SpaceScienceSweden/ulv_electronics/electronics_design_document.odt

Electronics design document

Umeå Lunar Venture

This purpose of this document is to list some of the design choices in the fieldmill instrument which will hitch a ride to the moon courtesy of PTScientists as part of the Lunar XPrize.

# Overview

The purpose of the experiment is to measure the static electric field on the lunar surface. There are more than one way to do this. After going through the relevant literature it was decided that a traditional fieldmill is the best approach given our time and budget constraints.

There are two fieldmills, mounted at right angles. Each fieldmill has a sensor board with amplifiers as close to the sensor plates as possible. There are three channels on each board (six in total), spaced 120° apart. Each channel consists of two sensor plates, across which a differential measurement is taken, giving six plates ("pie pieces") per fieldmill. The rest of the electronics is housed in a single card stack in the bottom rear of the instrument.

The demodulation of the amplified signals can be done either digitally or in the analog domain. The end result is some set of digital values which will be sent back down to Earth. Having a high dynamic range is important, since the magnitude of the field is not well known. There are two major ways to acheive this: either use one or more PGAs before each ADC, or pick ADCs with very high resolution (32-bit). The latter would almost always be preferable, but high-resolution ADCs are quite limited in speed.

## Unsolved design problems

### Remote programmer

Due to the risk of programming error and unforseen problems there needs to be some way to reprogram the instrument from the ground. Since we are aiming at using an ATmegaS128 something similar to an in-circuit serial programmer is needed. The device needs to be possible to operate with a 2.5 s time lag. One suggestion to solve this is to use some inherently rad-tolerant and simple design. So far an anti-fuse based one-time-programmable (OTP) FPGA seems like the best bet, like the iCE40HX series. This series has the benefit of open source tools. Other devices might also be possible. The idea then is to send commands via radio, which are delivered to the device over UART. Some kind of addressing scheme is needed to differentiate the CPU from the programming tool, since both sit on the same UART. Once all new program data is buffered its hash should be sent back to let the user be absolutely sure everything went OK before pulling the trigger. Something like HMAC should be used to ensure only authorized users can reprogram the instrument.

### Remote debugger

Something like JTAG, if possible.

### TX-only backup telemetry link

In case the radio on the lander fails but we still have power, some kind of low-power one-way link would be useful. Some back-of-the-envelope link budget calculations indicate that a dipole (TX) to 2 m dish (RX) over a distance of 400,000 km would require 10 mJ/bit to transfer reliably. For a typical 100 mW transmitter IC like Si4430 or Si4464 this means a massive 10 bit/s. Since the amount of data per measurement is quite small this is OK.

# Mechanical design

The electronics is built on a stack of cards connected with pin headers. The distance between pins are in multiples of 100 mil (2.54 mm) so that the cards become "breadboard compatible".

An initial guess that 20+20 pins on a square card would be enough was made at the start of summer 2015, and seems to be enough so far. Therefore the dimensions of each card is 50.8x50.8 mm with two 20-pin rows (one on each side) separated 1.9 inch (48.26 mm) from eachother. There is also a notch in the middle of one side to indicate proper orientation. See figure 1 below.

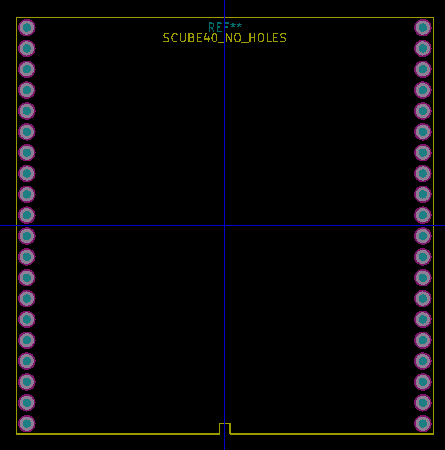
[picture p5: figure]

Fig. 1: Pin placement

# Pin assignment

The pins are assigned in the same order as DIL packages, from the top left order in counter-clockwise direction seen from above.

Text in gray italics indicates an assignment which is deprecated.

## Left side (pins 1-20)

The pins on the left side are counted top-left to bottom-left from 1 to 20.

Pin | Name | Function
1
2
3
4 | EN_APWR | 3.3V signal for enabling analog power (+-12V, +-9V)
5 | CHANNEL | Sets channel on demodulation cards. 0V = channel a, 3.3V = channel b
6 | A0 | Sets AD8250 amplification on fieldmill cards. See AD8250 datasheet
7 | A1
8 | TACHa | Tachometer signal from fieldmill a. +-9V
9 | TACHb | Tachometer signal from fieldmill b. +-9V
10 | GND | Ground
11 | +24V | Raw system voltage provided by lander. May vary depending on battery charge state, amount of sun hitting solar panels etc.. Power limit: 10 W average. May use more power in short bursts, such as when starting motors
12 | /CS_ADCa | Chip select pin for ADC a. Active low
13 | /CS_ADCb | Chip select pin for ADC b. Active low
14 | +3.3V | 3.3V from switching power module. Not suitable for analog circuits
15 | f_ADC | ADC clock
16
17 | +9V | +-9V, linearly regulated from +-12V. Suitable for analog circuits
18 | -9V
19 | +12V | +-12V from switching power module. +-9V is linearly regulated from this bus. 83 mA max. Not suitable for analog circuits
20 | -12V

## Right side (pins 21-40)

The pins on the right side are counted bottom-right to top-right from 21 to 40.

Pin | Name | Function
21 | SCL | I2C bus, clock
22 | SDA | I2C bus, data
23 | MISO | SPI data from slave to master
24 | MOSI | SPI data from master to slave
25 | SCLK | SPI clock
26 | LO2 | Local oscillator for demodulation card 2. 0V - 3.3V
27 | AIN1 | AIN1 (PE3) pin on CPU. Comparator
28 | AIN0 | AIN0 (PE2) pin on CPU. Comparator
29 | ADC3 | ADC3 (PF3) pin on CPU
30 | TX | UART, instrument to lander
31 | RX | UART, lander to instrument
32 | LO1 | Local oscillator for demodulation card 1. 0V - 3.3V
33 | ADC2 | ADC2 (PF2) pin on CPU
34 | ADC1 | ADC1 (PF1) pin on CPU
35 | ADC0 | ADC0 (PF0) pin on CPU
36
37
38
39 | /DRDYb | /DRDY signal from ADC b. Active low
40 | /DRDYa | /DRDY signal from ADC a. Active low

# CPU

We currently plan on using the ATmegaS128 as our main CPU. It is the 3.3V radiation tolerant version of ATmega128, running at a reduced speed of 8 MHz.

# I²C

The following devices are connected to the I2C bus:

- DRV10983 (2)
- MCP3428 (1 or 2)

## I2C bus switches

The DRV10983 has only a single address, 101 0010. Since we need at least two drivers some way to separate the two is needed. Luckily an I2C bus switch like TCA9543A, TCA9544A or PCA9548A can accomplish this.

Of the suggested devices, TCA9543A has the smallest package. It has two channels and its address is 11100xx, where the last two bits are set by pins A0 and A1. The largest one is PCA9548A, which has eight channels and an address of 1110xxx, where the lowest three bits are A0, A1 and A2. This suggests we could put all swiches with eight channels at 11101xx and those with only two channels at 11100xx.

## Addresses

Address | I2C sw channel | I2C sw address | Device
1010010 | 0 | 1110000 | DRV10983 1 on ESC card
1010010 | 1 | 1110000 | DRV10983 2 on ESC card
1101000 | | | MCP3428, demodulator 1 (Adr0=lo, Adr1=lo)
1101010 | | | MCP3428, demodulator 2 (Adr0=lo, Adr1=hi)
1110000 | | | TCA9543A on ESC card

# Fieldmill card

The fieldmill cards are 85x85 mm with M3 holes placed in each corner at (+-35, +-35). There is a 35 mm hole in the middle for the motors to pass through.

## Input stage

The sensor plates on the fieldmill stator are have an extremely high source impedance in the 100-1000 MOhm range. It is therefore very important that the input amplifiers have very low bias currents, preferably much lower than the source current. This is not always possible, so the next best thing would be to keep the bias low enough that the demodulation step is able to remove it.

## Signal levels

Knowing roughly what signal levels we're dealing with will be helpful.

The classical way to calculate sensor currents in a field mill is

V = n f %varepsilon_0 E A R

A = (pi*42² - pi*18²) / 6 = 754 mm² = 7.54e-4 m²

n = 3

e0 = 8.85e-12

f (Hz) | E (V/m) | R | V
100 | 1 | 1M | 2 µV
100 | 1000 | 1M | 2000 µV
100 | 1 | 10M | 20 µV
100 | 1000 | 10M | 20000 µV
100 | 1
100 | 1000

# Digital demodulation

Digital demodulation can be done in two ways: either sampling using the MCU:s internal ADC, or using an external high-precision ADC.

## MCU method

The cheapest way to demodulate the signal (and thus extract its amplitude) is to sample it using the ATmegaS128 via a bias input stage to bring the signals into range and to protect the ADC inputs.

The main limitation of this approach is the speed of the analog-to-digital converter inside the ATmegaS128, and its resolution. For instance, the default configuration in the Arduino library puts it at 10 bit resolution and a maximum sample rate of 9600 Hz. This means there will be some phase offset between channels if more than one channel is sampled at a time, and the dynamic range will be limited.

For digital demodulation to work the signal must be sampled at least four times faster than its fundamental frequency, and appropriately low-pass filtered to avoid aliasing. The reason for sampling the signal four times per cycle instead of the two times implied by the sampling theorem is to extract a complex valued amplitude (I + Q*j). This is done by multiplying the sampled signal by the sine and cosine of the shaft angle times the number of openings in the rotor. The multiplied signals are accumulated in either of two integers, one for the I part and one for Q, on a per-channel basis. The following piece of Arduino code demonstrates this for three channels:

static void interrupt() {

//disable interrupts

sei();

//NOTE: analogRead() is measured as taking 112 µs (9600 Hz)

// keep this in mind

int a = analogRead(0);

int b = analogRead(1);

int c = analogRead(2);

//re-enable interrupts

cli();

unsigned char phase = cursample * (256 * PAIRS / SAMPLES_PER_REV);

//demodulation

I[0] += a*sintab[phase];

Q[0] += a*sintab[(phase2 + 64) % 256];

I[1] += b*sintab[(phase2 + 1) % 256]; //pretend phase offset = 1 brad

Q[1] += b*sintab[(phase2 + 65) % 256];

I[2] += c*sintab[(phase2 + 2) % 256];

Q[2] += c*sintab[(phase2 + 66) % 256];

cursample++;

}

### Limitations

As mentioned in the section above, the main limitation is the speed of the ADC. For example, a 300 Hz signal at four samples per cycle, three channels requires a sample rate of at least 300*4*3 = 3600 Hz. To make the design of the antialiasing filter easier we may need to sample at twice this rate, 7200 Hz. So the ADC is 1.33x as fast as we need it to be, in other words just fast enough.

The second limitation is computing power. Atmel's 8-bit AVRs can perform an 8x8-bit multiplication in 2 cycles and all other 8-bit arithmetic operations in a single cycle. This means we have 8000000 / 7200 ≃ 1000 cycles worth of operations available per sample, or 500 multiplications. A 16x8-bit multiplication is six cycles plus storage, so the demodulation for one sample is on the order of 20 cycles. This means 50x more cycles at our disposal compared to what we need, a comfortably wide margin.

## External high-precision ADC

This idea is quite similar, just replacing the MCU's internal ADC with an external one. The limiting factor then becomes finding a high-precision ADC which can also run at around 10 kSPS. Candidates are AD7177-2 (2.5 µVrms @ 10 kSPS) and ADS1262 (0.466 µVrms @ 14.4 kSPS)

# Analog demodulator

An analog demodulator would consist of a input filter stage to limit the bandwidth of the signal, a mixer to bring it down to DC followed by a low-pass filter to get rid of any higher-order mixing components and to reduce noise. The resulting signal can then be sampled by a slow high-precision ADC.

## Input stage

An active RC band-pass filter would suffice for each channel, or two second-order RC filters (one low-pass and one high-pass).

## Local oscillator

The local oscillator (LO) for the demodulator is generated by the CPU from the active motor's corresponding TACH channel. The CPU can also phase shift this signal by 90° to extract the quadrature part of the sensor signals.

More specifically, the LO is generated by setting up a hardware interrupt on the rising edge of either TACHa or TACHb. The interrupt measures the time taken since the last interrupt, and sets up a timer such that six timer interrupts will happen before the next tachometer interrupt. In each of these six interrupts the LO pin is toggled. The exact positions of these timer interrupts thus determines the phase of the LO signal.

Generating an in-phase LO followed by its quadrature version some time later allows both components to be measured for each sensor channel. This makes the system less sensitive to the exact position of the tachometer relative to the shaft.

## Mixer

For the mixer there are two major variants: using an analog multiplier such as AD633, or a voltage negater followed by an analog mux.

### Analog multiplier

Experiments show that the AD633 is suficiently accurate for our purposes. It is a four-quadrant device, meaning both inputs can be positive or negative. The output is the product of both differential inputs, divided by ten and shifted by a third input:

W = (X1 - X2)(Y1 - Y2)/10 + Z

Each analog multiplier is fed with a sensor signal and an appropriately level shifted and filtered version of the LO. Both signals must be kept within the levels specified in the AD633's datasheet, roughly +-4.25V for a +-9V supply.

The LO should be shifted such that its amplitude is very carefully controlled. A suggestion is to use two 2.5V references to set up a precision +-2.5V rail, followed by an analog mux controlled by the LO. If the resulting signal is appropriately low-pass filtered then the signal going into the mixer will be sinusodial (with an amplitude of 2.5*4/pi ≃ 3.2 V), which helps reduce the amount of harmonics being mixed down to DC. If the maximum amplitude of the sensor signals is +-4V and a bias of Z = 1.024 (half of the ADC reference voltage) then the output of the demodulator falls within 1.024 +- 4*2.5/10 = [0.024, 2.024] V. This falls nicely into the middle of the range of an ADC with a 2.048 Volt reference.

The voltage reference chosen is ADR5041BRTZ-R2, for high accuracy (0.1%) and low temperature coefficient (<75 ppm/°C). REF2925AIDBZR was considered at first, but has much lower accuracy (2%) and higher temperature coefficient (100 ppm/°C).

Inaccuracies in this approach are mostly due to the AD633. There's also some bias currents to account for, both in filters and the input of AD633.

### Voltage negater + analog mux

This approach is based around negating the input signal, then controlling an analog mux with the LO to feed either the original signal or its negated version to the next step. This means the input is multiplied by 1 or -1.

A negater can be formed by an op amp in the inverting configuration with unit gain (both resistances equal).

One major limitation with this approach is that the LO will always be a square wave. On the other hand it is a much simpler design with fewer parts.

Inaccuracies in this approach are mostly due to resistor tolerances on the negaters and the usual bias currents.

## Low-pass filter

This filter acts as the antialiasing filter of the ADC. It must therefore attenuate signals above the Nyquist frequency to below 1 LSB (62.5 µV for MCP3428). A second-order active RC filter with a low enough cutoff frequency can accomplish this task.

## Analog-to-digital converter

A high-precision ADC is needed. Its bandwidth doesn't need to be very large - sampling three 1 Hz channels at four times the Nyquist frequency would require 1*3*4 = 12 samples per second (SPS). The MCP3428 currently used provides 16-bit accuracy at 15 SPS. High-precision ADCs like the AD7177-2 or the ADS1262 mentioned earlier in this document would provide even more precision and almost twice the dynamic range. To be more explicit, the ADS1262 running at its slowest mode with the highest gain is limited by an input noise of 7 nVrms. One LSB at this gain is 2.5/(32*2³¹) = 36 pV, meaning the noise is on the order of 190 LSBs. Dialling the gain down allows measuring up to +-2.5 V, for a total dynamic range of 20*log10(2.5/7e-9) = 171 dB.
