SpaceScienceSweden/ulv_electronics/cpu4/fab/cpu4-1.1-complete/cpu4.png

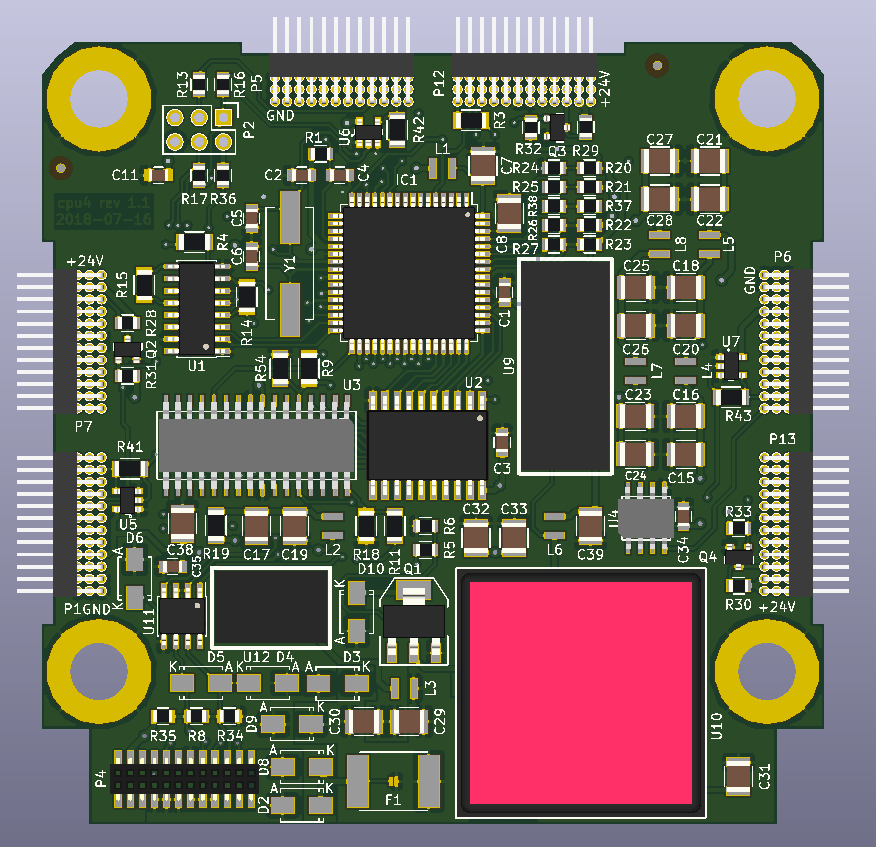
cpu4/fab/cpu4-1.1-complete/cpu4.png
