SpaceScienceSweden/ulv_electronics/credits/uggla.png

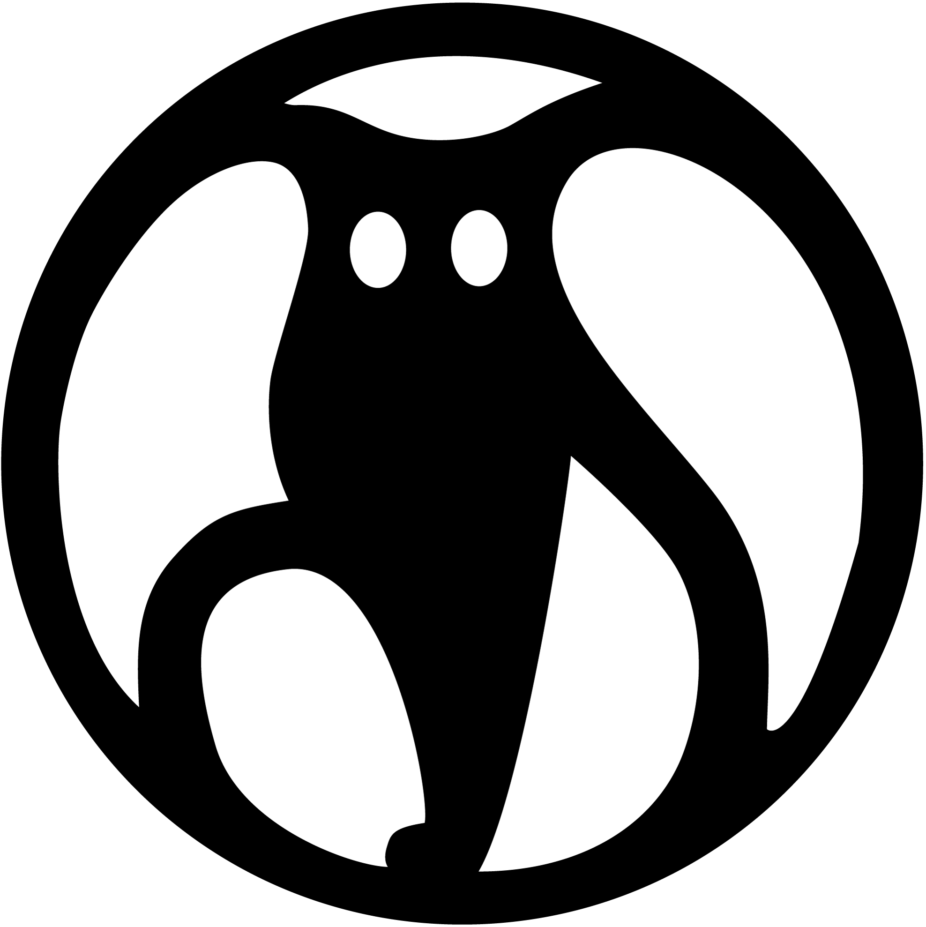
credits/uggla.png
