SpaceScienceSweden/ulv_electronics/cpu4/fab/cpu4-1.1-complete/cpu4_reel_specs.ods

Component | References | Value | Kapselns riktning på bandet | Relevant figur | Länk | Footprint | Quantity Per PCB | Mfg. Name | Mfg. Part Number | Digikey PN | Farnell PN | Elfa PN | Mouser PN | Min temp | Max temp | Digikey Link | Farnell Link | Elfa Link
1 | C1 C2 C3 C4 C34 C35 | 100n | Vertikal |  | https://product.tdk.com/info/en/catalog/spec/mlccspec_automotive_soft_en.pdf | C_0805 | 6 | TDK | CGA4J3X7T2E104M125AE | 445-7965-1-ND | 2211003 |  | 810-CGA4J3X7T2E104MS | -55 | 125 | https://www.digikey.se/product-detail/en/tdk-corporation/CGA4J3X7T2E104M125AE/445-7965-1-ND/2782533 | https://se.farnell.com/tdk/cga4j3x7t2e104m125ae/cap-mlcc-x7t-100nf-250v-0805/dp/2211003
2 | C7 C8 | 100n | Vertikal, size code G3 |  | https://industrial.panasonic.com/cdbs/www-data/pdf/RDI0000/DMI0000COL24.pdf | C_1210 | 2 | Panasonic | ECH-U1C104GX5 | PCF1189CT-ND | 9695001 | 300-41-614 | 667-ECH-U1C104GX5 | -55 | 125 | https://www.digikey.se/product-detail/en/panasonic-electronic-components/ECH-U1C104GX5/PCF1189CT-ND/353736 | https://se.farnell.com/panasonic-electronic-components/echu1c104gx5/cap-film-pps-100nf-16v-smd/dp/9695001 | https://www.elfa.se/sv/kondensator-100-nf-16-vdc-panasonic-automotive-industrial-systems-echu1c104gx5/p/30041614
3 | C15 C16 C17 C18 C19 C20 C21 C22 C23 C24 C25 C26 C27 C28 C32 C33 | 10u10V | Vertikal |  | https://content.kemet.com/datasheets/KEM_C1008_X8L_150C_SMD.pdf | C_1210 | 16 | KEMET | C1210X106K8NACAUTO | 399-17273-1-ND |  |  | 80-C1210X106K8NAUTO | -55 | 150 | https://www.digikey.se/product-detail/en/kemet/C1210X106K8NACAUTO/399-17273-1-ND/8602584
4 | C29 C30 C31 C38 C39 | 10u50V | Vertikal | Samma som rad 1 | https://product.tdk.com/info/en/catalog/spec/mlccspec_automotive_soft_en.pdf | C_1210 | 5 | TDK | CGA6P3X7S1H106K250AE | 445-8792-1-ND | 2435524 |  | 810-CGA6P3X7S1H106KS | -55 | 125 | https://www.digikey.se/product-detail/en/tdk-corporation/CGA6P3X7S1H106K250AE/445-8792-1-ND/3248604 | https://se.farnell.com/tdk/cga6p3x7s1h106k250ae/kond-mlcc-x7s-10uf-50v-1210/dp/2435524
5 | C5 C6 | 22p | Vertikal | Samma som rad 3 | https://content.kemet.com/datasheets/KEM_C1008_X8L_150C_SMD.pdf | C_0805 | 2 | KEMET | C0805X220J5GACTU | 399-7432-1-ND |  |  | 80-C0805X220J5G | -55 | 125 | https://www.digikey.se/product-detail/en/kemet/C0805X220J5GACTU/399-7432-1-ND/3317466
6 | D4 D5 D6 | 12V | Bidirektionell, inga träffar på ”Rollenspezifikation 824501121” | ? | ? | SMA_Standard | 3 | Würth | 824501121 | 732-9949-1-ND | 2536587 | 300-59-541 | 710-824501121 | -65 | 150 | https://www.digikey.se/product-detail/en/wurth-electronics-inc/824501121/732-9949-1-ND/5871103 | https://se.farnell.com/wurth-elektronik/824501121/tvs-diod-400w-12v-dbl-rikt-do/dp/2536587 | https://www.elfa.se/sv/transientskyddsdiod-12-400-sma-wuerth-elektronik-824501121/p/30059541
7 | D3 D9 D10 | 40V | Bidirektionell, inga träffar på ”Rollenspezifikation 824501401” | ? | ? | SMA_Standard | 3 | Würth | 824501401 | 732-9960-1-ND | 2536561 | 300-59-556 | 710-824501401 | -65 | 150 | https://www.digikey.se/product-detail/en/wurth-electronics-inc/824501401/732-9960-1-ND/5871113 | https://se.farnell.com/wurth-elektronik/824501401/tvs-diod-400w-40v-dbl-rikt-do/dp/2536561 | https://www.elfa.se/sv/transientskyddsdiod-40-400-sma-wuerth-elektronik-824501401/p/30059556
9 | F1 | Polyfuse_Small | Vertikal |  | https://belfuse.com/resources/CircuitProtection/datasheets/0ZCF%20Nov2016.pdf | Fuse_SMD2920 | 1 | Bel Fuse Inc. | 0ZCF0100AF2A | 507-2070-1-ND |  |  | 530-0ZCF0100AF2A | -40 | 85 | https://www.digikey.se/product-detail/en/bel-fuse-inc/0ZCF0100AF2A/507-2070-1-ND/6210547
8 | D2 D8 | STTH102A | Vertikal, katod överst |  | https://www.st.com/content/ccc/resource/technical/document/technical_note/1f/54/8e/63/63/81/4a/ea/DM00111342.pdf/files/DM00111342.pdf/jcr:content/translations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 | SMA_Standard | 2 | STMicroelectronics | STTH102A | 497-2500-1-ND | 9907874 | 300-34-074 | 511-STTH102A | -65 | 175 | https://www.digikey.se/product-detail/en/stmicroelectronics/STTH102A/497-2500-1-ND/603882 | https://se.farnell.com/stmicroelectronics/stth102a/diode-ultrafast-1a-200v-sma/dp/9907874 | https://www.elfa.se/sv/likriktardiod-sma-200-st-stth102a/p/30034074
10 | IC1 | ATMEGA128L-8AN | 14x14 mm TQFP 64-pin → pinne 1 = upp, höger (kvadrant 2 i figur) |  | http://ww1.microchip.com/downloads/en/DeviceDoc/00000151Q.pdf | TQFP-64_14x14mm_Pitch0.8mm | 1 | Microchip Technology / Atmel | ATmega128L–8AN | ATMEGA128L-8AN-ND |  |  | 556-ATMEGA128L-8AN | -40 | 105 | https://www.digikey.se/product-detail/en/microchip-technology/ATMEGA128L-8AN/ATMEGA128L-8AN-ND/2050766
11 | L1 L2 L3 L4 L5 L6 L7 L8 | 10u | Vertikal |  | https://katalog.we-online.de/pbs/datasheet/74479887310A.pdf | L_1008 | 8 | Würth | 74479887310A | 732-4516-1-ND |  | 300-63-549 | 710-74479887310A | -40 | 125 | https://www.digikey.se/product-detail/en/wurth-electronics-inc/74479887310A/732-4516-1-ND/4120134 |  | https://www.elfa.se/sv/drossel-smd-10-uh-850-ma-20-wuerth-elektronik-74479887310a/p/30063549
14 | Q1 | IRLL024NPBF | Tabb (pinne 4) uppåt |  | http://info.incomp.hu/NETPDF/IRLL024NPBF.pdf | SOT-223 | 1 | Infineon Technologies | IRLL024NPBF | IRLL024NPBF-ND | 8651205 | 171-37-904 | 942-IRLL024NPBF | -55 | 150 | https://www.digikey.se/product-detail/en/infineon-technologies/IRLL024NPBF/IRLL024NPBF-ND/856814 | https://se.farnell.com/infineon/irll024npbf/mosfet-n-55v-4-4a-sot-223/dp/8651205 | https://www.elfa.se/sv/mosfet-55-sot-223-ir-irll024npbf/p/17137904
15 | Q2 Q3 Q4 | PMBF170 | Enskild pinne 3 = uppåt |  | https://assets.nexperia.com/documents/packing/SOT23_185.pdf | SOT-23 | 3 | Nexperia | PMBF170,215 | 1727-5173-1-ND | 1081473 | 171-30-701 | 771-PMBF170-T/R | -65 | 150 | https://www.digikey.se/product-detail/en/nexperia-usa-inc/PMBF170215/1727-5173-1-ND/2531764 | https://se.farnell.com/nexperia/pmbf170-215/mosfet-n-sot-23/dp/1081473 | https://www.elfa.se/sv/liten-signaltransistor-sot-23-60-nxp-pmbf170/p/17130701
25 | U3 | 71V124SA12YGI | ”IDT reel specification” ger inga relevanta länkar |  | https://www.idt.com/document/dst/71v124sa-datasheet | SOJ-32 | 1 |  |  | 800-1460-5-ND |  |  | 972-71V124SA12YGI | -40 | 85 | https://www.digikey.se/product-detail/en/idt-integrated-device-technology-inc/71V124SA12YGI/800-1460-5-ND/1915761
26 | U1 | CD74AC153M96 | Pinne 1 = upp, vänster |  | http://www.ti.com/lit/ds/symlink/cd74ac153.pdf | SOIC-16_3.9x9.9mm_Pitch1.27mm | 1 | Texas Instruments | CD74AC153M96 | 296-4229-1-ND | 2334932 |  | 595-CD74AC153M96 | -55 | 125 | https://www.digikey.se/product-detail/en/texas-instruments/CD74AC153M96/296-4229-1-ND/375128 | http://se.farnell.com/texas-instruments/cd74ac153m96/data-selector-mux-dual-4-1-soic/dp/2334932
27 | U4 | DS18B20Z+ | Pinne 1 = upp, vänster |  | https://www.maximintegrated.com/en/design/packaging/package-information/smd-tape-reel-info.html | SOIC-8-N | 1 | Maxim Integrated | DS18B20Z+ | DS18B20Z+-ND | 2518724 |  | 700-DS18B20Z | -55 | 125 | https://www.digikey.se/product-detail/en/maxim-integrated/DS18B20Z/DS18B20Z-ND/956982 | https://se.farnell.com/maxim-integrated-products/ds18b20z/ic-thermometer-12bit-0-5degc-soic/dp/2518724
28 | U11 | MAX3483ESA+ | Samma som DS18B20Z+ | -"- | -"- | SOIC-8_3.9x4.9mm_Pitch1.27mm | 1 | Maxim Integrated | MAX3483ESA+ | MAX3483ESA+-ND | 2519249 |  | 700-MAX3483ESA | -40 | 85 | https://www.digikey.se/product-detail/en/maxim-integrated/MAX3483ESA/MAX3483ESA-ND/1702246 | https://se.farnell.com/maxim-integrated-products/max3483esa/ic-transceiver-rs422-rs485-8soic/dp/2519249
29 | U2 | SN74AHC573 | Pinne 1 = upp, vänster |  | http://www.ti.com/lit/ds/symlink/sn74ahc573.pdf | SO-20 | 1 | Texas Instruments | SN74AHC573DW | 296-4612-5-ND | 1287471 | 300-22-908 | 595-SN74AHC573DW | -40 | 85 | https://www.digikey.se/product-detail/en/texas-instruments/SN74AHC573DW/296-4612-5-ND/375821 | https://se.farnell.com/texas-instruments/sn74ahc573dw/latch-d-type-octal-smd-soic20/dp/1287471 | https://www.elfa.se/sv/logikkrets-so-20-sn74ahc573-texas-instruments-sn74ahc573dw/p/30022908
30 | Y1 | 14.7456 MHz | Vertikal |  | https://abracon.com/Resonators/abls.pdf | Crystal_HC49-SD_SMD | 1 | Abracon | ABLS-14.7456MHZ-K4T | 535-9946-1-ND |  |  | 815-ABLS-14.74MK4-T | -40 | 125 | https://www.digikey.se/product-detail/en/abracon-llc/ABLS-14.7456MHZ-K4T/535-9946-1-ND/2001569
