SpaceScienceSweden/ulv_electronics/fieldmill10/fab/fieldmill10-rev4.3/fieldmill10_reel_specs.ods

 | Design | Revision |  | Revisionshistorik
 | fieldmill10 | 4.2 | Grön = ändrad mellan 4.0 → 4.1 | 4.0 → 4.1: Ändrade 10 µF komponentval (item 3) Korrigerade Elfa artikelnr (item 8) Tog bort R8 men röd färg var något tvetydligt. Även fel antal på den raden (item 13) Bytte 50 Ohm → 49.9 Ohm (item 19)
 |  |  | Blå = ändrad mellan 4.1 → 4.2 | 4.1 → 4.2: Ändrade färg på ändrade celler i item 13 till blå, för att signalera en förändring och att inte allihop ska tas bort Korrigerade även antal till 5 på item 13 Tog bort gul och röd från färgskalan, gjorde så att celler markeras med en färg som hör till revisionsförändring istället
ITEM | Antal | Info | Position | Kapselns riktning på bandet | Relevant figur | Länk | Benämning Typ/värde | Tolerans/Spänning | Kapsel | Monteringssätt | Typbestämd | Generell | Förslag Leverantör | Leverantörs artikelnummer | Digikey PN | Farnell PN | Elfa PN | Mouser PN | Digikey Link | Farnell Link | Elfa Link
1 | 13 |  | C3 C20 C24 C25 C26 C28 C29 C56 C57 C58 C59 C60 C61 | Vertikal | Se cpu4_reel_specs.ods |  | Cap film 100n | ±2% 16V PPS | C_1210 | SMD | x |  | Panasonic | ECH-U1C104GX5 | PCF1189CT-ND | 9695001 | 300-41-614 | 667-ECH-U1C104GX5 | https://www.digikey.se/product-detail/en/panasonic-electronic-components/ECH-U1C104GX5/PCF1189CT-ND/353736 | https://se.farnell.com/panasonic-electronic-components/echu1c104gx5/cap-film-pps-100nf-16v-smd/dp/9695001 | https://www.elfa.se/sv/kondensator-100-nf-16-vdc-panasonic-automotive-industrial-systems-echu1c104gx5/p/30041614
2 | 4 |  | C7 C10 C11 C23 | Vertikal | Se cpu4_reel_specs.ods |  | Cap film 10n | ±2% 16V PPS | C_0805 | SMD | x |  | Panasonic | ECH-U1C103GX5 | PCF1177CT-ND | 9694897 | 300-41-612 | 667-ECH-U1C103GX5 | https://www.digikey.se/product-detail/en/panasonic-electronic-components/ECH-U1C103GX5/PCF1177CT-ND/353724 | https://se.farnell.com/panasonic-electronic-components/echu1c103gx5/cap-film-pps-10nf-16v-smd/dp/9694897 | https://www.elfa.se/sv/kondensator-10-nf-16-vdc-panasonic-automotive-industrial-systems-echu1c103gx5/p/30041612
3 | 12 |  | C2 C4 C5 C8 C9 C12 C14 C17 C18 C19 C22 C31 | Vertikal | Se cpu4_reel_specs.ods |  | Cap cer 10u | ±20% 10V X7R soft termination or better | C_0805 | SMD | x |  | TDK | CGA4J1X7S1C106K125AE | 445-173674-1-ND |  |  | 810-CGA4J1X7S1C106KA | https://www.digikey.se/product-detail/en/tdk-corporation/CGA4J1X7S1C106K125AE/445-173674-1-ND/5809745
4 | 6 |  | C21 C30 C32 C36 C38 C42 | Vertikal |  | http://www.cde.com/resources/catalogs/MC.pdf | Cap silver mica 1p | ±0.5pF 100V mica | C_0805 | SMD | x |  | Cornell Dubilier Electronics | MC08CA010D-F | 338-1339-ND | 1610819 |  | 5982-08-100V1.0-F | https://www.digikey.se/product-detail/en/cornell-dubilier-electronics-cde/MC08CA010D-F/338-1339-ND/969296 | https://se.farnell.com/cornell-dubilier/mc08ca010d-f/capacitor-rf-microwave-1pf-100v/dp/1610819
5 | 3 |  | C6 C13 C16 | Vertikal | Se cpu4_reel_specs.ods |  | Cap cer 1u | ±10% 25V X7R soft termination | C_0805 | SMD | x |  | KEMET | C0805X105K3RACAUTO | 399-6996-1-ND | 2478267 |  | 80-C0805X105K3RAUTO | https://www.digikey.se/product-detail/en/kemet/C0805X105K3RACAUTO/399-6996-1-ND/3314504 | https://se.farnell.com/kemet/c0805x105k3racauto/kondensator-mlcc-x7r-1-f-25v-0805/dp/2478267
6 | 1 |  | C1 |  |  | https://search.murata.co.jp/Ceramy/image/img/A01X/G101/ENG/GCJ32ER70J476KE01-01.pdf | Cap cer 47u | ±10% 6.3V X7R soft termination | C_1210 | SMD | x |  | Murata | GCJ32ER70J476KE01L | 490-10559-1-ND |  |  | 81-GCJ32ER70J476KE1L | https://www.digikey.se/product-detail/en/murata-electronics-north-america/GCJ32ER70J476KE01L/490-10559-1-ND/5030050
7 | 1 |  | D2 | Vertikal, katod överst |  | http://www.onsemi.com/pub/Collateral/BRD8011-D.PDF | 1SMA5919BT3G | ±5% 5.6V 1.5W | SMA_Standard | SMD | x |  | ON Semiconductor | 1SMA5919BT3G | 1SMA5919BT3GOSCT-ND | 1431141 | 300-50-189 | 863-1SMA5919BT3G | https://www.digikey.se/product-detail/en/on-semiconductor/1SMA5919BT3G/1SMA5919BT3GOSCT-ND/917675 | https://se.farnell.com/on-semiconductor/1sma5919bt3g/diode-zener-5-6v-1-5w/dp/1431141 | https://www.elfa.se/sv/zenerdiod-sma-on-semiconductor-1sma5919bt3g/p/30050189
8 | 3 |  | D1 D3 D4 | Vertikal, katod överst | Se cpu4_reel_specs.ods |  | STTH102A | 1A 200V | SMA_Standard | SMD | x |  | STMicroelectronics | STTH102A | 497-2500-1-ND | 9907874 | 300-34-074 | 511-STTH102A | https://www.digikey.se/product-detail/en/stmicroelectronics/STTH102A/497-2500-1-ND/603882 | https://se.farnell.com/stmicroelectronics/stth102a/diode-ultrafast-1a-200v-sma/dp/9907874 | https://www.elfa.se/sv/likriktardiod-sma-200-st-stth102a/p/30034074
9 | 1 |  | IR2 | Säljs endast i rör? |  |  | LPPB032NFSP-RC | Low outgassing, 50 mil | LPPB032NFSP-RC | SMD | x |  | Sullins | LPPB032NFSP-RC | S9007E-03-ND |  |  |  | https://www.digikey.com/product-detail/en/sullins-connector-solutions/LPPB032NFSP-RC/S9007E-03-ND/1786349
10 | 12 |  | L1 L2 L3 L4 L5 L6 L7 L8 L9 L10 L11 L12 | Vertikal |  | https://www.johansontechnology.com/downloads/johanson-all-inductor-packaging.pdf | Ind chip 56n | Self res. >= 23GHz | C_0603 | SMD | x |  | Johanson | L-14C56NJV4T | 712-1443-1-ND |  |  | 609-L-14C56NJV4T | https://www.digikey.se/product-detail/en/johanson-technology-inc/L-14C56NJV4T/712-1443-1-ND/1914893
11 | 2 |  | P12 P13 | Säljs endast i rör? |  |  | LPPB122NFSP-RC | Low outgassing, 50 mil | LPPB122NFSP-RC | SMD | x |  | Sullins | LPPB122NFSP-RC | S9007E-12-ND |  |  |  | https://www.digikey.com/products/en?keywords=LPPB122NFSP-RC
14 | 6 |  | R30 R32 R33 R35 R36 R42 | Vertikal |  | https://www.vishay.com/docs/60034/tapereel.pdf | 100M | 1%, ±100ppm/°C | R_1206 | SMD | x |  | Vishay | CRHV1206AF100MFK | CRHV100MACT-ND | 1109056 |  | 71-CRHV1206AF100MFKF | https://www.digikey.se/product-detail/en/vishay-dale/CRHV1206AF100MFKE5/CRHV100MACT-ND/2499032 | https://se.farnell.com/vishay/crhv1206af100mfkft/motst-tunnfilm-100m-1-0-3w-1206/dp/1109056
20 | 1 |  | U3 | Pinne 1 = upp, höger |  | http://www.ti.com/lit/ds/symlink/ads131a04.pdf | ADS131A04IPBS | -40°C .. +125°C industrial | LQFP-32_5x5mm_Pitch0.5mm | SMD | x |  | Texas Instruments | ADS131A04IPBS | 296-47690-ND | 2580620 |  | 595-ADS131A04IPBS | https://www.digikey.se/product-detail/en/texas-instruments/ADS131A04IPBS/296-47690-ND/5994569 | https://se.farnell.com/texas-instruments/ads131a04ipbsr/adc-delta-sigma-24bit-128ksps/dp/2580620
21 | 1 |  | U5 | Pinne 1 = upp, vänster | Se cpu4_reel_specs.ods |  | DS18B20Z+ | -55°C .. +125°C | SOIC-8_3.9x4.9mm_Pitch1.27mm | SMD | x |  | Maxim Integrated | DS18B20Z+ | DS18B20Z+-ND | 2518724 |  | 700-DS18B20Z | https://www.digikey.se/product-detail/en/maxim-integrated/DS18B20Z/DS18B20Z-ND/956982 | https://se.farnell.com/maxim-integrated-products/ds18b20z/ic-thermometer-12bit-0-5degc-soic/dp/2518724
22 | 1 |  | U10 | Tabb mot hål (uppåt) |  | https://www.smd.ru/upload/medialibrary/118/sot_223.pdf Ej försthands | LDL1117S25R | -40°C .. +125°C | SOT-223 | SMD | x |  | STMicroelectronics | LDL1117S25R | 497-17237-1-ND | 2778100 |  | 511-LDL1117S25R | https://www.digikey.se/product-detail/en/stmicroelectronics/LDL1117S25R/497-17237-1-ND/7102077 | https://se.farnell.com/stmicroelectronics/ldl1117s25r/ldo-fixed-2-5v-1-2a-sot-223-4/dp/2778100
23 | 1 |  | U9 | Tabb uppåt Pinne 1 = ner, vänster |  | http://www.ti.com/lit/ds/symlink/lm137.pdf | LM337IMP/NOPB | -40°C .. +125°C industrial | SOT-223 | SMD | x |  | Texas Instruments | LM337IMP/NOPB | LM337IMP/NOPBCT-ND | 2781817 | 173-28-875 | 926-LM337IMP/NOPB | https://www.digikey.se/product-detail/en/texas-instruments/LM337IMP-NOPB/LM337IMP-NOPBCT-ND/270746 | https://se.farnell.com/texas-instruments/lm337imp-nopb/linear-volt-reg-1-2-37v-1-5a-sot223/dp/2781817 | https://www.elfa.se/sv/spaenningsregulator-37-sot-223-lm337-texas-instruments-lm337imp-nopb/p/17328875
24 | 3 |  | U4 U6 U8 | Pinne 1 = upp, vänster |  | http://www.analog.com/media/en/technical-documentation/white-papers/tape-and-reel-packaging.pdf | LTC6241HS8#TRPBF | -40°C .. +125°C industrial | SOIC-8_3.9x4.9mm_Pitch1.27mm | SMD | x |  | Linear Technology/Analog Devices | LTC6241HS8#TRPBF | LTC6241HS8#TRPBFCT-ND |  |  | 584-LTC6241HS8#TRPBF | https://www.digikey.com/product-detail/en/linear-technology-analog-devices/LTC6241HS8-TRPBF/LTC6241HS8-TRPBFCT-ND/7914681
25 | 1 |  | U7 | Pinne 1 = upp, vänster | Se cpu4_reel_specs.ods | https://www.maximintegrated.com/en/design/packaging/package-information/smd-tape-reel-info.html | MAX44252ASD+ | -40°C .. +125°C | SOIC-14_3.9x8.7mm_Pitch1.27mm | SMD | x |  | Maxim Integrated | MAX44252ASD+ | MAX44252ASD+-ND | 2510952 |  | 700-MAX44252ASD+ | https://www.digikey.se/product-detail/en/maxim-integrated/MAX44252ASD/MAX44252ASD-ND/2816359 | https://se.farnell.com/maxim-integrated-products/max44252asd/op-f-rst-rkare-10mhz-8v-s-nsoic/dp/2510952
26 | 1 |  | U2 | Pinne 1 = upp, vänster | -"- | -"- | MAX504ESD | -40°C .. +85°C | SOIC-14_3.9x8.7mm_Pitch1.27mm | SMD | x |  | Maxim Integrated | MAX504ESD+ | MAX504ESD+-ND | 2514723 |  | 700-MAX504ESD | https://www.digikey.se/product-detail/en/maxim-integrated/MAX504ESD/MAX504ESD-ND/1512537 | https://se.farnell.com/maxim-integrated-products/max504esd/d-a-omvandlare-10bit-nsoic-14/dp/2514723
