SpaceScienceSweden/ulv_electronics/UmeaLunarVenture3/Komponentlista 3.ods

Namn | Footprint | Artikel # | Antal | Länk
Switching Voltage Regulators
Switchregulator 1000 mA MSOP-8A | MSOP-8 | MCP16311-E/MS | 10 | http://se.farnell.com/microchip/mcp16311-e-ms/dc-dc-switching-reg-buck-500khz/dp/2414134?ost=MCP16311-E%2FMS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
Resistors
10 kOhm | Package: 0603 | RC0603FR-0710KL | 30 | http://se.farnell.com/yageo-phycomp/rc0603fr-0710kl/motst-tjockfilm-10k-1-0-1w-0603/dp/9238603
31.6 kOhm (For +3.3V) | Package: 0603 | MC0063W0603131R6 | 20 | http://se.farnell.com/multicomp/mc0063w0603131r6/motst-tjockfilm-31r6-1-0-063w/dp/1170638
52.3 kOhm (For +5 V) | Package: 0603 | ERJP03F5232V | 20 | http://se.farnell.com/panasonic-electronic-components/erjp03f5232v/motst-tjockfilm-52k3-1-0-2w-0603/dp/2312081
140 kOhm (For +12 V) | Package: 0603 | ERJ3EKF1403V | 20 | http://se.farnell.com/panasonic-electronic-components/erj3ekf1403v/motst-tjockfilm-140k-1-0-1w-0603/dp/2059504
1 kOhm (For Crowbars) | Package: 0603 | RC0603FR-071KL | 20 | http://se.farnell.com/yageo-phycomp/rc0603fr-071kl/motst-tjockfilm-1k-1-0-1w-0603/dp/9238484
Capacitors
Kondensator 0.1 uF 50 VDC 0805 | Package: 0805 | C0805C104J5RACTU | 20 | http://se.farnell.com/kemet/c0805c104j5ractu/cap-mlcc-x7r-100nf-50v-0805/dp/1414663
Kondensator 1 uF 50 VDC 0805 | Package: 0805 | C0805C105K5RACTU | 15 | http://se.farnell.com/kemet/c0805c105k5ractu/cap-mlcc-x7r-1uf-50v-0805/dp/2118131
Kondensator 10 uF 16 VDC 0805 | Package: 0805 | GRM21BR61C106KE15L | 30 | http://se.farnell.com/murata/grm21br61c106ke15l/cap-mlcc-x5r-10uf-16v-0805/dp/1762635
Kondensator 47 nF 50 VDC 0805 | Package: 0805 | C0805F473K5RACTU | 10 | http://se.farnell.com/kemet/c0805f473k5ractu/cap-mlcc-x7r-47nf-50v-0805/dp/1288270
Kondenstator 150 uF | 2312 [6032 metrisk] | 293D157X96R3C2TE3 | 8 | http://se.farnell.com/vishay/293d157x96r3c2te3/cap-tant-150uf-6-3v-case-c/dp/1754155
Inductors
15 µH, ± 20%, 0805 ((For +3.3V) | Package: 0805 | MLZ2012N150LT | 8 | http://se.farnell.com/tdk/mlz2012n150lt/spole-15-h-20-0-35a-0805/dp/2493072?ost=Inductor+15+uH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
22 µH, ± 20%, 0805 (For +5V) | Package: 0805 | MLZ2012M220WT | 8 | http://se.farnell.com/tdk/mlz2012m220wt/inductor-shielded-22uh-20/dp/2215653
56 µH, ± 5%, 1210 (For +12V) | Package: 1210 | NLV32T-560J-PF | 8 | http://se.farnell.com/tdk/nlv32t-560j-pf/inductor-signal-line-56uh-1210/dp/1669950
Thyristor
Thyristor SOT-223 600 V 1.25 A | SOT-223 | X0202NN 5BA4 | 15 | http://se.farnell.com/stmicroelectronics/x0202nn-5ba4/scr-800v-1-25a-sot-223/dp/1748967
Zener diode
Zener diode SOT-23 15 V 350 mW | SOT-23 | DZ23C15-7-F | 8 | http://se.farnell.com/diodes-inc/dz23c15-7-f/diode-dual-zener-15v-0-3w-sot23/dp/1773572
Zenerdiod SOT-23 5.6 V 200 mW | SOT-23 | BZX84-C5V6 | 8 | http://se.farnell.com/nxp/bzx84-c5v6/diode-zener-5-6v-0-25w/dp/1081431
Zenerdiod SOT-23 3.9 V | SOT-23 | BZX84C3V9 | 8 | http://se.farnell.com/diodes-inc/bzx84c3v9/diode-zener-3-9v-0-35w-sot23-3/dp/1902458
Schottky Diode
Schottkydiod 0.2 A 30 V SOT-23 | SOT-23 | BAT54A | 12 | http://se.farnell.com/diodes-inc/bat54a/diode-schottky-dual/dp/9526498
Fuses
Resettable PTC Fuse 2.2 A, 33 V | 2920 | SMD100F/33-2 | 13 | http://se.farnell.com/te-connectivity-raychem/smd100f-33-2/s-kring-ptc-terst-llbar-33vdc/dp/2473646
(Extra mackapär, +-9V)
DC/DC converter (-1.5V to -12V) | SOIC-8N | TC7660SEOA |  | http://se.farnell.com/microchip/tc7660seoa/ic-dc-dc-convertor-45khz-soic/dp/1439746?ost=TC7660SEOA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
