SpaceScienceSweden/ulv_electronics/code/manual/3mm7mm.jpg

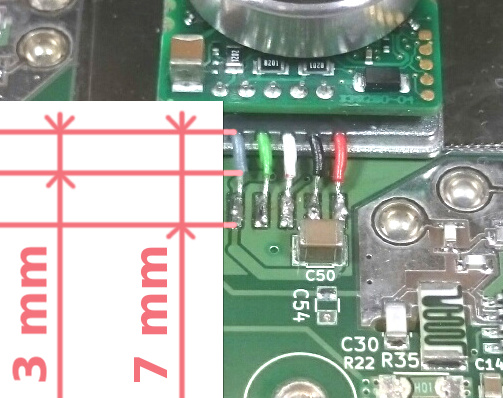
code/manual/3mm7mm.jpg
