SpaceScienceSweden/ulv_electronics/code/manual/motors.jpg

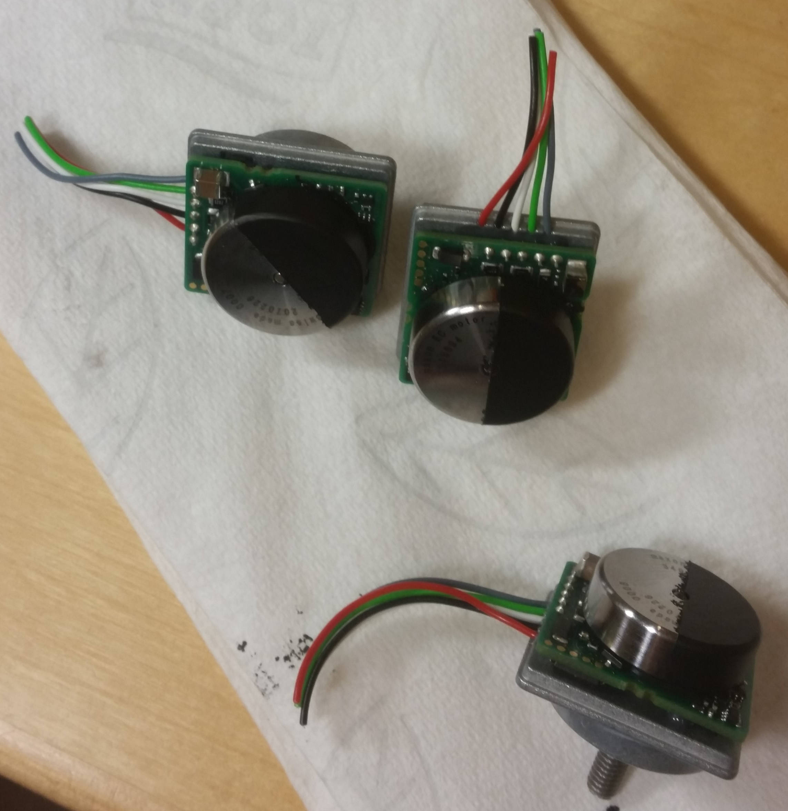
code/manual/motors.jpg
