SpaceScienceSweden/ulv_electronics/code/manual/power4.jpg

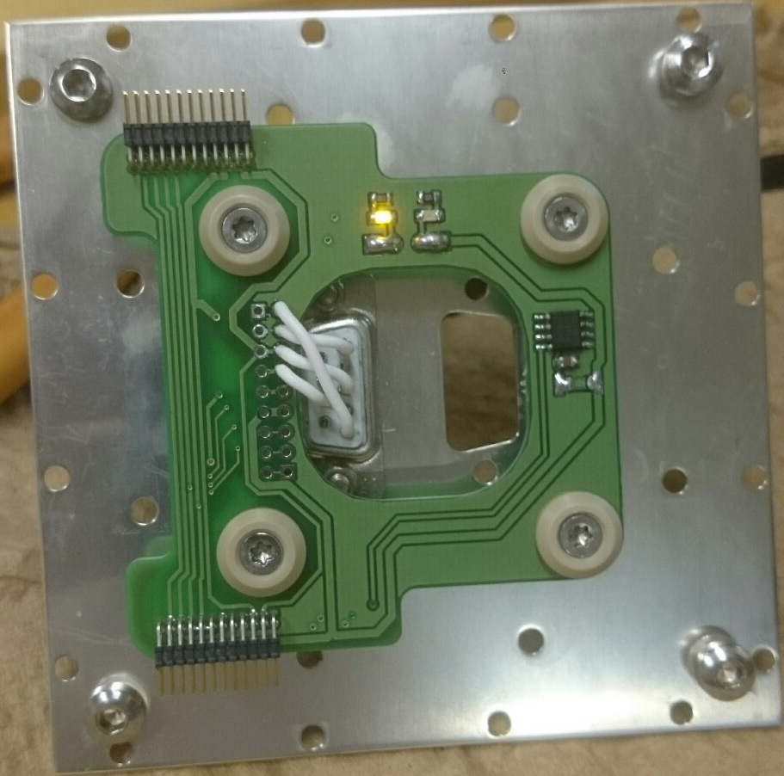
code/manual/power4.jpg
