SpaceScienceSweden/ulv_electronics/code/manual/reflectometer.jpg

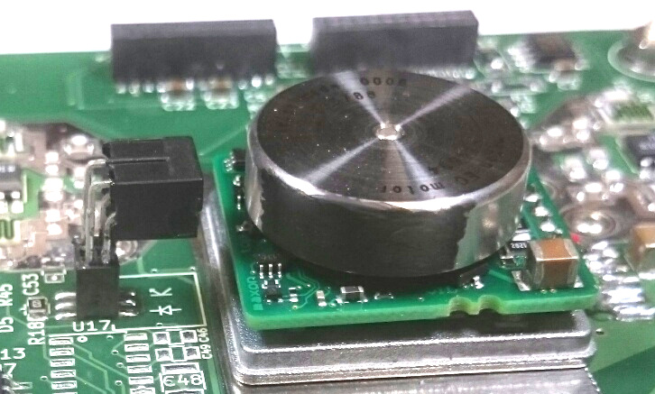
code/manual/reflectometer.jpg
