SpaceScienceSweden/ulv_electronics/fieldmill2/bottom.pdf

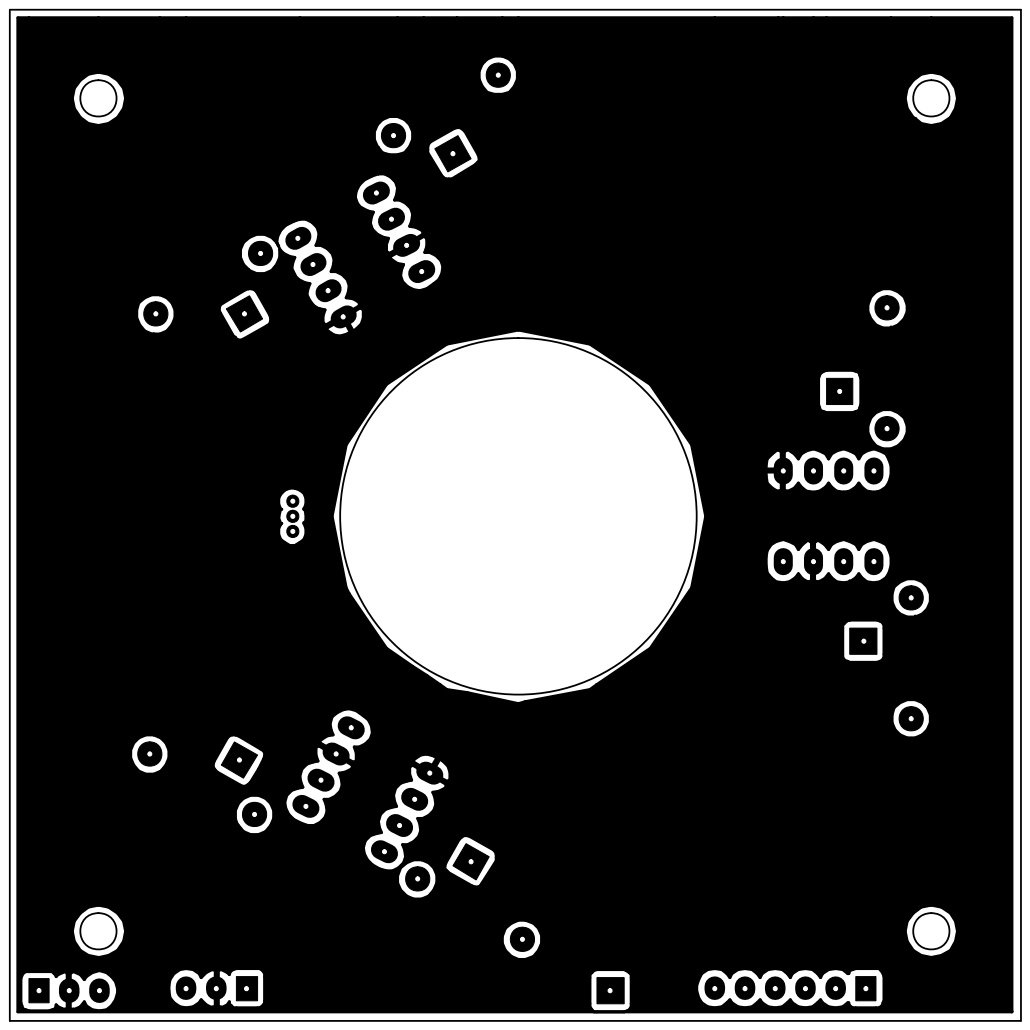
[picture p12: page 1]
