SpaceScienceSweden/ulv_electronics/fieldmill2/top.pdf

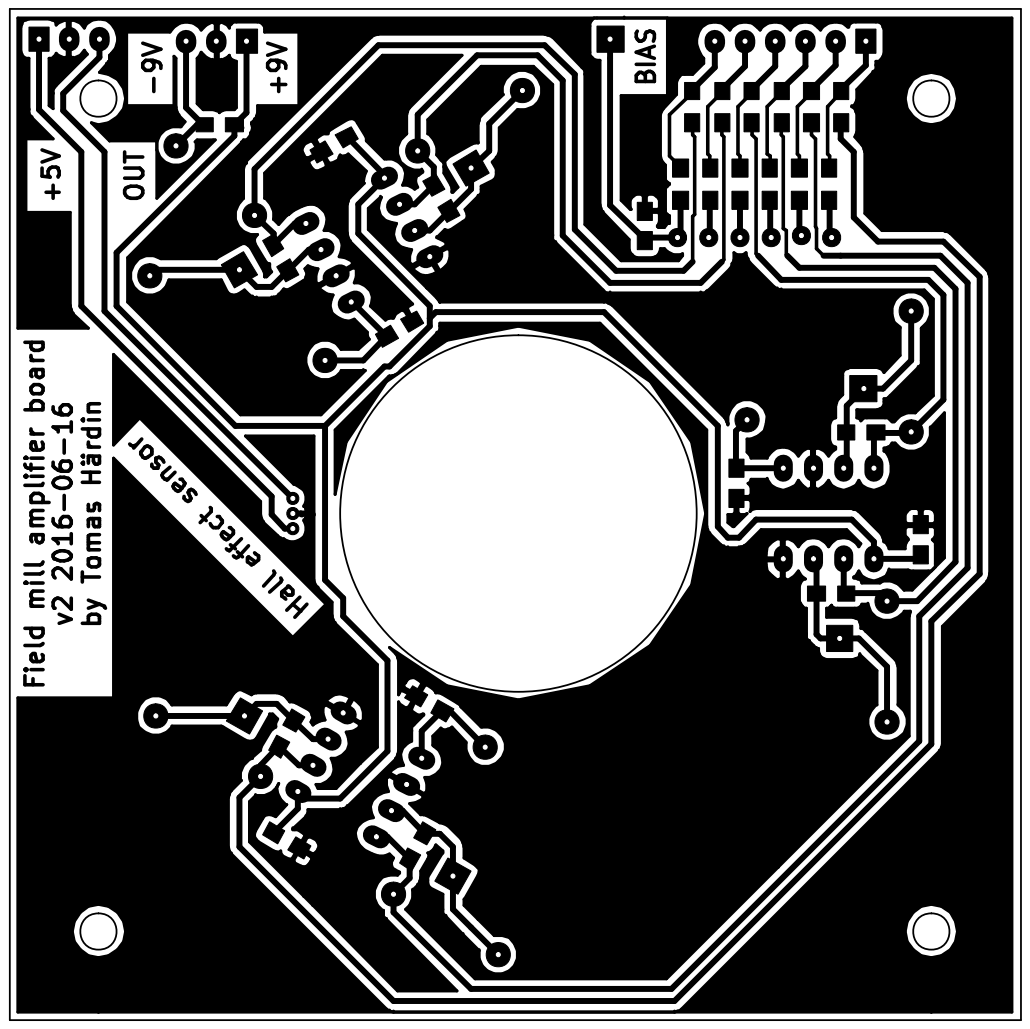
[picture p13: page 1]
