SpaceScienceSweden/ulv_electronics/credits/credits.kicad_pcb

## KiCad design credits/credits.kicad_pcb (2019-02-12)

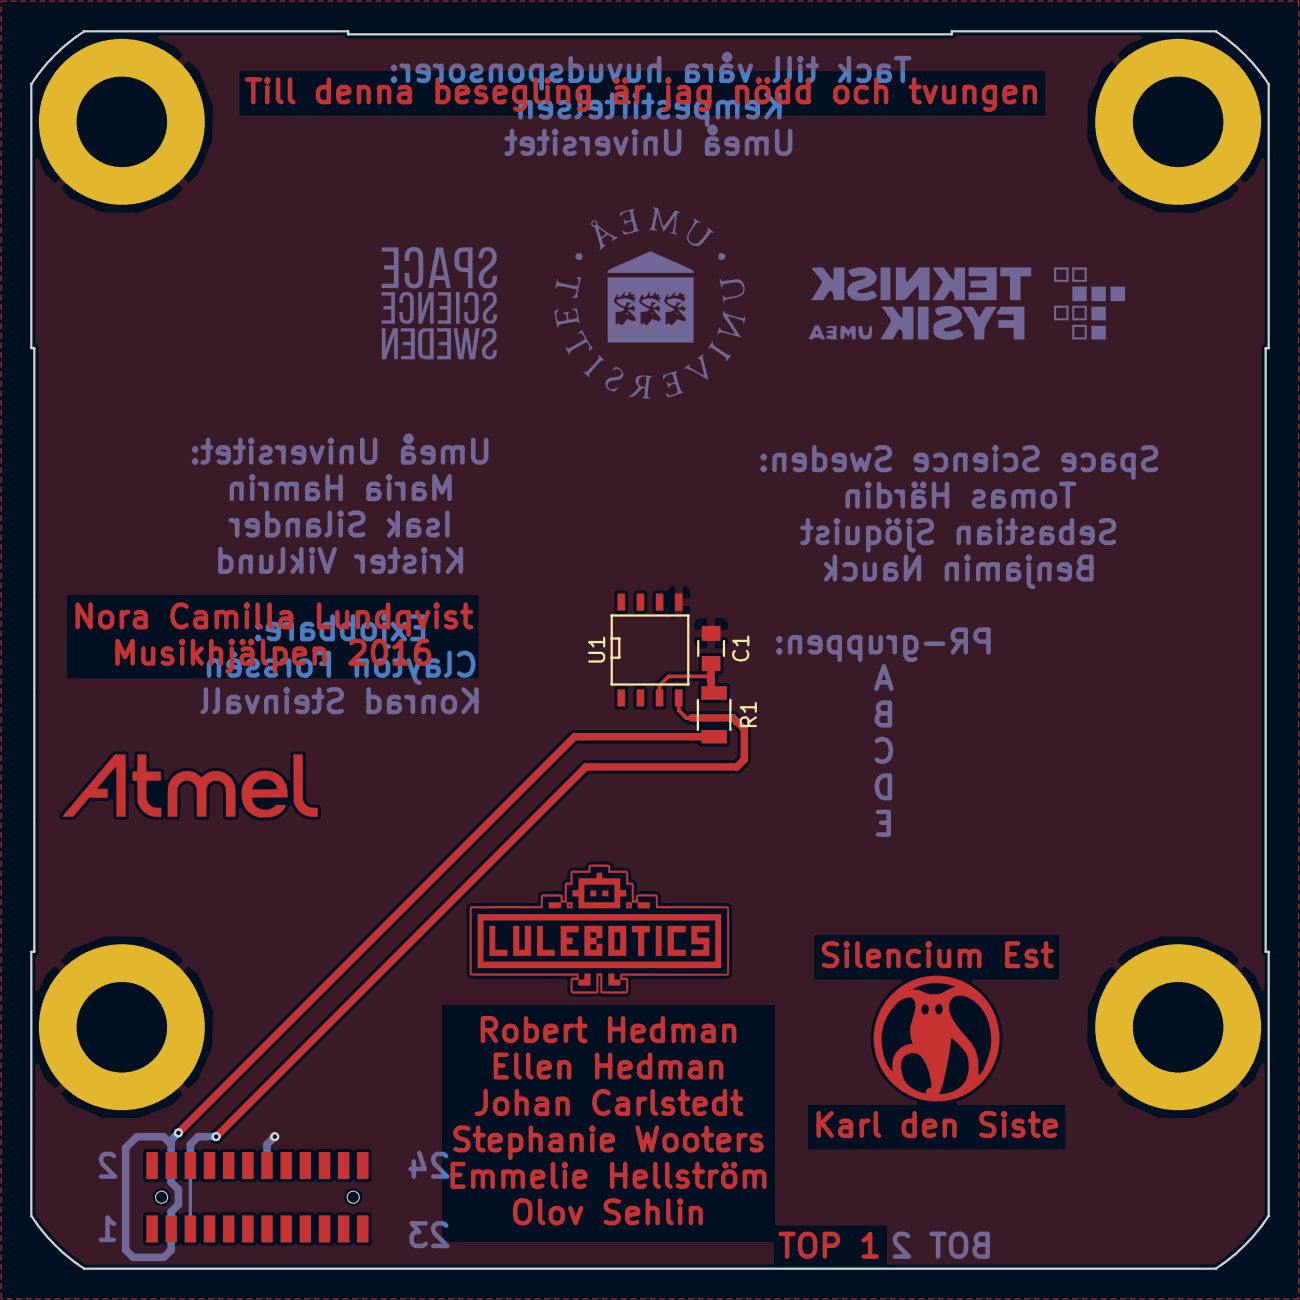
[picture p14: board credits.kicad_pcb from above]

Board: 2 copper layers, 82.0 x 82.0 mm, 8 parts (1 on the bottom side), 4 nets.

Parts:
C1: 100n; C_0805
P1: CONN_02X12; LPPB122NFSP-RC-backpads-mirrored
P8, P9, P10, P11: M6; M6_PTH
R1: 0; R_1206
U1: DS18B20Z; SOIC-8-N

Connections:
+3V3: P1.3, P1.4, R1.2
/ONEWIRE: P1.5, P1.6, U1.4
GND: C1.2, P1.13, P1.14, P1.15, P1.17, P8.1, P9.1, P10.1, P11.1, U1.5
unnamed: C1.1, R1.1, U1.3
