SpaceScienceSweden/ulv_electronics/cpu4/cpu4.kicad_pcb

## KiCad design cpu4/cpu4.kicad_pcb (2018-12-18)

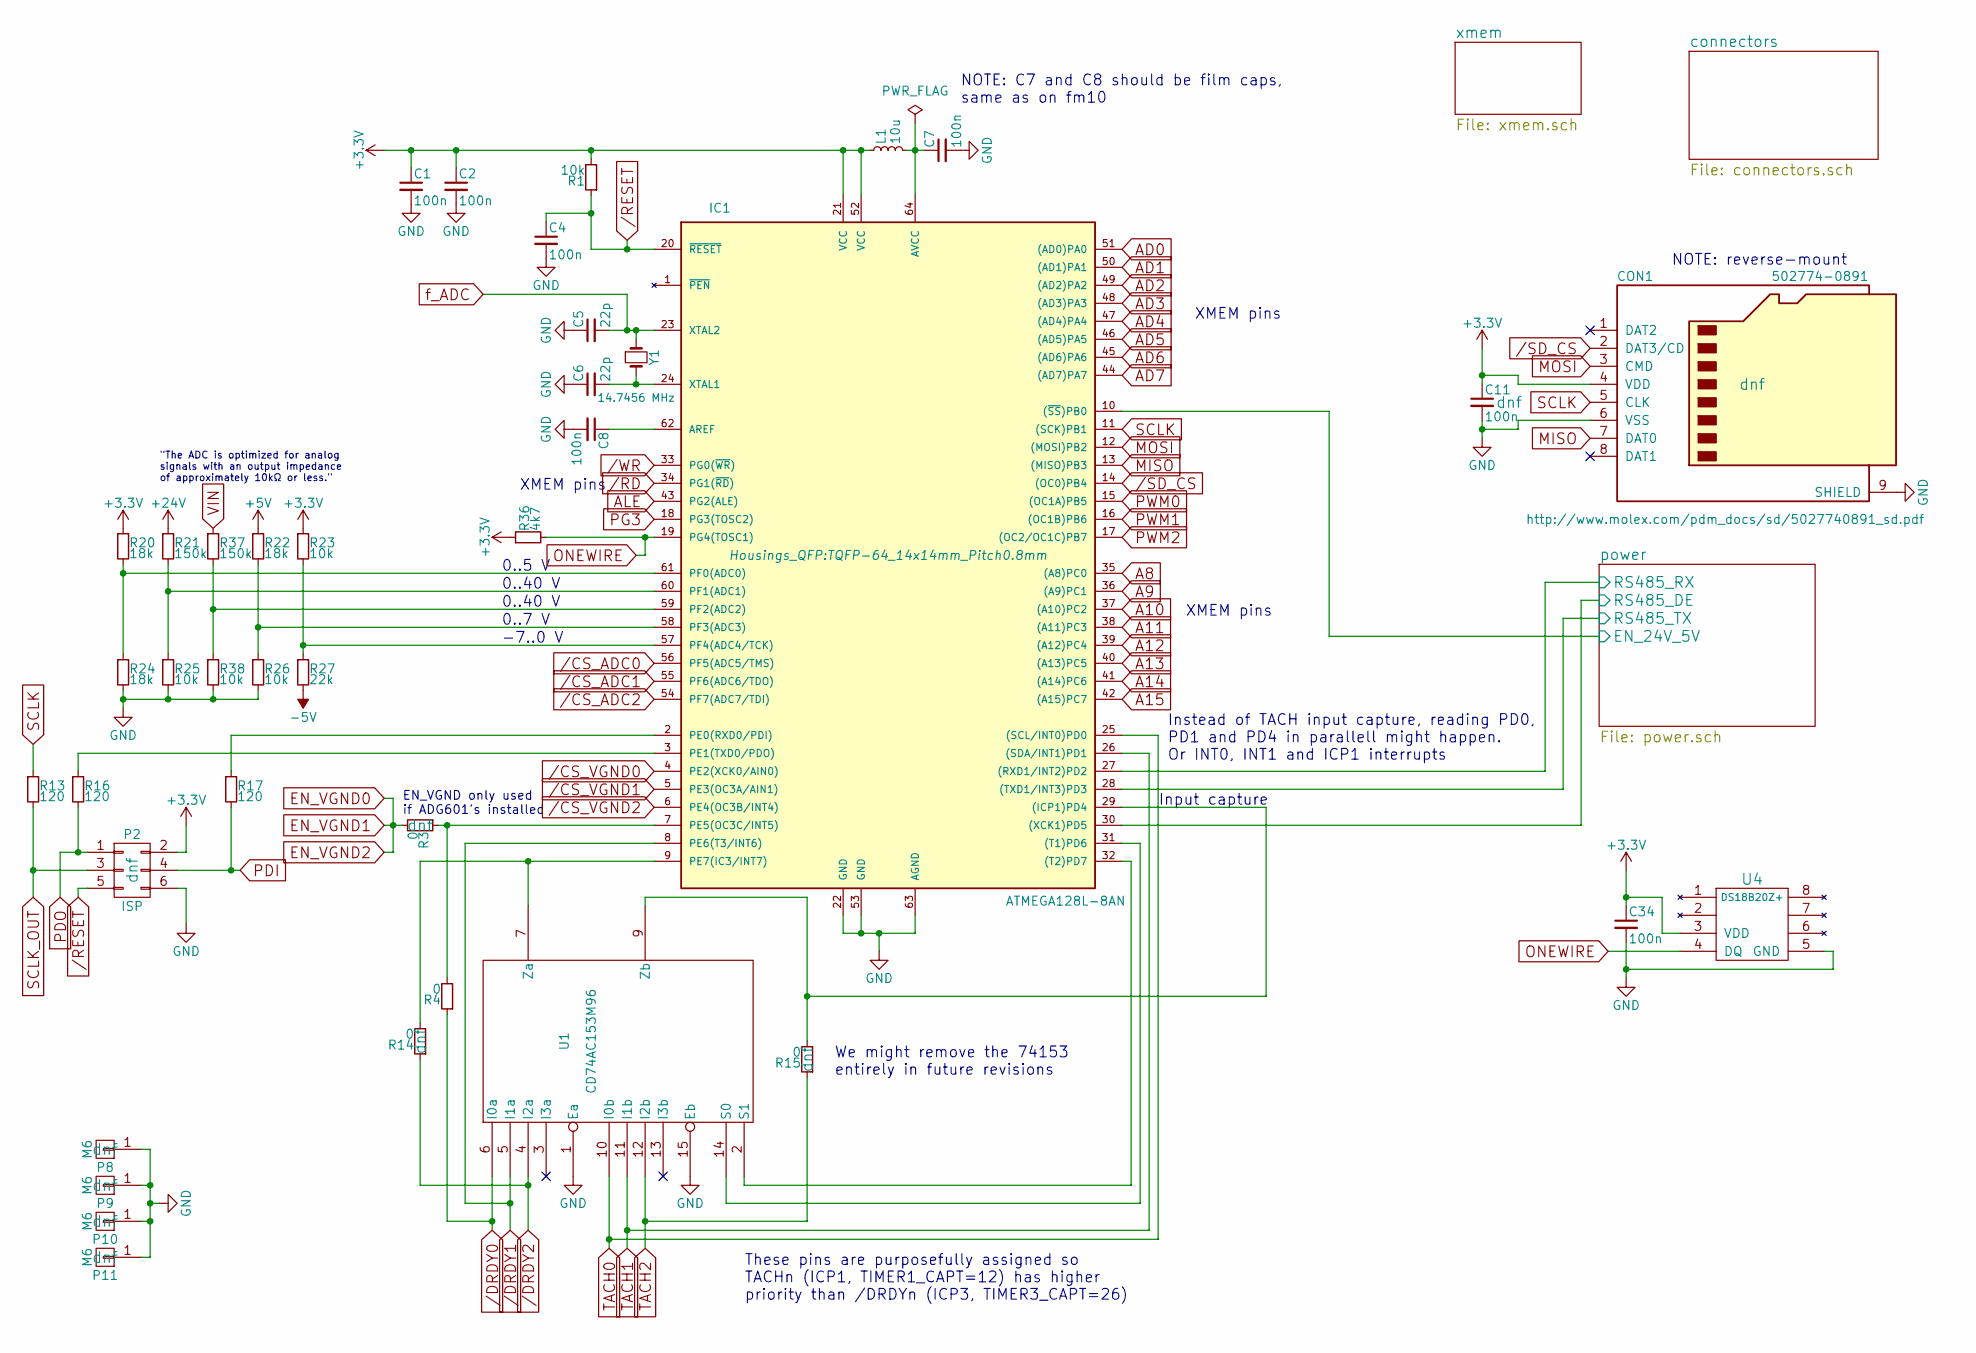
[picture p15: schematic cpu4.sch]

Parts:
C1: 100n; C_0805; Mfg. Part Number CGA4J3X7T2E104M125AE; Farnell PN 2211003
C2, C4, C11, C34: 100n; C_0805
C5: 22p; C_0805; Mfg. Part Number C0805X220J5GACTU; Mouser PN 80-C0805X220J5G
C6: 22p; C_0805
C7: 100n; C_1210; Mfg. Part Number ECH-U1C104GX5; Farnell PN 9695001
C8: 100n; C_1210
CON1: 502774-0891; Molex_502774-0891; Mfg. Part Number 502774-0891
IC1: ATMEGA128L-8AN; TQFP-64_14x14mm_Pitch0.8mm; Mfg. Part Number ATmega128L–8AN; Mouser PN 556-ATMEGA128L-8AN
L1: 10u; L_1008; Mfg. Part Number 74479887310A; Mouser PN 710-74479887310A
P2: ISP; Pin_Header_Straight_2x03
P8, P9, P10, P11: M6; M6_PTH
R1, R23, R25, R26, R38: 10k; R_0805
R3, R4, R14, R15: 0; R_1206
R13, R16, R17: 120; R_0805
R20, R22, R24: 18k; R_0805
R21, R37: 150k; R_0805
R27: 22k; R_0805
R36: 4k7; R_0805
U1: CD74AC153M96; SOIC-16_3.9x9.9mm_Pitch1.27mm; Mfg. Part Number CD74AC153M96; Farnell PN 2334932
U4: DS18B20Z+; SOIC-8-N; Mfg. Part Number DS18B20Z+; Farnell PN 2518724
Y1: 14.7456 MHz; Crystal_HC49-SD_SMD; Mfg. Part Number ABLS-14.7456MHZ-K4T; Mouser PN 815-ABLS-14.74MK4-T

Connections:
+3V3: C1.1, C2.1, C11.1, C34.1, CON1.4 (VDD), IC1.21 (VCC), IC1.52 (VCC), L1.1, P2.2, R1.2, R20.1, R23.1, R36.1, U1.16 (VCC), U4.3 (VDD); also elsewhere on the board
+5V: R22.1; also elsewhere on the board
+24V: R21.1; also elsewhere on the board
-5V: R27.2; also elsewhere on the board
/CS_ADC0: IC1.56 (PF5(ADC5/TMS)); also elsewhere on the board
/CS_ADC1: IC1.55 (PF6(ADC6/TDO)); also elsewhere on the board
/CS_ADC2: IC1.54 (PF7(ADC7/TDI)); also elsewhere on the board
/CS_VGND0: IC1.4 (PE2(XCK0/AIN0)); also elsewhere on the board
/CS_VGND1: IC1.5 (PE3(OC3A/AIN1)); also elsewhere on the board
/CS_VGND2: IC1.6 (PE4(OC3B/INT4)); also elsewhere on the board
/DRDY0: R4.1, U1.6 (I0a); also elsewhere on the board
/DRDY1: IC1.8 (PE6(T3/INT6)), U1.5 (I1a); also elsewhere on the board
/DRDY2: R14.1, U1.4 (I2a); also elsewhere on the board
/RD: IC1.34 (PG1(~RD~)); also elsewhere on the board
/RESET: C4.1, IC1.20 (~RESET), P2.5, R1.1; also elsewhere on the board
/SD_CS: CON1.2 (DAT3/CD), IC1.14 ((OC0)PB4)
/WR: IC1.33 (PG0(~WR~)); also elsewhere on the board
/power/EN_24V_5V: IC1.10 ((~SS~)PB0); also elsewhere on the board
/power/RS485_DE: IC1.30 ((XCK1)PD5); also elsewhere on the board
/power/RS485_RX: IC1.27 ((RXD1/INT2)PD2); also elsewhere on the board
/power/RS485_TX: IC1.28 ((TXD1/INT3)PD3); also elsewhere on the board
A8: IC1.35 ((A8)PC0); also elsewhere on the board
A9: IC1.36 ((A9)PC1); also elsewhere on the board
A10: IC1.37 ((A10)PC2); also elsewhere on the board
A11: IC1.38 ((A11)PC3); also elsewhere on the board
A12: IC1.39 ((A12)PC4); also elsewhere on the board
A13: IC1.40 ((A13)PC5); also elsewhere on the board
A14: IC1.41 ((A14)PC6); also elsewhere on the board
A15: IC1.42 ((A15)PC7); also elsewhere on the board
AD0: IC1.51 ((AD0)PA0); also elsewhere on the board
AD1: IC1.50 ((AD1)PA1); also elsewhere on the board
AD2: IC1.49 ((AD2)PA2); also elsewhere on the board
AD3: IC1.48 ((AD3)PA3); also elsewhere on the board
AD4: IC1.47 ((AD4)PA4); also elsewhere on the board
AD5: IC1.46 ((AD5)PA5); also elsewhere on the board
AD6: IC1.45 ((AD6)PA6); also elsewhere on the board
AD7: IC1.44 ((AD7)PA7); also elsewhere on the board
ALE: IC1.43 (PG2(ALE)); also elsewhere on the board
EN_VGND0: R3.2; also elsewhere on the board
GND: C1.2, C2.2, C4.2, C5.1, C6.1, C7.2, C8.2, C11.2, C34.2, CON1.6 (VSS), CON1.9 (SHIELD), IC1.22 (GND), IC1.53 (GND), IC1.63 (AGND), P2.6, P8.1, P9.1, P10.1, P11.1, R24.2, R25.2, R26.2, R38.2, U1.1 (Ea), U1.8 (GND), U1.15 (Eb), U4.5 (GND); also elsewhere on the board
MISO: CON1.7 (DAT0), IC1.13 ((MISO)PB3); also elsewhere on the board
MOSI: CON1.3 (CMD), IC1.12 ((MOSI)PB2); also elsewhere on the board
unnamed: C6.2, IC1.24 (XTAL1), Y1.2
unnamed: C7.1, IC1.64 (AVCC), L1.2
unnamed: C8.1, IC1.62 (AREF)
unnamed: IC1.2 (PE0(RXD0/PDI)), R17.1
unnamed: IC1.3 (PE1(TXD0/PDO)), R16.1
unnamed: IC1.7 (PE5(OC3C/INT5)), R3.1, R4.2
unnamed: IC1.9 (PE7(IC3/INT7)), R14.2, U1.7 (Za)
unnamed: IC1.29 ((ICP1)PD4), R15.2, U1.9 (Zb)
unnamed: IC1.31 ((T1)PD6), U1.14 (S0)
unnamed: IC1.32 ((T2)PD7), U1.2 (S1)
unnamed: IC1.57 (PF4(ADC4/TCK)), R23.2, R27.1
unnamed: IC1.58 (PF3(ADC3)), R22.2, R26.1
unnamed: IC1.59 (PF2(ADC2)), R37.2, R38.1
unnamed: IC1.60 (PF1(ADC1)), R21.2, R25.1
unnamed: IC1.61 (PF0(ADC0)), R20.2, R24.1
ONEWIRE: IC1.19 (PG4(TOSC1)), R36.2, U4.4 (DQ); also elsewhere on the board
PDI: P2.4, R17.2; also elsewhere on the board
PDO: P2.1, R16.2; also elsewhere on the board
PG3: IC1.18 (PG3(TOSC2)); also elsewhere on the board
PWM0: IC1.15 ((OC1A)PB5); also elsewhere on the board
PWM1: IC1.16 ((OC1B)PB6); also elsewhere on the board
PWM2: IC1.17 ((OC2/OC1C)PB7); also elsewhere on the board
SCLK: CON1.5 (CLK), IC1.11 ((SCK)PB1), R13.1; also elsewhere on the board
SCLK_OUT: P2.3, R13.2; also elsewhere on the board
TACH0: IC1.25 ((SCL/INT0)PD0), U1.10 (I0b); also elsewhere on the board
TACH1: IC1.26 ((SDA/INT1)PD1), U1.11 (I1b); also elsewhere on the board
TACH2: R15.1, U1.12 (I2b); also elsewhere on the board
VIN: R37.1; also elsewhere on the board
f_ADC: C5.2, IC1.23 (XTAL2), Y1.1; also elsewhere on the board

Notes on the sheet:
These pins are purposefully assigned so TACHn (ICP1, TIMER1_CAPT=12) has higher priority than /DRDYn (ICP3, TIMER3_CAPT=26)
XMEM pins
Input capture
"The ADC is optimized for analog signals with an output impedance of approximately 10kΩ or less."
0..40 V
0..5 V
0..7 V
-7..0 V
NOTE: reverse-mount
Instead of TACH input capture, reading PD0, PD1 and PD4 in parallell might happen. Or INT0, INT1 and ICP1 interrupts
EN_VGND only used if ADG601's installed
We might remove the 74153 entirely in future revisions
NOTE: C7 and C8 should be film caps, same as on fm10

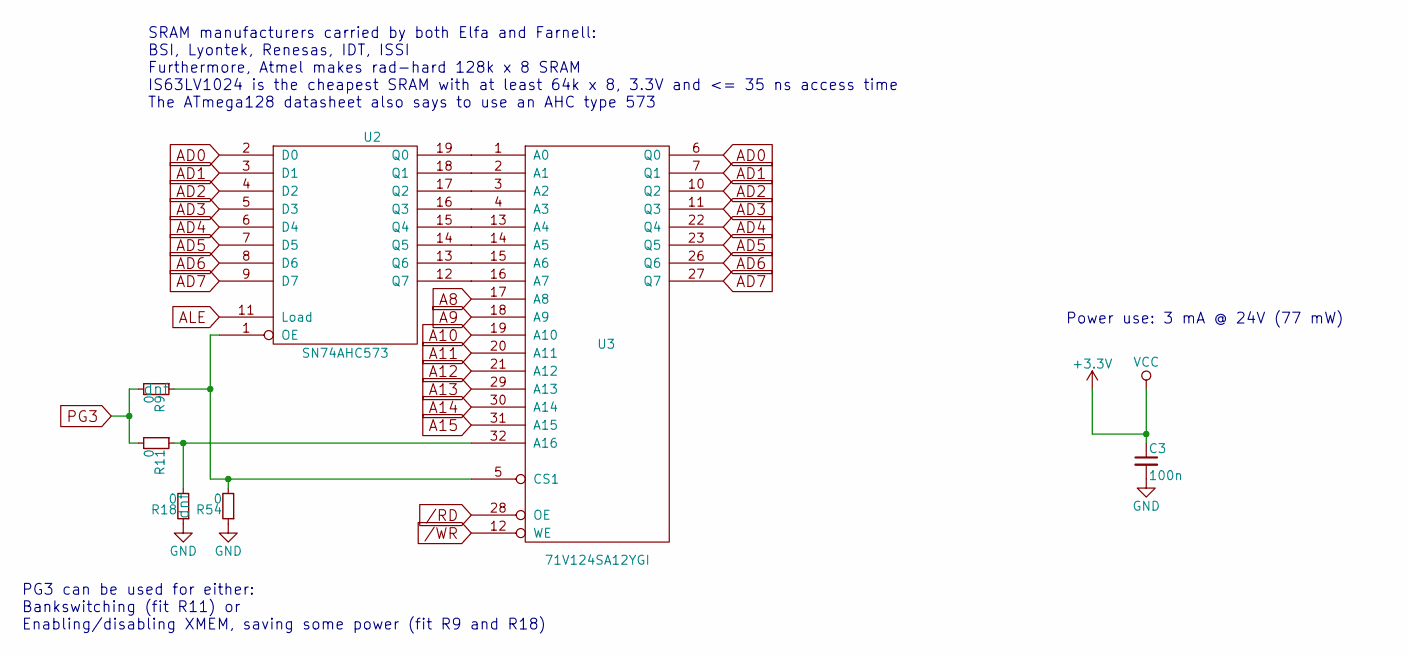
[picture p16: schematic xmem.sch, cpu4]

Parts:
C3: 100n; C_0805
R9, R11, R18, R54: 0; R_1206
U2: SN74AHC573; SO-20; Mfg. Part Number SN74AHC573DW; Farnell PN 1287471
U3: 71V124SA12YGI; SOJ-32; Mouser PN 972-71V124SA12YGI

Connections:
+3V3: C3.1, U2.20 (VCC), U3.8 (VCC), U3.24 (VCC); also elsewhere on the board
/RD: U3.28 (OE); also elsewhere on the board
/WR: U3.12 (WE); also elsewhere on the board
A8: U3.17 (A8); also elsewhere on the board
A9: U3.18 (A9); also elsewhere on the board
A10: U3.19 (A10); also elsewhere on the board
A11: U3.20 (A11); also elsewhere on the board
A12: U3.21 (A12); also elsewhere on the board
A13: U3.29 (A13); also elsewhere on the board
A14: U3.30 (A14); also elsewhere on the board
A15: U3.31 (A15); also elsewhere on the board
AD0: U2.2 (D0), U3.6 (Q0); also elsewhere on the board
AD1: U2.3 (D1), U3.7 (Q1); also elsewhere on the board
AD2: U2.4 (D2), U3.10 (Q2); also elsewhere on the board
AD3: U2.5 (D3), U3.11 (Q3); also elsewhere on the board
AD4: U2.6 (D4), U3.22 (Q4); also elsewhere on the board
AD5: U2.7 (D5), U3.23 (Q5); also elsewhere on the board
AD6: U2.8 (D6), U3.26 (Q6); also elsewhere on the board
AD7: U2.9 (D7), U3.27 (Q7); also elsewhere on the board
ALE: U2.11 (Load); also elsewhere on the board
GND: C3.2, R18.1, R54.1, U2.10 (GND), U3.9 (GND), U3.25 (GND); also elsewhere on the board
unnamed: R11.1, R18.2, U3.32 (A16)
unnamed: R9.1, R54.2, U2.1 (OE), U3.5 (CS1)
unnamed: U2.12 (Q7), U3.16 (A7)
unnamed: U2.13 (Q6), U3.15 (A6)
unnamed: U2.14 (Q5), U3.14 (A5)
unnamed: U2.15 (Q4), U3.13 (A4)
unnamed: U2.16 (Q3), U3.4 (A3)
unnamed: U2.17 (Q2), U3.3 (A2)
unnamed: U2.18 (Q1), U3.2 (A1)
unnamed: U2.19 (Q0), U3.1 (A0)
PG3: R9.2, R11.2; also elsewhere on the board

Notes on the sheet:
SRAM manufacturers carried by both Elfa and Farnell: BSI, Lyontek, Renesas, IDT, ISSI Furthermore, Atmel makes rad-hard 128k x 8 SRAM IS63LV1024 is the cheapest SRAM with at least 64k x 8, 3.3V and <= 35 ns access time The ATmega128 datasheet also says to use an AHC type 573
Power use: 3 mA @ 24V (77 mW)
PG3 can be used for either: Bankswitching (fit R11) or Enabling/disabling XMEM, saving some power (fit R9 and R18)

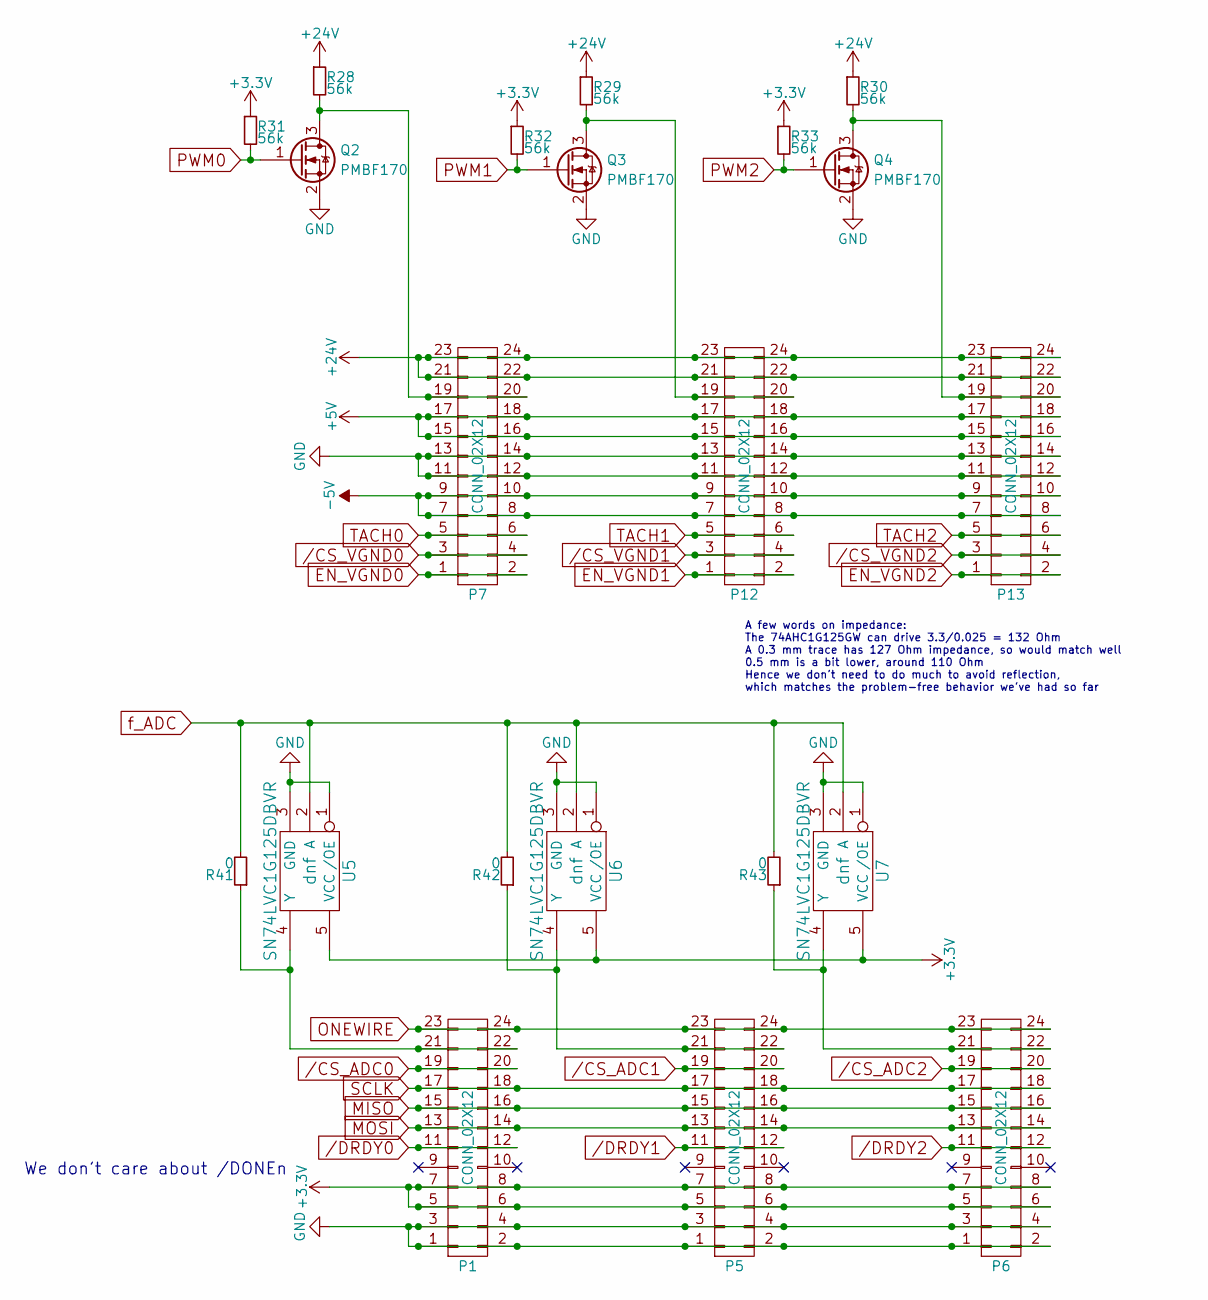
[picture p17: schematic connectors.sch, cpu4]

Parts:
P1, P5, P6, P12, P13: CONN_02X12; FTSH-112-04-L-D-RA-3x12; Mfg. Part Number FTSH-112-04-L-D-RA
P7: CONN_02X12; FTSH-112-04-L-D-RA-3x12; Mfg. Part Number FTSH-112-04-L-D-RA; Farnell PN 1767213
Q2: PMBF170; SOT-23; Mfg. Part Number PMBF170,215; Farnell PN 1081473
Q3, Q4: PMBF170; SOT-23
R28, R29, R30, R31, R32, R33: 56k; R_0805
R41, R42, R43: 0; R_1206
U5, U6, U7: SN74LVC1G125DBVR; SOT-23-5

Connections:
+3V3: P1.5, P1.6, P1.7, P1.8, P5.5, P5.6, P5.7, P5.8, P6.5, P6.6, P6.7, P6.8, R31.1, R32.1, R33.1, U5.5 (VCC), U6.5 (VCC), U7.5 (VCC); also elsewhere on the board
+5V: P7.15, P7.16, P7.17, P7.18, P12.15, P12.16, P12.17, P12.18, P13.15, P13.16, P13.17, P13.18; also elsewhere on the board
+24V: P7.21, P7.22, P7.23, P7.24, P12.21, P12.22, P12.23, P12.24, P13.21, P13.22, P13.23, P13.24, R28.1, R29.1, R30.1; also elsewhere on the board
-5V: P7.7, P7.8, P7.9, P7.10, P12.7, P12.8, P12.9, P12.10, P13.7, P13.8, P13.9, P13.10; also elsewhere on the board
/CS_ADC0: P1.19, P1.20; also elsewhere on the board
/CS_ADC1: P5.19, P5.20; also elsewhere on the board
/CS_ADC2: P6.19, P6.20; also elsewhere on the board
/CS_VGND0: P7.3, P7.4; also elsewhere on the board
/CS_VGND1: P12.3, P12.4; also elsewhere on the board
/CS_VGND2: P13.3, P13.4; also elsewhere on the board
/DRDY0: P1.11, P1.12; also elsewhere on the board
/DRDY1: P5.11, P5.12; also elsewhere on the board
/DRDY2: P6.11, P6.12; also elsewhere on the board
EN_VGND0: P7.1, P7.2, P12.1, P12.2, P13.1, P13.2; also elsewhere on the board
GND: P1.1, P1.2, P1.3, P1.4, P5.1, P5.2, P5.3, P5.4, P6.1, P6.2, P6.3, P6.4, P7.11, P7.12, P7.13, P7.14, P12.11, P12.12, P12.13, P12.14, P13.11, P13.12, P13.13, P13.14, Q2.2 (S), Q3.2 (S), Q4.2 (S), U5.1 (/OE), U5.3 (GND), U6.1 (/OE), U6.3 (GND), U7.1 (/OE), U7.3 (GND); also elsewhere on the board
MISO: P1.15, P1.16, P5.15, P5.16, P6.15, P6.16; also elsewhere on the board
MOSI: P1.13, P1.14, P5.13, P5.14, P6.13, P6.14; also elsewhere on the board
unnamed: P1.21, P1.22, R41.1, U5.4 (Y)
unnamed: P5.21, P5.22, R42.1, U6.4 (Y)
unnamed: P6.21, P6.22, R43.1, U7.4 (Y)
unnamed: P7.19, P7.20, Q2.3 (D), R28.2
unnamed: P12.19, P12.20, Q3.3 (D), R29.2
unnamed: P13.19, P13.20, Q4.3 (D), R30.2
ONEWIRE: P1.23, P1.24, P5.23, P5.24, P6.23, P6.24; also elsewhere on the board
PWM0: Q2.1 (G), R31.2; also elsewhere on the board
PWM1: Q3.1 (G), R32.2; also elsewhere on the board
PWM2: Q4.1 (G), R33.2; also elsewhere on the board
SCLK: P1.17, P1.18, P5.17, P5.18, P6.17, P6.18; also elsewhere on the board
TACH0: P7.5, P7.6; also elsewhere on the board
TACH1: P12.5, P12.6; also elsewhere on the board
TACH2: P13.5, P13.6; also elsewhere on the board
f_ADC: R41.2, R42.2, R43.2, U5.2 (A), U6.2 (A), U7.2 (A); also elsewhere on the board

Notes on the sheet:
A few words on impedance: The 74AHC1G125GW can drive 3.3/0.025 = 132 Ohm A 0.3 mm trace has 127 Ohm impedance, so would match well 0.5 mm is a bit lower, around 110 Ohm Hence we don't need to do much to avoid reflection, which matches the problem-free behavior we've had so far
We don't care about /DONEn

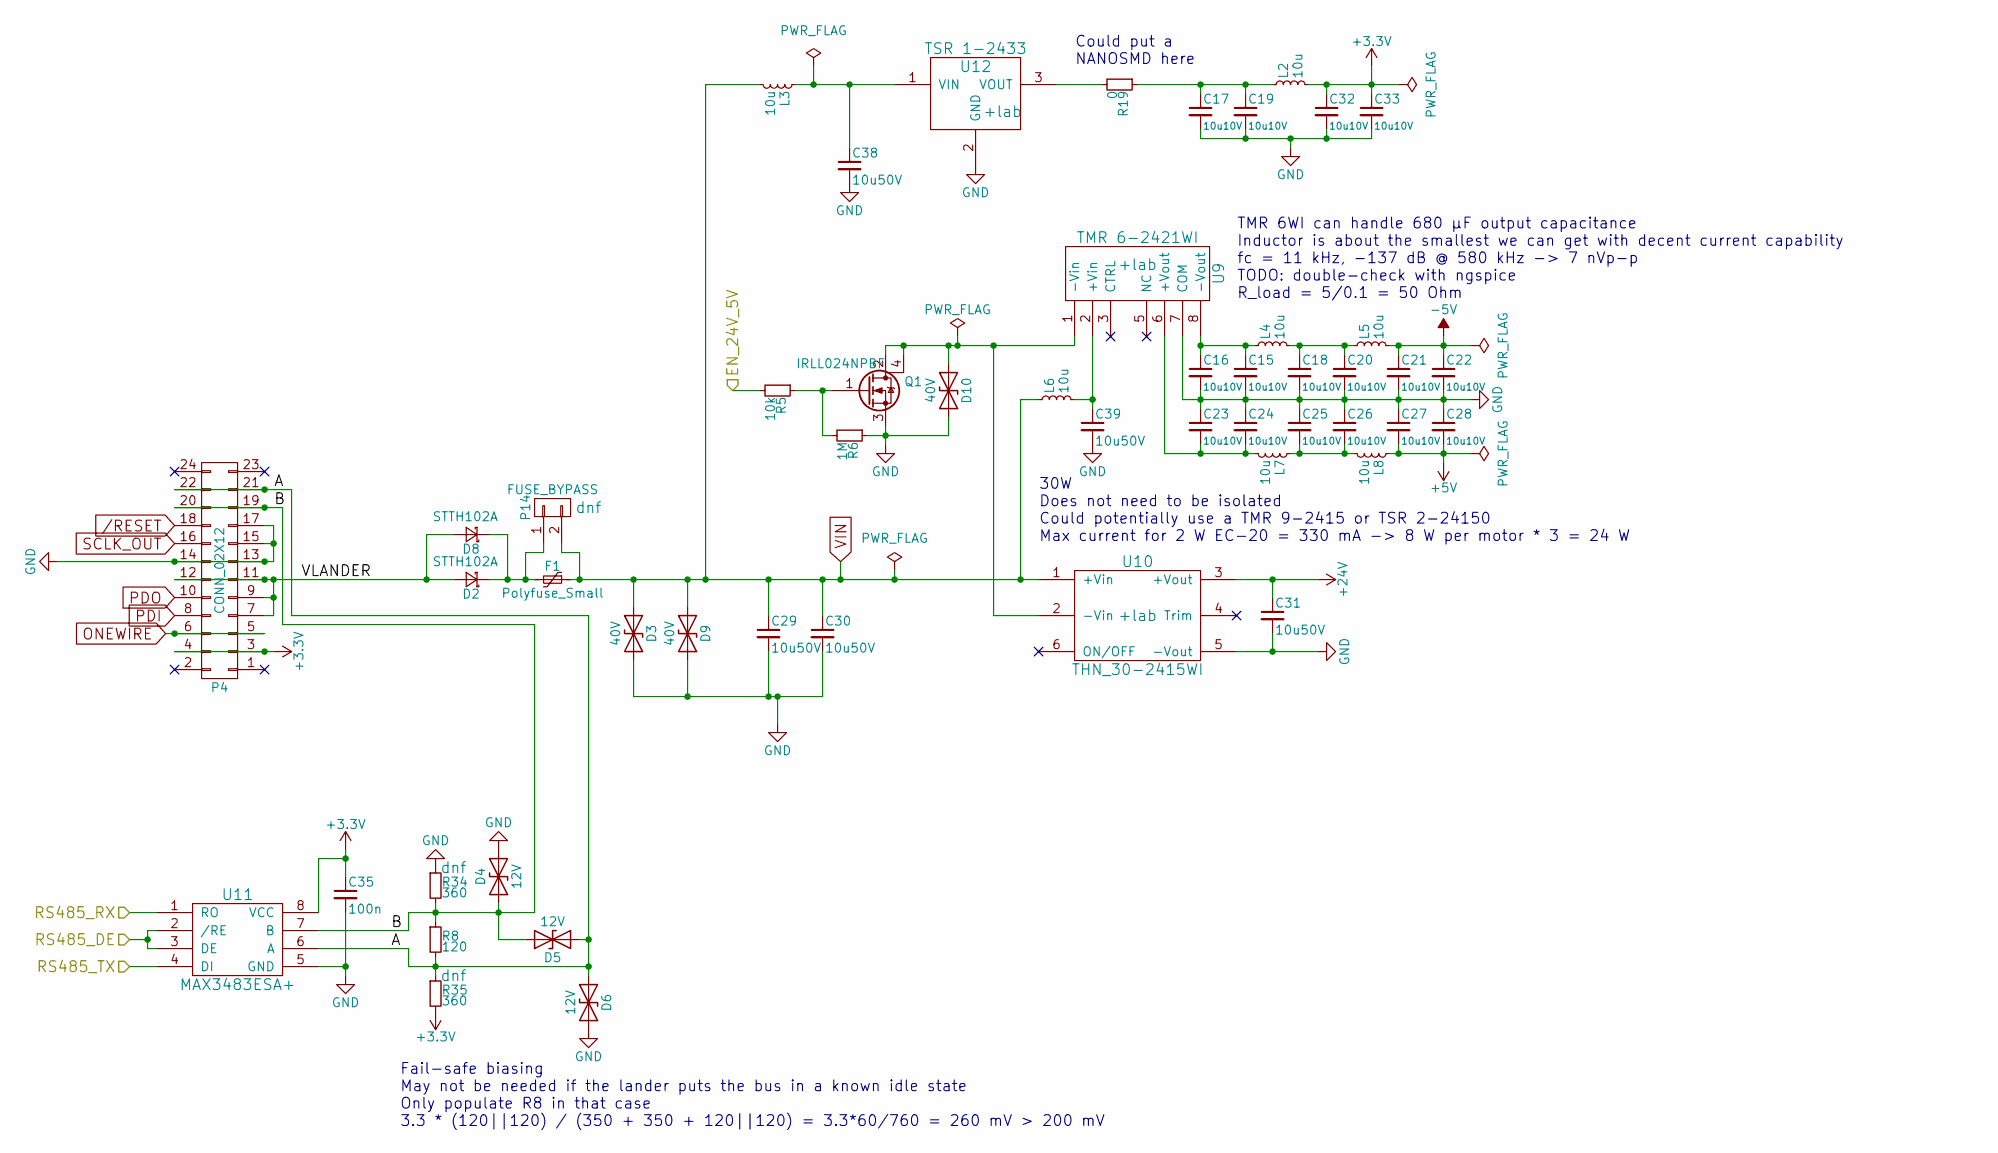
[picture p18: schematic power.sch, cpu4]

Parts:
C15: 10u10V; C_1210; Mfg. Part Number C1210X106K8NACAUTO; Mouser PN 80-C1210X106K8NAUTO
C16, C17, C18, C19, C20, C21, C22, C23, C24, C25, C26, C27, C28, C32, C33: 10u10V; C_1210
C29: 10u50V; C_1210; Mfg. Part Number CGA6P3X7S1H106K250AE; Farnell PN 2435524
C30, C31, C38, C39: 10u50V; C_1210
C35: 100n; C_0805
D2: STTH102A; SMA_Standard; Mfg. Part Number STTH102A; Farnell PN 9907874
D3: 40V; SMA_Standard; Mfg. Part Number 824501401; Farnell PN 2536561
D4: 12V; SMA_Standard; Mfg. Part Number 824501121; Farnell PN 2536587
D5, D6: 12V; SMA_Standard
D8: STTH102A; SMA_Standard
D9, D10: 40V; SMA_Standard
F1: Polyfuse_Small; Fuse_SMD2920; Mfg. Part Number 0ZCF0100AF2A; Mouser PN 530-0ZCF0100AF2A
L2, L3, L4, L5, L6, L7, L8: 10u; L_1008
P4: CONN_02X12; LPPB122NFSP-RC; Mfg. Part Number LPPB122NFSP-RC; Digikey PN S9007E-12-ND
P14: FUSE_BYPASS; solder_bridge_1mm
Q1: IRLL024NPBF; SOT-223; Mfg. Part Number IRLL024NPBF; Farnell PN 8651205
R5: 10k; R_0805
R6: 1M; R_0805
R8: 120; R_0805
R19: 0; R_1206
R34, R35: 360; R_0805
U9: TMR 6-2421WI; TMR_6-2421WI; Mfg. Part Number TMR 6-2421WI; Farnell PN 2363824
U10: THN_30-2415WI; THN_30-2415; Mfg. Part Number THN 30-2415WI; Farnell PN 2322198
U11: MAX3483ESA+; SOIC-8_3.9x4.9mm_Pitch1.27mm; Mfg. Part Number MAX3483ESA+; Farnell PN 2519249
U12: TSR 1-2433; TSR_1; Mfg. Part Number TSR 1-2433; Farnell PN 1696319

Connections:
+3V3: C32.1, C33.1, C35.1, L2.2, P4.3, P4.4, R35.2, U11.8 (VCC); also elsewhere on the board
+5V: C27.2, C28.2, L8.1; also elsewhere on the board
+24V: C31.1, U10.3 (+Vout); also elsewhere on the board
-5V: C21.1, C22.1, L5.2; also elsewhere on the board
/RESET: P4.18; also elsewhere on the board
/power/A: D5.1 (A1), D6.1 (A1), P4.21, P4.22, R8.2, R35.1, U11.6 (A)
/power/B: D4.1 (A1), D5.2 (A2), P4.19, P4.20, R8.1, R34.2, U11.7 (B)
/power/EN_24V_5V: R5.2; also elsewhere on the board
/power/RS485_DE: U11.2 (/RE), U11.3 (DE); also elsewhere on the board
/power/RS485_RX: U11.1 (RO); also elsewhere on the board
/power/RS485_TX: U11.4 (DI); also elsewhere on the board
/power/VLANDER: D2.2 (A), D8.2 (A), P4.7, P4.9, P4.11, P4.12
GND: C15.2, C16.2, C17.2, C18.2, C19.2, C20.2, C21.2, C22.2, C23.1, C24.1, C25.1, C26.1, C27.1, C28.1, C29.2, C30.2, C31.2, C32.2, C33.2, C35.2, C38.2, C39.2, D3.2 (A2), D4.2 (A2), D6.2 (A2), D9.2 (A2), D10.2 (A2), P4.13, P4.14, P4.15, P4.17, Q1.3 (S), R6.1, R34.1, U9.7 (COM), U10.5 (-Vout), U11.5 (GND), U12.2 (GND); also elsewhere on the board
unnamed: C15.1, C16.1, L4.1, U9.8 (-Vout)
unnamed: C17.1, C19.1, L2.1, R19.1
unnamed: C18.1, C20.1, L4.2, L5.1
unnamed: C23.2, C24.2, L7.2, U9.6 (+Vout)
unnamed: C25.2, C26.2, L7.1, L8.2
unnamed: C38.1, L3.1, U12.1 (VIN)
unnamed: C39.1, L6.2, U9.2 (+Vin)
unnamed: D2.1 (K), D8.1 (K), F1.2, P14.1
unnamed: D10.1 (A1), Q1.2 (D), Q1.4 (D), U9.1 (-Vin), U10.2 (-Vin)
unnamed: Q1.1 (G), R5.1, R6.2
unnamed: R19.2, U12.3 (VOUT)
ONEWIRE: P4.5, P4.6; also elsewhere on the board
PDI: P4.8; also elsewhere on the board
PDO: P4.10; also elsewhere on the board
SCLK_OUT: P4.16; also elsewhere on the board
VIN: C29.1, C30.1, D3.1 (A1), D9.1 (A1), F1.1, L3.2, L6.1, P14.2, U10.1 (+Vin); also elsewhere on the board

Notes on the sheet:
30W Does not need to be isolated Could potentially use a TMR 9-2415 or TSR 2-24150 Max current for 2 W EC-20 = 330 mA -> 8 W per motor * 3 = 24 W
TMR 6WI can handle 680 µF output capacitance Inductor is about the smallest we can get with decent current capability fc = 11 kHz, -137 dB @ 580 kHz -> 7 nVp-p TODO: double-check with ngspice R_load = 5/0.1 = 50 Ohm
Fail-safe biasing May not be needed if the lander puts the bus in a known idle state Only populate R8 in that case 3.3 * (120||120) / (350 + 350 + 120||120) = 3.3*60/760 = 260 mV > 200 mV
Could put a NANOSMD here

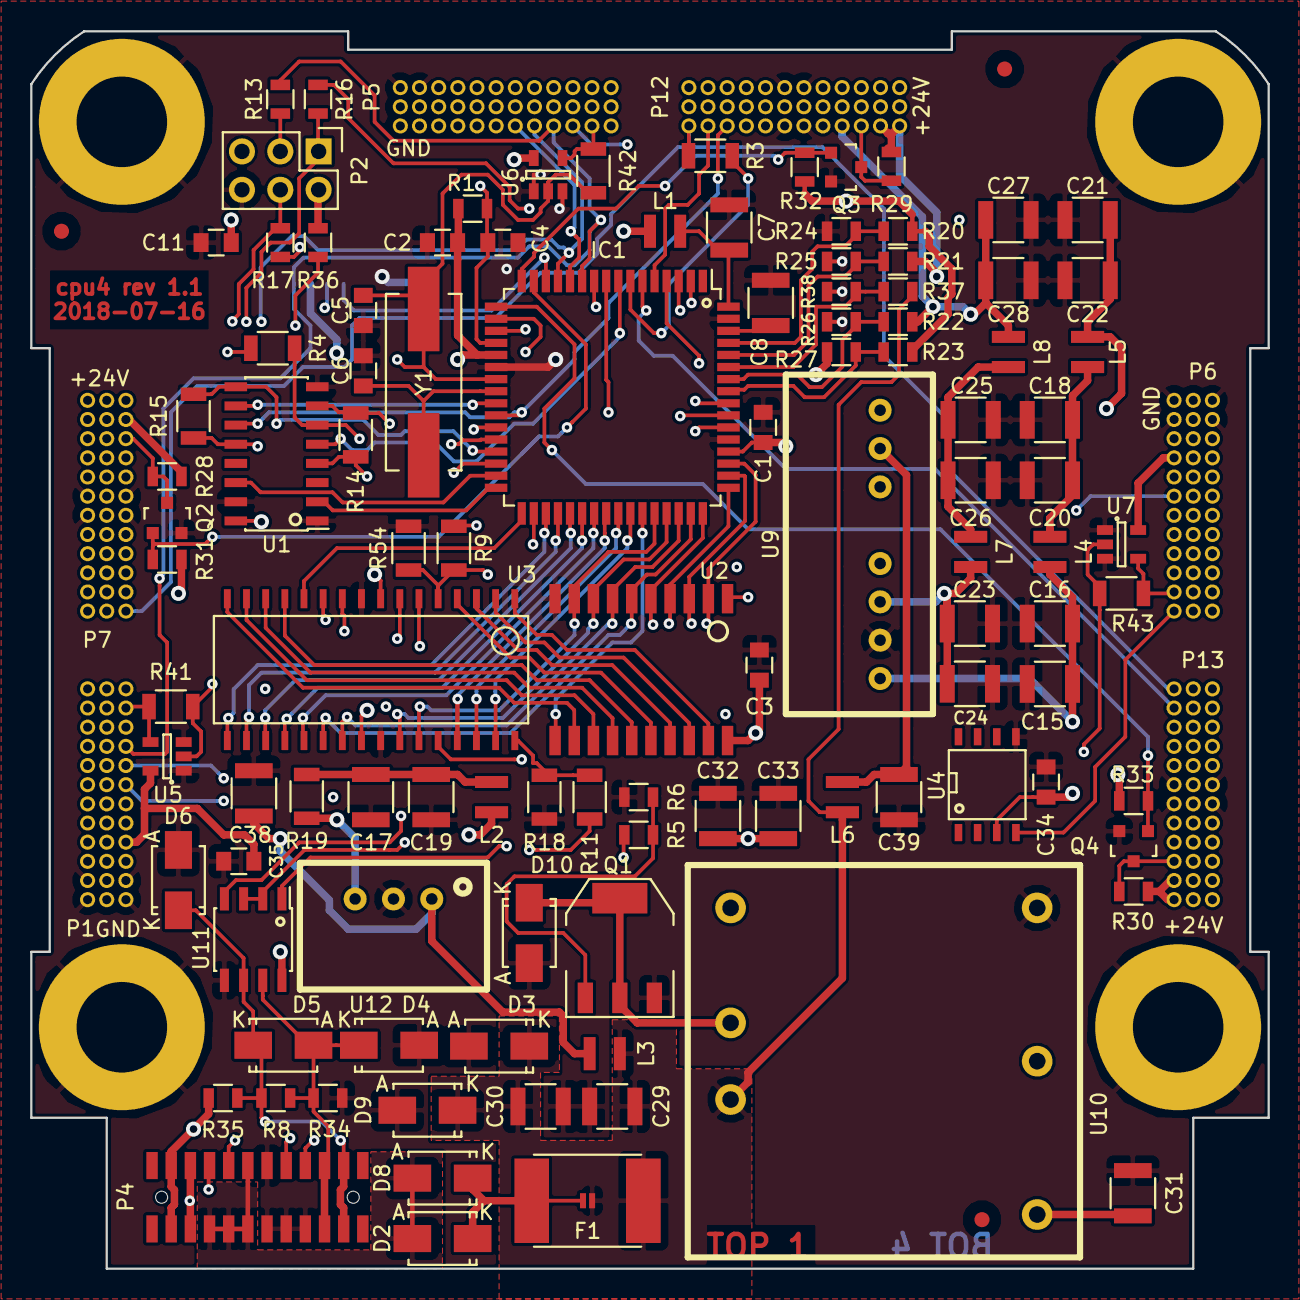
[picture p19: board cpu4.kicad_pcb from above]

Board: 4 copper layers, 82.0 x 82.0 mm, 121 parts (1 on the bottom side), 101 nets.

Other parts of the board:
REF1, REF2, REF3: Fiducial_1mm_Dia_2.54mm_Outer_CopperTop; Fiducial_1mm_Dia_2.54mm_Outer_CopperTop-paste
