SpaceScienceSweden/ulv_electronics/fieldmill10/fieldmill10.kicad_pcb

## KiCad design fieldmill10/fieldmill10.kicad_pcb (2018-12-18)

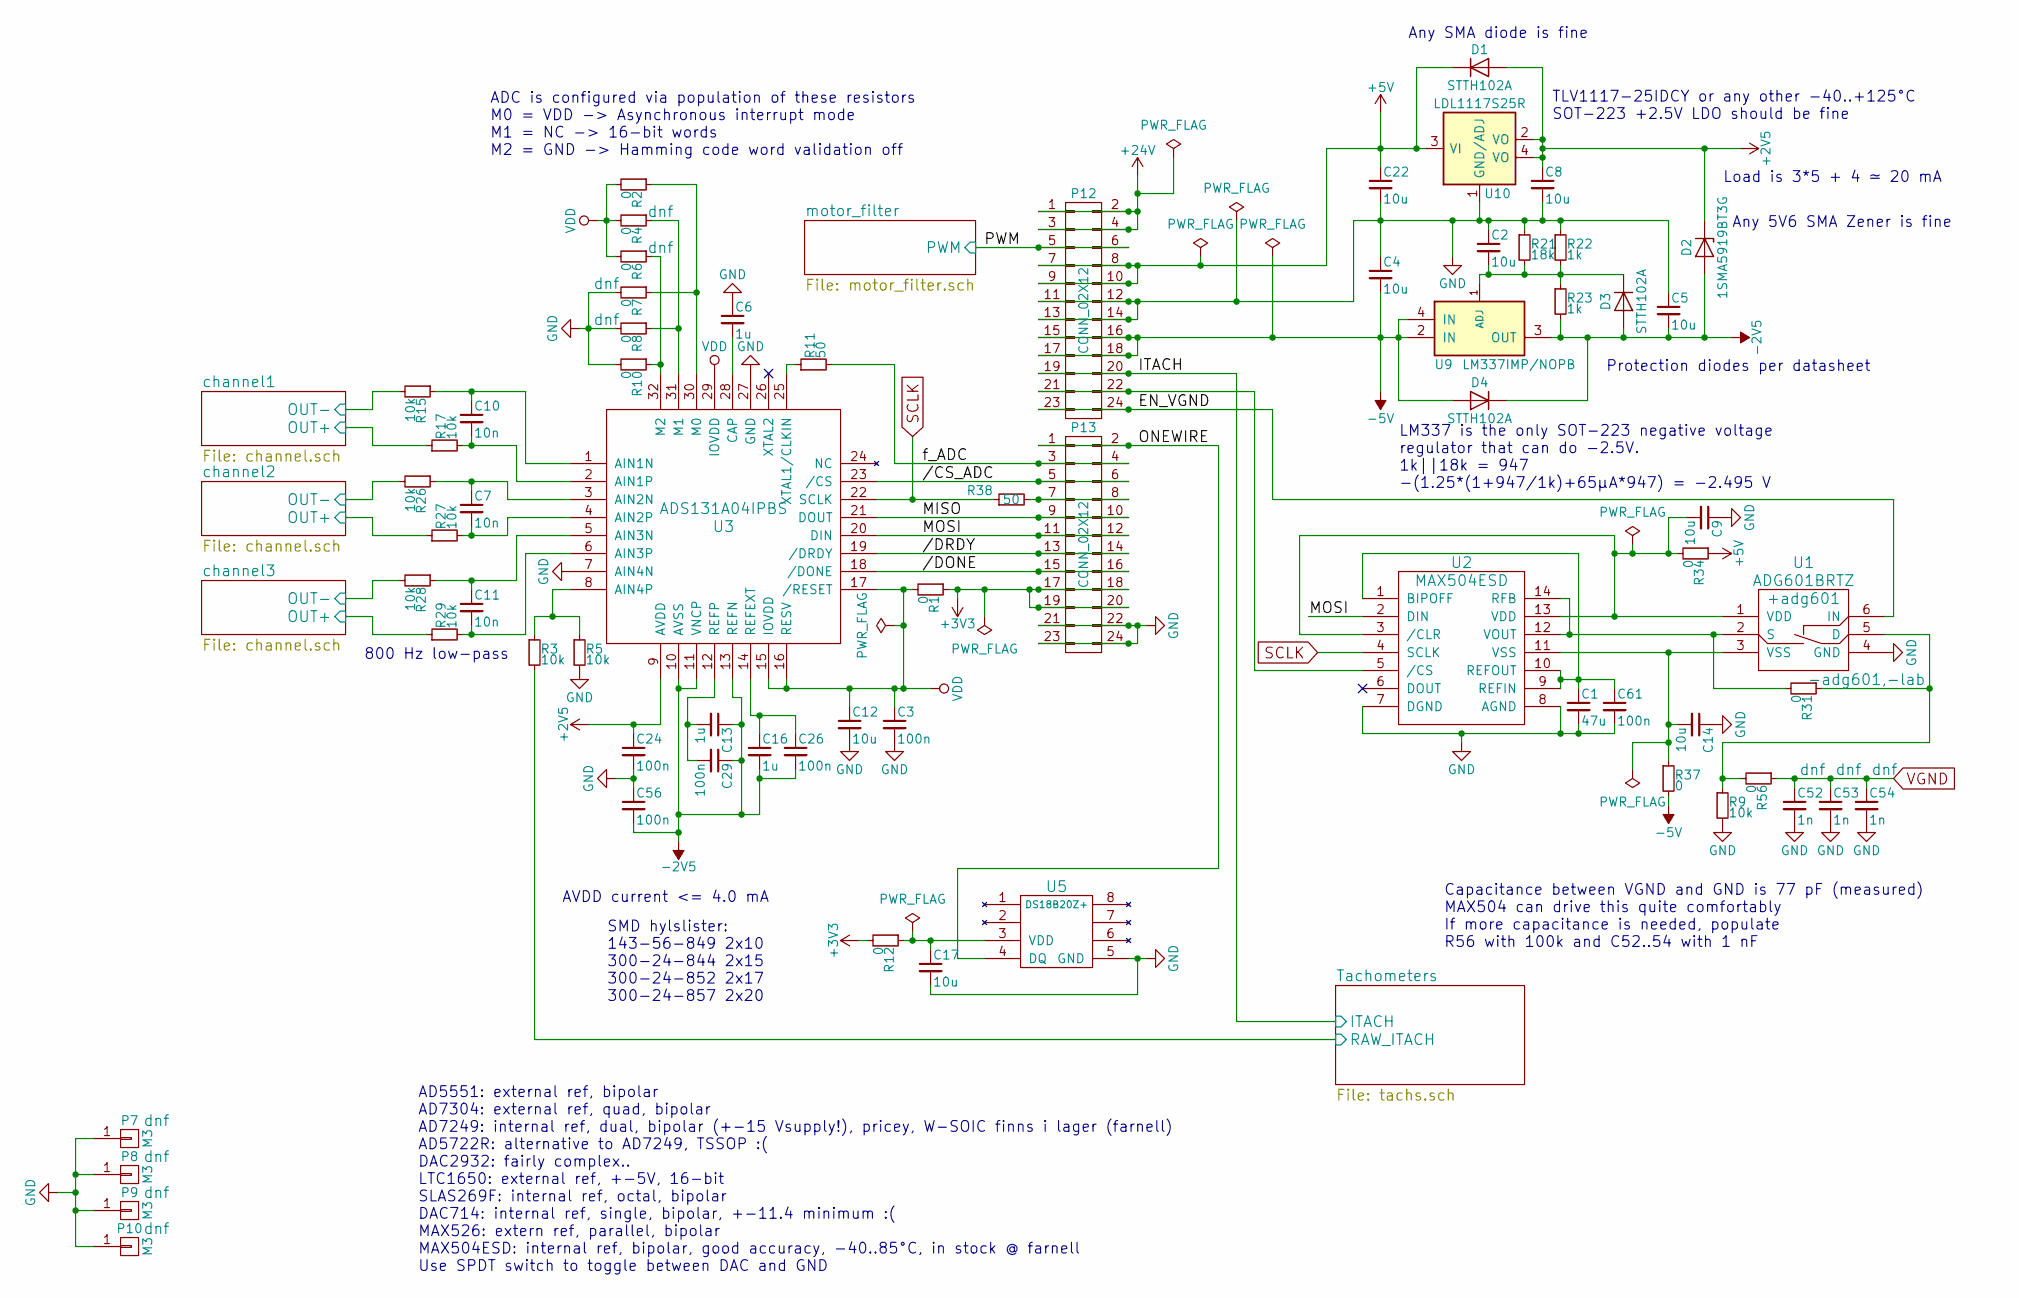
[picture p20: schematic fieldmill10.sch]

Parts:
C1: 47u; C_1210; Mfg. Part Number GCJ32ER70J476KE01L; Mouser PN 81-GCJ32ER70J476KE1L
C2, C4, C5, C9, C12, C14, C17, C22: 10u; C_0805; Mfg. Part Number C0805X106M8RACAUTO; Farnell PN 2776919
C3, C24, C26, C29, C56, C61: 100n; C_1210; Mfg. Part Number ECH-U1C104GX5; Farnell PN 9695001
C6, C13, C16: 1u; C_0805; Mfg. Part Number C0805X105K3RACAUTO; Farnell PN 2478267
C7, C10, C11: 10n; C_0805; Mfg. Part Number ECH-U1C103GX5; Farnell PN 9694897
C8: 10u; C_0805
C52, C53, C54: 1n; C_0805
D1, D3, D4: STTH102A; SMA_Standard; Mfg. Part Number STTH102A; Farnell PN 9907874
D2: 1SMA5919BT3G; SMA_Standard; Mfg. Part Number 1SMA5919BT3G; Farnell PN 1431141
P7, P8, P9, P10: M3; M3_FM_PTH
P12: CONN_02X12; LPPB122NFSP-RC-holes; Mfg. Part Number LPPB122NFSP-RC; Digikey PN S9007E-12-ND
P13: CONN_02X12; LPPB122NFSP-RC-holes
R1, R12, R34, R37: 0; R_1206
R2, R4, R6, R7, R8, R10, R31, R56: 0; R_0805
R3, R5, R9, R15, R17, R26, R27, R28, R29: 10k; R_0805
R11, R38: 50; R_0805
R21: 18k; R_0805
R22, R23: 1k; R_0805
U1: ADG601BRTZ; SOT-23-6; Mouser PN 584-ADG601BRTZ-R7; Farnell PN 1661035
U2: MAX504ESD; SOIC-14_3.9x8.7mm_Pitch1.27mm; Mfg. Part Number MAX504ESD+; Farnell PN 2514723
U3: ADS131A04IPBS; LQFP-32_5x5mm_Pitch0.5mm; Mfg. Part Number ADS131A04IPBS; Farnell PN 2580620
U5: DS18B20Z+; SOIC-8_3.9x4.9mm_Pitch1.27mm; Mfg. Part Number DS18B20Z+; Farnell PN 2518724
U9: LM337IMP/NOPB; SOT-223; Mfg. Part Number LM337IMP/NOPB; Farnell PN 2781817
U10: LDL1117S25R; SOT-223; Mfg. Part Number LDL1117S25R; Farnell PN 2778100

Connections:
+2V5: C8.1, C24.1, D1.2 (A), D2.1 (K), U3.9 (AVDD), U10.2 (VO), U10.4 (VO); also elsewhere on the board
+3V3: P13.17, P13.18, P13.19, P13.20, R1.1, R12.2; also elsewhere on the board
+5V: C22.1, D1.1 (K), P12.7, P12.8, P12.9, P12.10, R34.1, U10.3 (VI)
+24V: P12.1, P12.2, P12.3, P12.4; also elsewhere on the board
-2V5: C5.2, C13.1, C16.2, C26.2, C29.1, C56.2, D2.2 (A), D3.2 (A), D4.1 (K), R23.2, U3.10 (AVSS), U3.11 (VNCP), U3.13 (REFN), U9.3 (OUT); also elsewhere on the board
-5V: C4.2, D4.2 (A), P12.15, P12.16, P12.17, P12.18, R37.2, U9.2 (IN), U9.4 (IN); also elsewhere on the board
//CS_ADC: P13.5, P13.6, U3.23 (/CS)
//DONE: P13.15, P13.16, U3.18 (/DONE)
//DRDY: P13.13, P13.14, U3.19 (/DRDY)
/EN_VGND: P12.23, P12.24, U1.6 (IN)
/ITACH: P12.19, P12.20; also elsewhere on the board
/MISO: P13.9, P13.10, U3.21 (DOUT)
/MOSI: P13.11, P13.12, U2.2 (DIN), U3.20 (DIN)
/ONEWIRE: P13.1, P13.2, U5.4 (DQ)
/PWM: P12.5, P12.6; also elsewhere on the board
/Tachometers/RAW_ITACH: R3.2; also elsewhere on the board
/channel1/OUT+: R17.1; also elsewhere on the board
/channel1/OUT-: R15.2; also elsewhere on the board
/channel2/OUT+: R27.1; also elsewhere on the board
/channel2/OUT-: R26.2; also elsewhere on the board
/channel3/OUT+: R29.1; also elsewhere on the board
/channel3/OUT-: R28.2; also elsewhere on the board
/f_ADC: P13.3, P13.4, R11.2
GND: C1.2, C2.1, C3.2, C4.1, C5.1, C6.1, C8.2, C9.1, C12.2, C14.1, C17.2, C22.2, C24.2, C52.2, C53.2, C54.2, C56.1, C61.2, P7.1, P8.1, P9.1, P10.1, P12.11, P12.12, P12.13, P12.14, P13.21, P13.22, P13.23, P13.24, R5.2, R7.2, R8.2, R9.2, R10.2, R21.1, R22.1, U1.4 (GND), U2.7 (DGND), U2.8 (AGND), U3.7 (AIN4N), U3.27 (GND), U5.5 (GND), U10.1 (GND/ADJ); also elsewhere on the board
unnamed: C1.1, C61.1, U2.1 (BIPOFF), U2.9 (REFIN), U2.10 (REFOUT)
unnamed: C2.2, D3.1 (K), R21.2, R22.2, R23.1, U9.1 (ADJ)
unnamed: C6.2, U3.28 (CAP)
unnamed: C7.1, R26.1, U3.3 (AIN2N)
unnamed: C7.2, R27.2, U3.4 (AIN2P)
unnamed: C9.2, R34.2, U1.1 (VDD), U2.3 (/CLR), U2.13 (VDD)
unnamed: C10.1, R15.1, U3.1 (AIN1N)
unnamed: C10.2, R17.2, U3.2 (AIN1P)
unnamed: C11.1, R28.1, U3.5 (AIN3N)
unnamed: C11.2, R29.2, U3.6 (AIN3P)
unnamed: C13.2, C29.2, U3.12 (REFP)
unnamed: C14.2, R37.1, U1.3 (VSS), U2.11 (VSS)
unnamed: C16.1, C26.1, U3.14 (REFEXT)
unnamed: C17.1, R12.1, U5.3 (VDD)
unnamed: P12.21, P12.22, U2.5 (/CS)
unnamed: P13.7, P13.8, R38.2
unnamed: R2.1, R7.1, U3.30 (M0)
unnamed: R3.1, R5.1, U3.8 (AIN4P)
unnamed: R4.1, R8.1, U3.31 (M1)
unnamed: R6.1, R10.1, U3.32 (M2)
unnamed: R11.1, U3.25 (XTAL1/CLKIN)
unnamed: R9.1, R31.1, R56.2, U1.5 (D)
unnamed: R31.2, U1.2 (S), U2.12 (VOUT), U2.14 (RFB)
SCLK: R38.1, U2.4 (SCLK), U3.22 (SCLK)
VDD: C3.1, C12.1, R1.2, R2.2, R4.2, R6.2, U3.15 (IOVDD), U3.16 (RESV), U3.17 (/RESET), U3.29 (IOVDD)
VGND: C52.1, C53.1, C54.1, R56.1; also elsewhere on the board

Notes on the sheet:
ADC is configured via population of these resistors M0 = VDD -> Asynchronous interrupt mode M1 = NC -> 16-bit words M2 = GND -> Hamming code word validation off
800 Hz low-pass
SMD hylslister: 143-56-849 2x10 300-24-844 2x15 300-24-852 2x17 300-24-857 2x20
AVDD current <= 4.0 mA
AD5551: external ref, bipolar AD7304: external ref, quad, bipolar AD7249: internal ref, dual, bipolar (+-15 Vsupply!), pricey, W-SOIC finns i lager (farnell) AD5722R: alternative to AD7249, TSSOP :( DAC2932: fairly complex.. LTC1650: external ref, +-5V, 16-bit SLAS269F: internal ref, octal, bipolar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
Capacitance between VGND and GND is 77 pF (measured) MAX504 can drive this quite comfortably If more capacitance is needed, populate R56 with 100k and C52..54 with 1 nF
TLV1117-25IDCY or any other -40..+125°C SOT-223 +2.5V LDO should be fine
Load is 3*5 + 4 ≃ 20 mA
LM337 is the only SOT-223 negative voltage regulator that can do -2.5V. 1k||18k = 947 -(1.25*(1+947/1k)+65µA*947) = -2.495 V
Protection diodes per datasheet
Any SMA diode is fine
Any 5V6 SMA Zener is fine

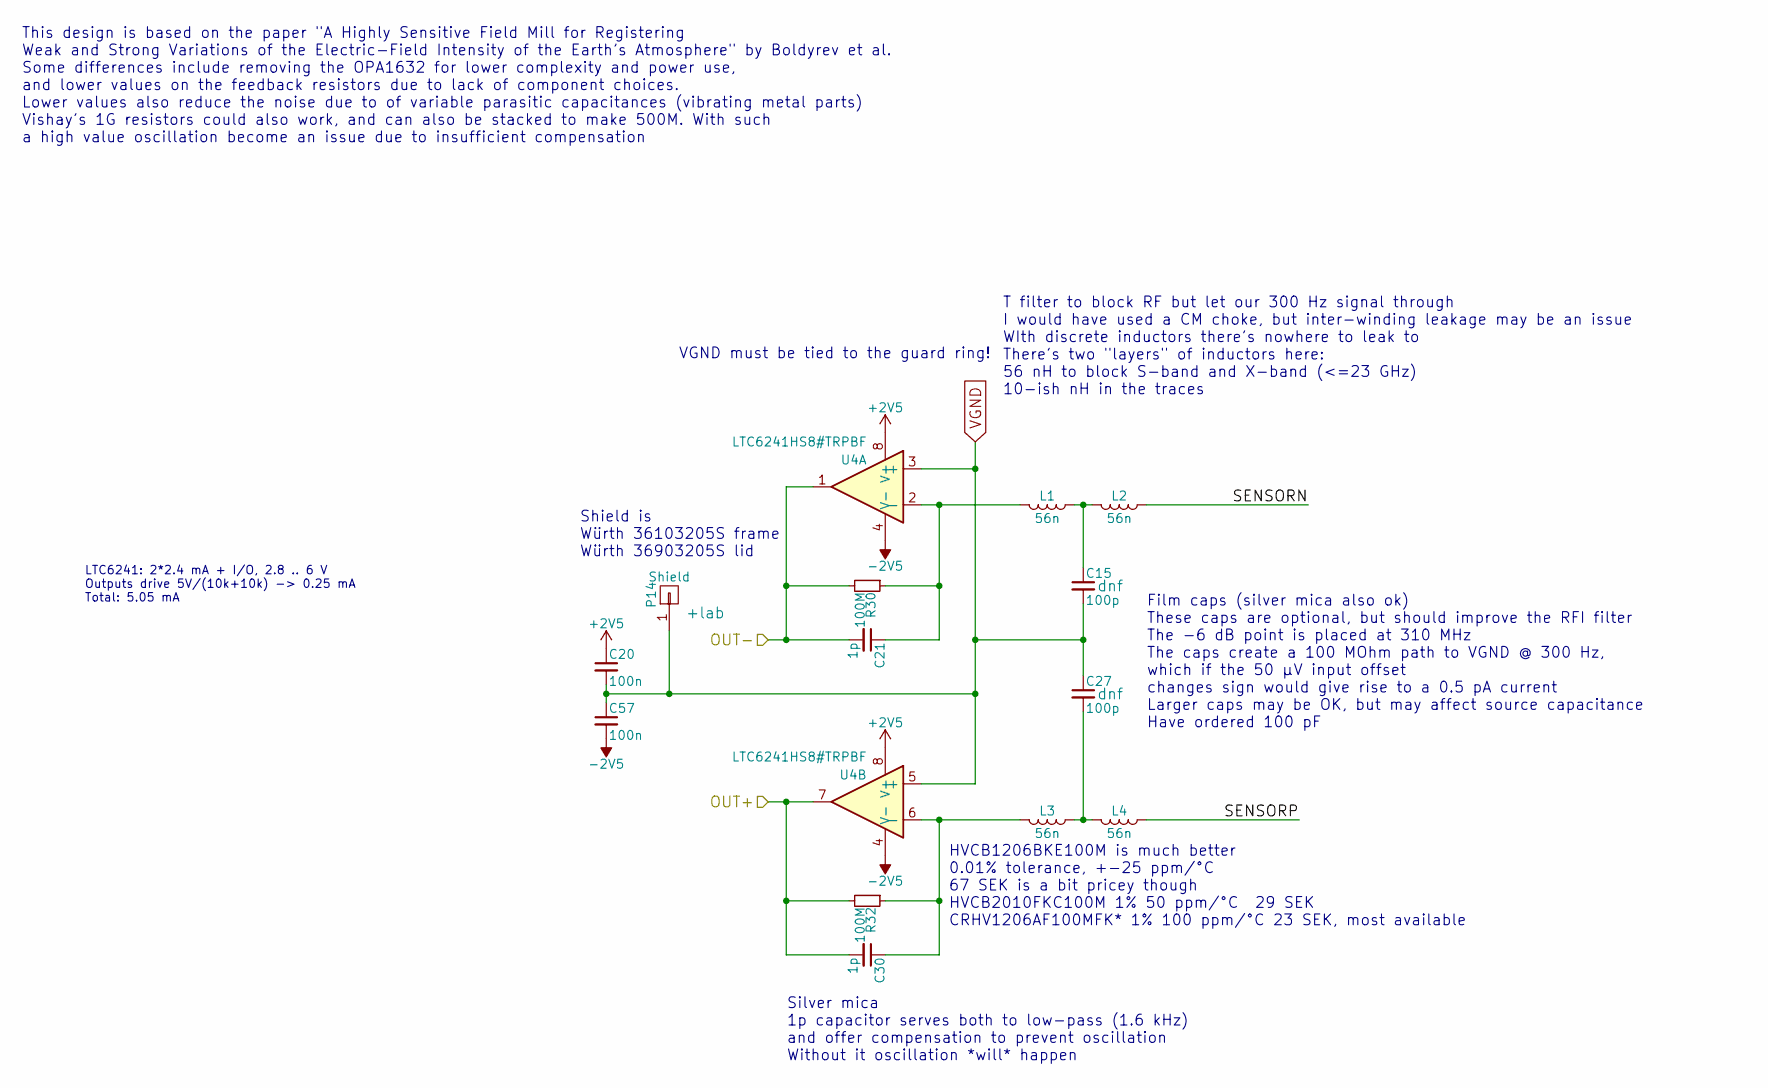
[picture p21: schematic channel.sch]

Parts:
C15, C27: 100p; C_0805; Mouser PN 667-ECH-U1H101GX5; Farnell PN 9695125
C20, C57: 100n; C_1210; Mfg. Part Number ECH-U1C104GX5; Farnell PN 9695001
C21, C30: 1p; C_0805; Mfg. Part Number MC08CA010D-F; Farnell PN 1610819
L1, L2, L3, L4: 56n; C_0603; Mfg. Part Number L-14C56NJV4T; Mouser PN 609-L-14C56NJV4T
P14: Shield; 36903205S
R30, R32: 100M; R_1206; Mfg. Part Number CRHV1206AF100MFK; Farnell PN 1109056
U4: LTC6241HS8#TRPBF; SOIC-8_3.9x4.9mm_Pitch1.27mm; Mfg. Part Number LTC6241HS8#TRPBF; Mouser PN 584-LTC6241HS8#TRPBF

Connections:
+2V5: C20.1, U4.8 (V+); also elsewhere on the board
-2V5: C57.2, U4.4 (V-); also elsewhere on the board
/channel1/OUT+: C30.2, R32.2, U4.7; also elsewhere on the board
/channel1/OUT-: C21.2, R30.2, U4.1; also elsewhere on the board
/channel1/SENSORN: L2.1
/channel1/SENSORP: L4.1
unnamed: C15.1, L1.1, L2.2
unnamed: C21.1, L1.2, R30.1, U4.2 (-)
unnamed: C27.2, L3.1, L4.2
unnamed: C30.1, L3.2, R32.1, U4.6 (-)
VGND: C15.2, C20.2, C27.1, C57.1, P14.1, U4.3 (+), U4.5 (+); also elsewhere on the board

Parts of its further copies:
C25, C28, C58, C59: 100n; C_1210; Mfg. Part Number ECH-U1C104GX5; Farnell PN 9695001
C32, C36, C38, C42: 1p; C_0805; Mfg. Part Number MC08CA010D-F; Farnell PN 1610819
C34, C41, C44, C45: 100p; C_0805; Mouser PN 667-ECH-U1H101GX5; Farnell PN 9695125
L5, L6, L7, L8, L9, L10, L11, L12: 56n; C_0603; Mfg. Part Number L-14C56NJV4T; Mouser PN 609-L-14C56NJV4T
P15, P16: Shield; 36903205S
R33, R35, R36, R42: 100M; R_1206; Mfg. Part Number CRHV1206AF100MFK; Farnell PN 1109056
U6, U8: LTC6241HS8#TRPBF; SOIC-8_3.9x4.9mm_Pitch1.27mm; Mfg. Part Number LTC6241HS8#TRPBF; Mouser PN 584-LTC6241HS8#TRPBF

Connections of its further copies:
+2V5: C25.1, C28.1, U6.8 (V+), U8.8 (V+); also elsewhere on the board
-2V5: C58.2, C59.2, U6.4 (V-), U8.4 (V-); also elsewhere on the board
/channel2/OUT+: C36.2, R33.2, U6.7; also elsewhere on the board
/channel2/OUT-: C32.2, R36.2, U6.1; also elsewhere on the board
/channel2/SENSORN: L6.1
/channel2/SENSORP: L8.1
/channel3/OUT+: C42.2, R35.2, U8.7; also elsewhere on the board
/channel3/OUT-: C38.2, R42.2, U8.1; also elsewhere on the board
/channel3/SENSORN: L10.1
/channel3/SENSORP: L12.1
unnamed: C32.1, L5.2, R36.1, U6.2 (-)
unnamed: C34.1, L5.1, L6.2
unnamed: C36.1, L7.2, R33.1, U6.6 (-)
unnamed: C38.1, L9.2, R42.1, U8.2 (-)
unnamed: C41.2, L7.1, L8.2
unnamed: C42.1, L11.2, R35.1, U8.6 (-)
unnamed: C44.1, L9.1, L10.2
unnamed: C45.2, L11.1, L12.2
VGND: C25.2, C28.2, C34.2, C41.1, C44.2, C45.1, C58.1, C59.1, P15.1, P16.1, U6.3 (+), U6.5 (+), U8.3 (+), U8.5 (+); also elsewhere on the board

Notes on the sheet:
This design is based on the paper "A Highly Sensitive Field Mill for Registering Weak and Strong Variations of the Electric-Field Intensity of the Earth’s Atmosphere" by Boldyrev et al. Some differences include removing the OPA1632 for lower complexity and power use, and lower values on the feedbac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
Silver mica 1p capacitor serves both to low-pass (1.6 kHz) and offer compensation to prevent oscillation Without it oscillation *will* happen
T filter to block RF but let our 300 Hz signal through I would have used a CM choke, but inter-winding leakage may be an issue WIth discrete inductors there's nowhere to leak to There's two "layers" of inductors here: 56 nH to block S-band and X-band (<=23 GHz) 10-ish nH in the traces
LTC6241: 2*2.4 mA + I/O, 2.8 .. 6 V Outputs drive 5V/(10k+10k) -> 0.25 mA Total: 5.05 mA
VGND must be tied to the guard ring!
Film caps (silver mica also ok) These caps are optional, but should improve the RFI filter The -6 dB point is placed at 310 MHz The caps create a 100 MOhm path to VGND @ 300 Hz, which if the 50 µV input offset changes sign would give rise to a 0.5 pA current Larger caps may be OK, but may affect so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
HVCB1206BKE100M is much better 0.01% tolerance, +-25 ppm/°C 67 SEK is a bit pricey though HVCB2010FKC100M 1% 50 ppm/°C 29 SEK CRHV1206AF100MFK* 1% 100 ppm/°C 23 SEK, most available
Shield is Würth 36103205S frame Würth 36903205S lid

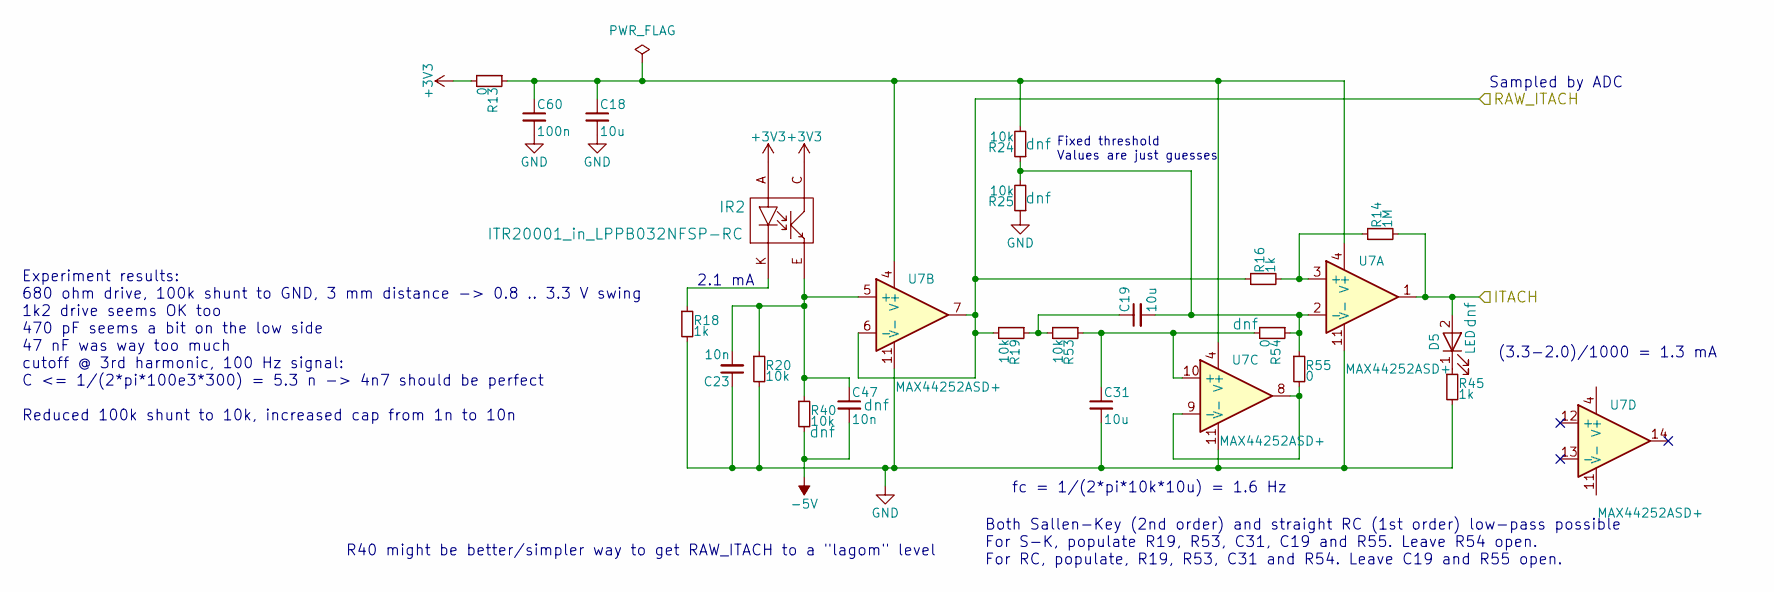
[picture p22: schematic tachs.sch]

Parts:
C18, C19, C31: 10u; C_0805; Mfg. Part Number C0805X106M8RACAUTO; Farnell PN 2776919
C23: 10n; C_0805; Mfg. Part Number ECH-U1C103GX5; Farnell PN 9694897
C47: 10n; C_0805
C60: 100n; C_1210; Mfg. Part Number ECH-U1C104GX5; Farnell PN 9695001
D5: LED; LED_0805
IR2: ITR20001_in_LPPB032NFSP-RC; LPPB032NFSP-RC-ITR20001; Mfg. Part Number LPPB032NFSP-RC; Digikey PN S9007E-03-ND
R13: 0; R_1206
R14: 1M; R_0805
R16, R18, R45: 1k; R_0805
R19, R20, R24, R25, R40, R53: 10k; R_0805
R54, R55: 0; R_0805
U7: MAX44252ASD+; SOIC-14_3.9x8.7mm_Pitch1.27mm; Mfg. Part Number MAX44252ASD+; Farnell PN 2510952

Connections:
+3V3: IR2.A, IR2.C, R13.2; also elsewhere on the board
-5V: C47.2, R40.2; also elsewhere on the board
/ITACH: D5.2 (A), R14.2, U7.1; also elsewhere on the board
/Tachometers/RAW_ITACH: R16.1, R19.2, U7.6 (-), U7.7; also elsewhere on the board
GND: C18.2, C23.1, C31.2, C60.2, R18.2, R20.2, R25.1, R45.2, U7.11 (V-); also elsewhere on the board
unnamed: C18.1, C60.1, R13.1, R24.2, U7.4 (V+)
unnamed: C19.1, R19.1, R53.2
unnamed: C19.2, R24.1, R25.2, R54.1, R55.1, U7.2 (-)
unnamed: C23.2, C47.1, IR2.E, R20.1, R40.1, U7.5 (+)
unnamed: C31.1, R53.1, R54.2, U7.10 (+)
unnamed: D5.1 (K), R45.1
unnamed: IR2.K, R18.1
unnamed: R14.1, R16.2, U7.3 (+)
unnamed: R55.2, U7.8, U7.9 (-)

Notes on the sheet:
fc = 1/(2*pi*10k*10u) = 1.6 Hz
R40 might be better/simpler way to get RAW_ITACH to a "lagom" level
(3.3-2.0)/1000 = 1.3 mA
Experiment results: 680 ohm drive, 100k shunt to GND, 3 mm distance -> 0.8 .. 3.3 V swing 1k2 drive seems OK too 470 pF seems a bit on the low side 47 nF was way too much cutoff @ 3rd harmonic, 100 Hz signal: C <= 1/(2*pi*100e3*300) = 5.3 n -> 4n7 should be perfect Reduced 100k shunt to 10k, increa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
Both Sallen-Key (2nd order) and straight RC (1st order) low-pass possible For S-K, populate R19, R53, C31, C19 and R55. Leave R54 open. For RC, populate, R19, R53, C31 and R54. Leave C19 and R55 open.
2.1 mA
Fixed threshold Values are just guesses
Sampled by ADC

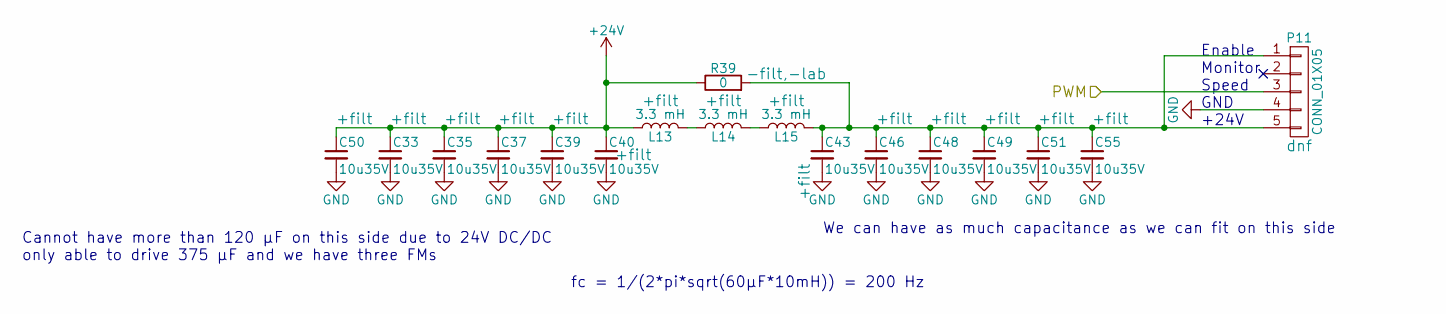
[picture p23: schematic motor_filter.sch]

Parts:
C33, C35, C37, C39, C40, C43, C46, C48, C49, C50, C51, C55: 10u35V; C_1206; Mfg. Part Number CGA5L1X7R1V106K160AE; Farnell PN 2547055
L13, L14, L15: 3.3 mH; Wurth_7687709332
P11: CONN_01X05; MOTOR_SMD
R39: 0; R_1206

Connections:
+24V: C33.1, C35.1, C37.1, C39.1, C40.1, C50.1, L13.1, R39.1; also elsewhere on the board
/PWM: P11.3; also elsewhere on the board
GND: C33.2, C35.2, C37.2, C39.2, C40.2, C43.2, C46.2, C48.2, C49.2, C50.2, C51.2, C55.2, P11.4; also elsewhere on the board
unnamed: C43.1, C46.1, C48.1, C49.1, C51.1, C55.1, L15.2, P11.1, P11.5, R39.2
unnamed: L13.2, L14.1
unnamed: L14.2, L15.1

Notes on the sheet:
Enable Monitor Speed GND +24V
fc = 1/(2*pi*sqrt(60µF*10mH)) = 200 Hz
Cannot have more than 120 µF on this side due to 24V DC/DC only able to drive 375 µF and we have three FMs
We can have as much capacitance as we can fit on this side

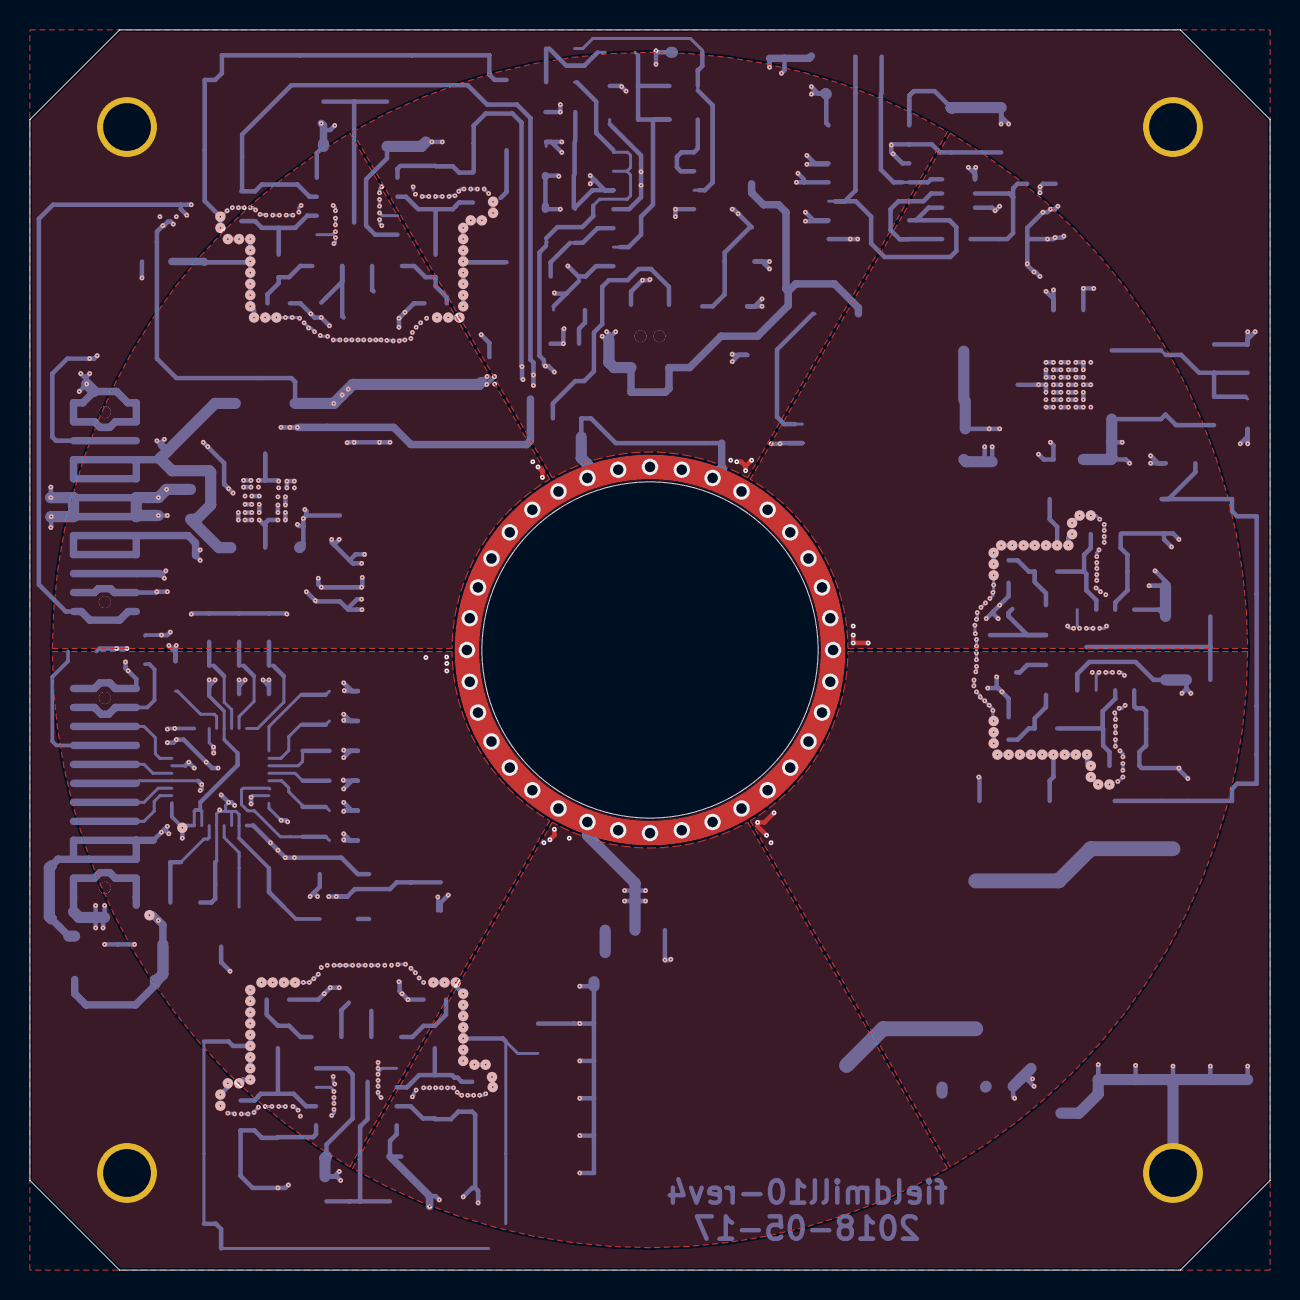
[picture p24: board fieldmill10.kicad_pcb from above]

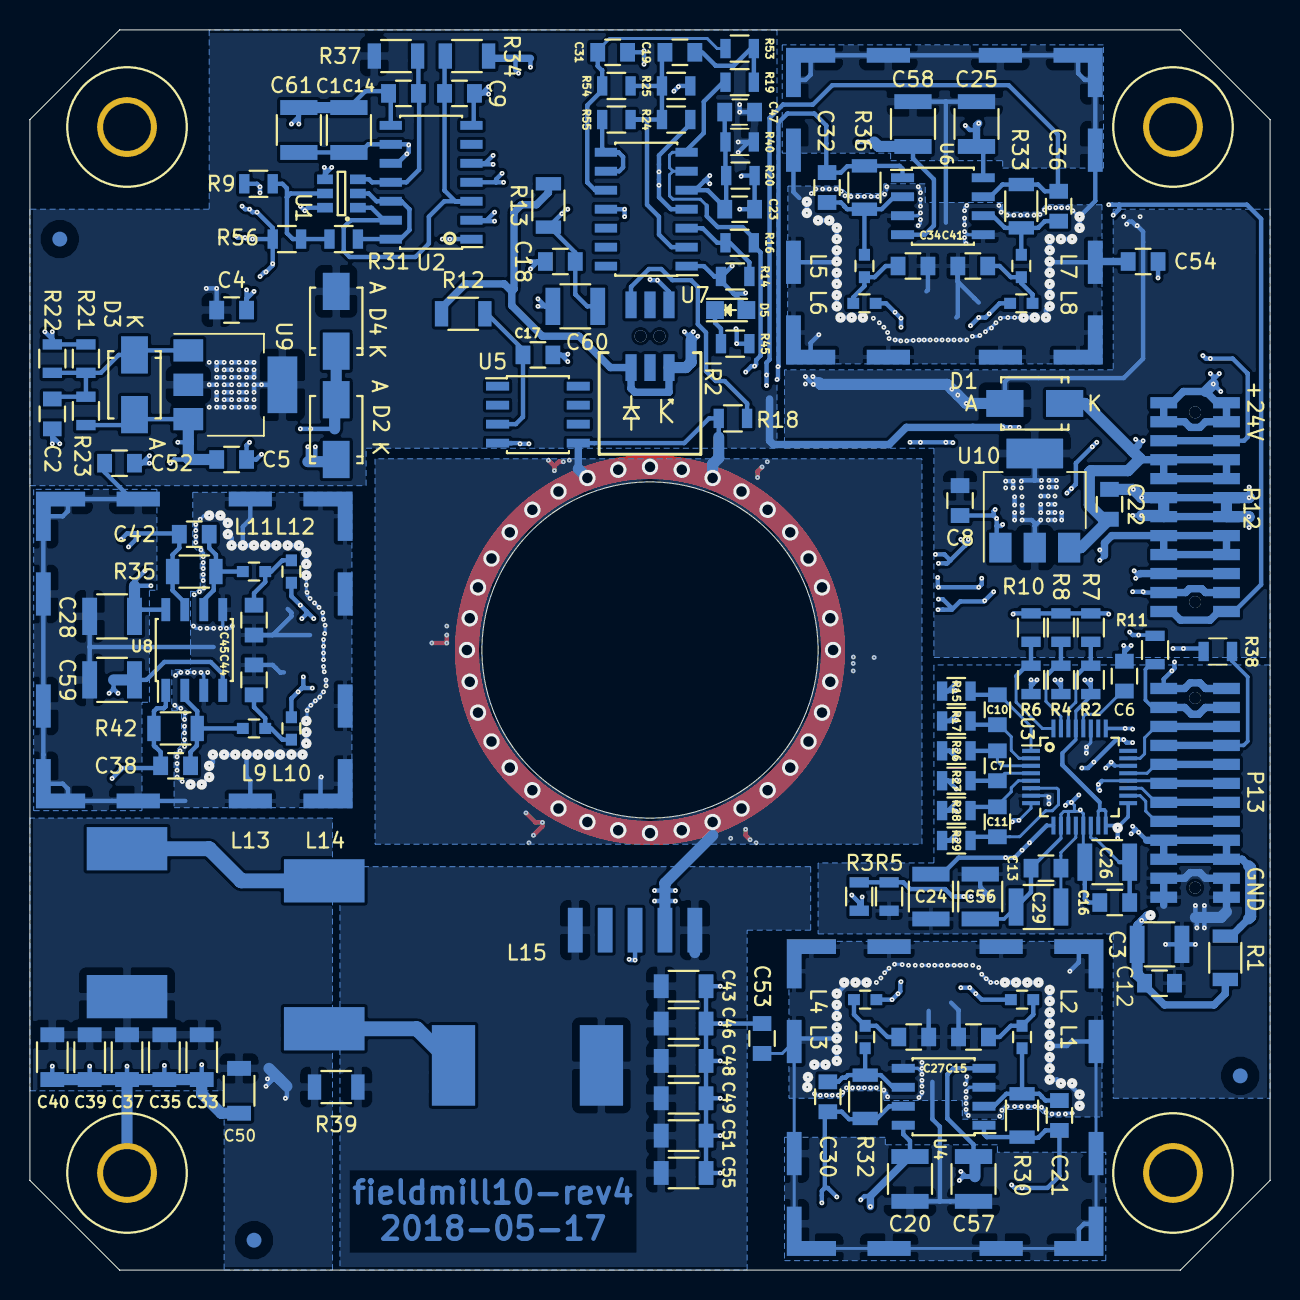
[picture p25: board fieldmill10.kicad_pcb from below]

Board: 6 copper layers, 83.0 x 83.0 mm, 151 parts (147 on the bottom side), 74 nets.

Other parts of the board:
REF1, REF2, REF3: Fiducial_1mm_Dia_2.54mm_Outer_CopperTop; Fiducial_1mm_Dia_2.54mm_Outer_CopperTop-paste
