SpaceScienceSweden/ulv_electronics/power4/power4.kicad_pcb

## KiCad design power4/power4.kicad_pcb (2017-08-28)

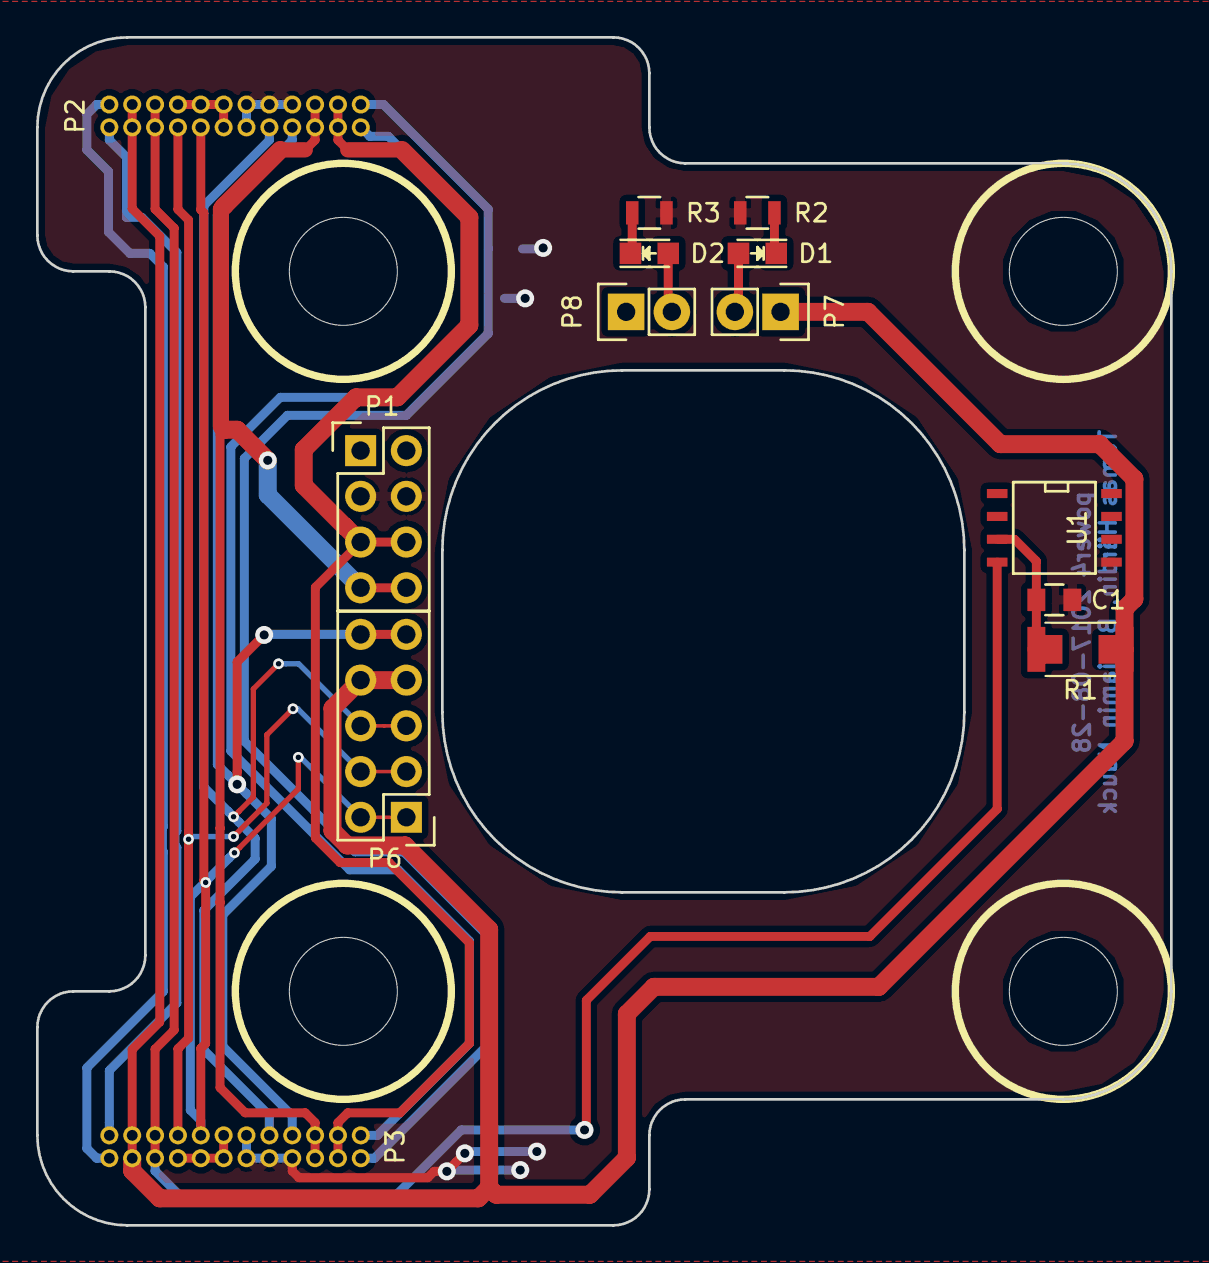
[picture p26: board power4.kicad_pcb from above]

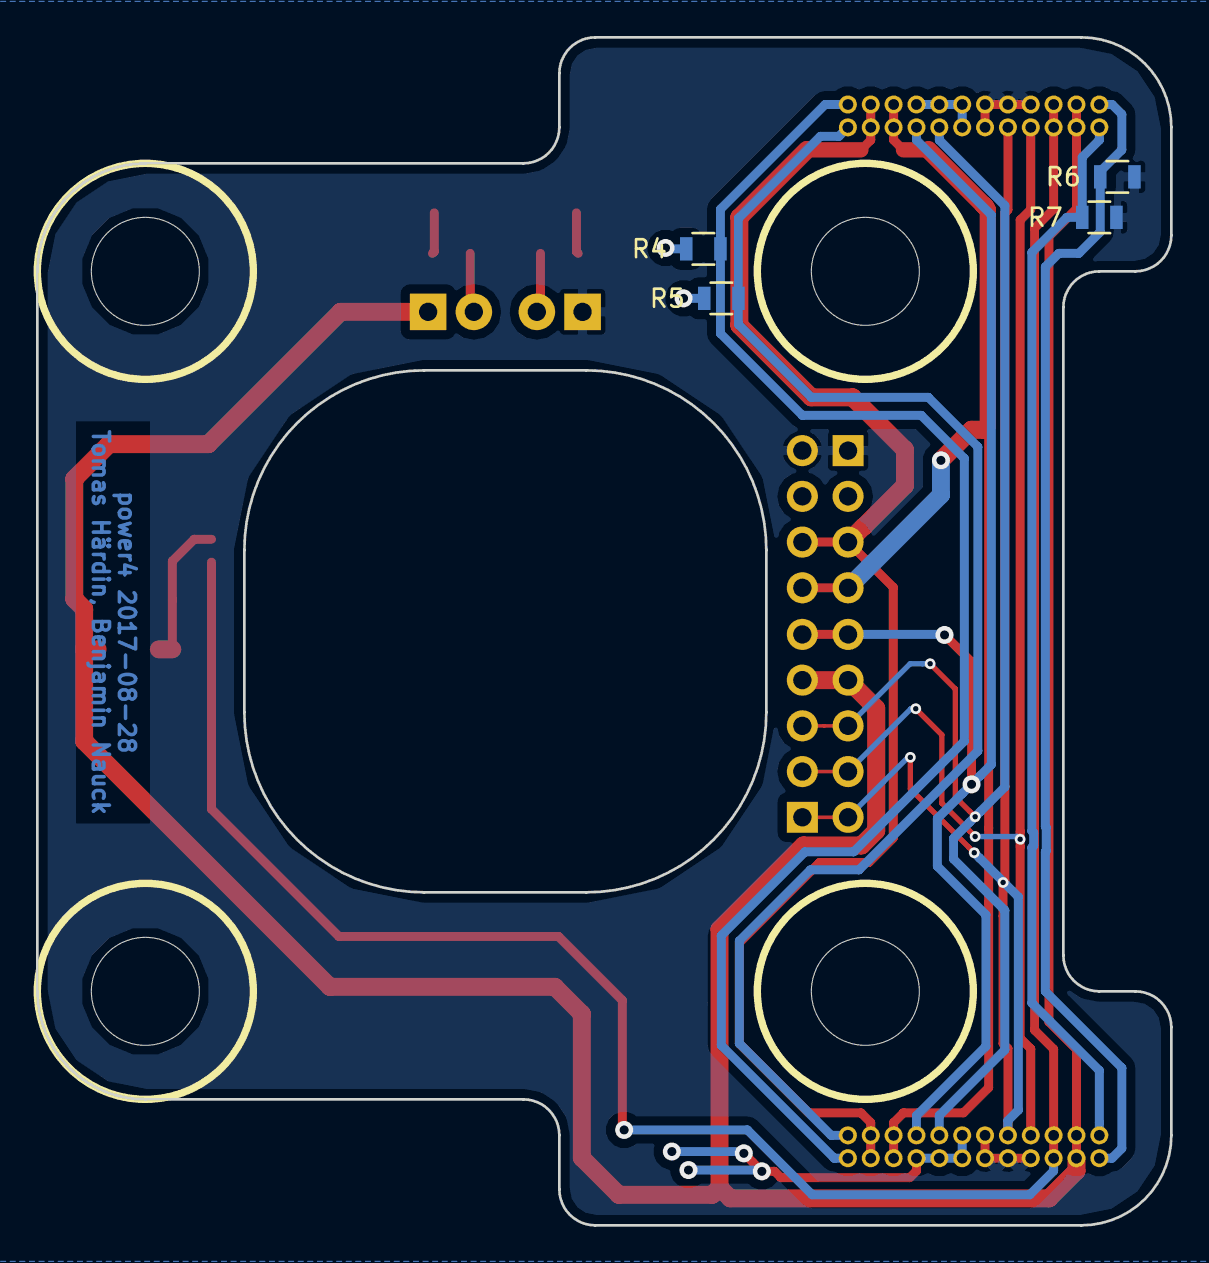
[picture p27: board power4.kicad_pcb from below]

Board: 2 copper layers, 63.0 x 66.0 mm, 17 parts (4 on the bottom side), 19 nets.

Parts:
C1: 10u; C_0805
D1, D2: LED; LED_0805
P1: LANDER; Pin_Header_Straight_2x04
P2, P3: CONN_02X12; FTSH-112-04-L-D-RA
P6: PROG; Pin_Header_Straight_2x05
P7, P8: CONN_01X02; Pin_Header_Straight_1x02
R1: 120; Resistor_1206_2010_combined
R2: 1k3; R_0805
R3: 22k; R_0805
R4, R5, R6, R7: 0; R_0805
U1: DS18B20Z; SOIC-8-N

Connections:
+3V3: P2.3, P2.4, P3.21, P3.22, P6.7, P6.8, P7.1, R1.1
//RESET: P2.17, P3.7, P6.9, P6.10
/A: P1.5, P1.6, P2.21, P2.22, P3.3, P3.4
/B: P1.7, P1.8, P2.19, P2.20, P3.5, P3.6
/ONEWIRE: P2.5, P2.6, P3.19, P3.20, U1.4
/PDI: P2.7, P3.17, P6.3, P6.4
/PDO: P2.9, P3.15, P6.1, P6.2
/SCK: P2.15, P3.9, P6.5, P6.6
/VLANDER: P1.1, P1.2, P2.8, P2.10, P2.11, P2.12, P3.13, P3.14, P3.16, P3.18, P8.1, R6.1, R7.1
GND: C1.1, P1.3, P1.4, P2.13, P2.14, P2.16, P2.18, P3.8, P3.10, P3.11, P3.12, R2.2, R3.2, R4.2, R5.2, U1.5
unnamed: C1.2, R1.2, U1.3
unnamed: D1.1, R2.1
unnamed: D1.2, P7.2
unnamed: D2.1, R3.1
unnamed: D2.2, P8.2
unnamed: P2.1, P3.23, R7.2
unnamed: P2.2, P3.24, R6.2
unnamed: P2.23, P3.1, R5.1
unnamed: P2.24, P3.2, R4.1
