SpaceScienceSweden/ulv_electronics/power1/ulv_PowerDistributionCircuit4.kicad_pcb

## KiCad design power1/ulv_PowerDistributionCircuit4.kicad_pcb (2016-08-17)

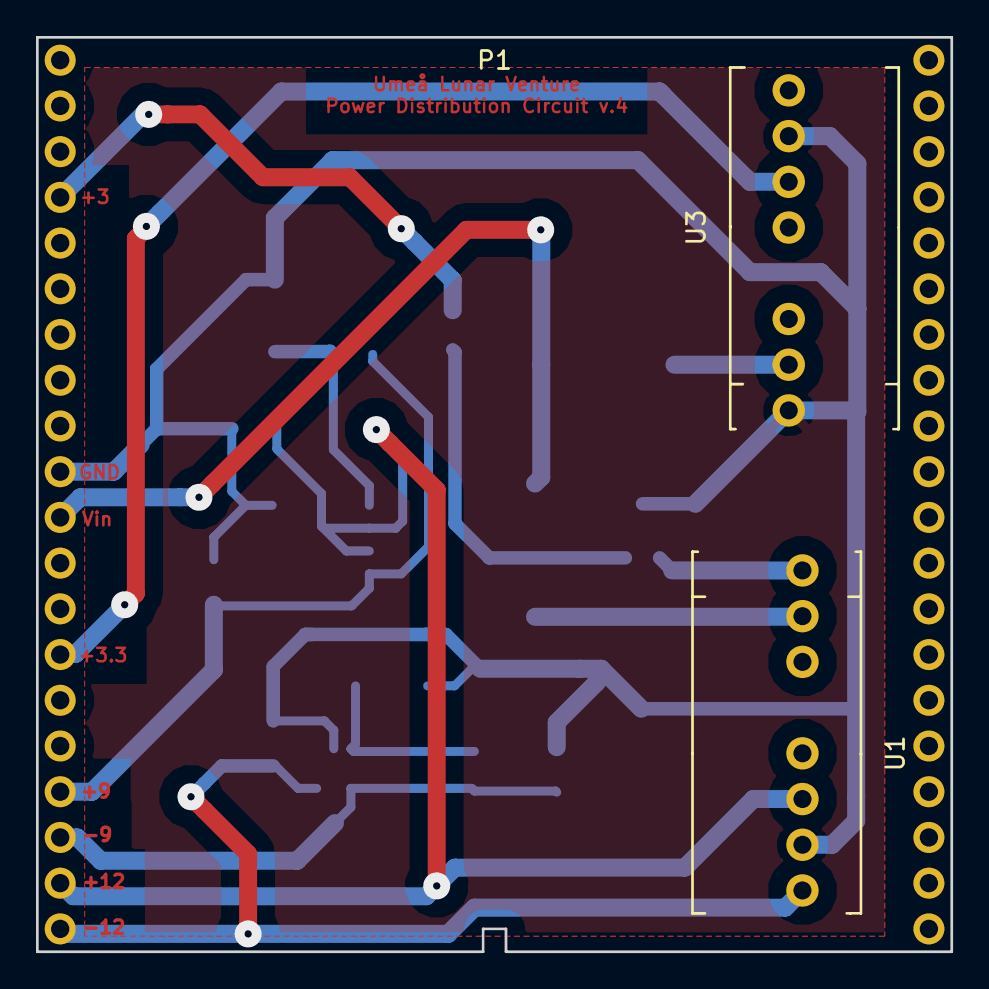
[picture p28: board ulv_PowerDistributionCircuit4.kicad_pcb from above]

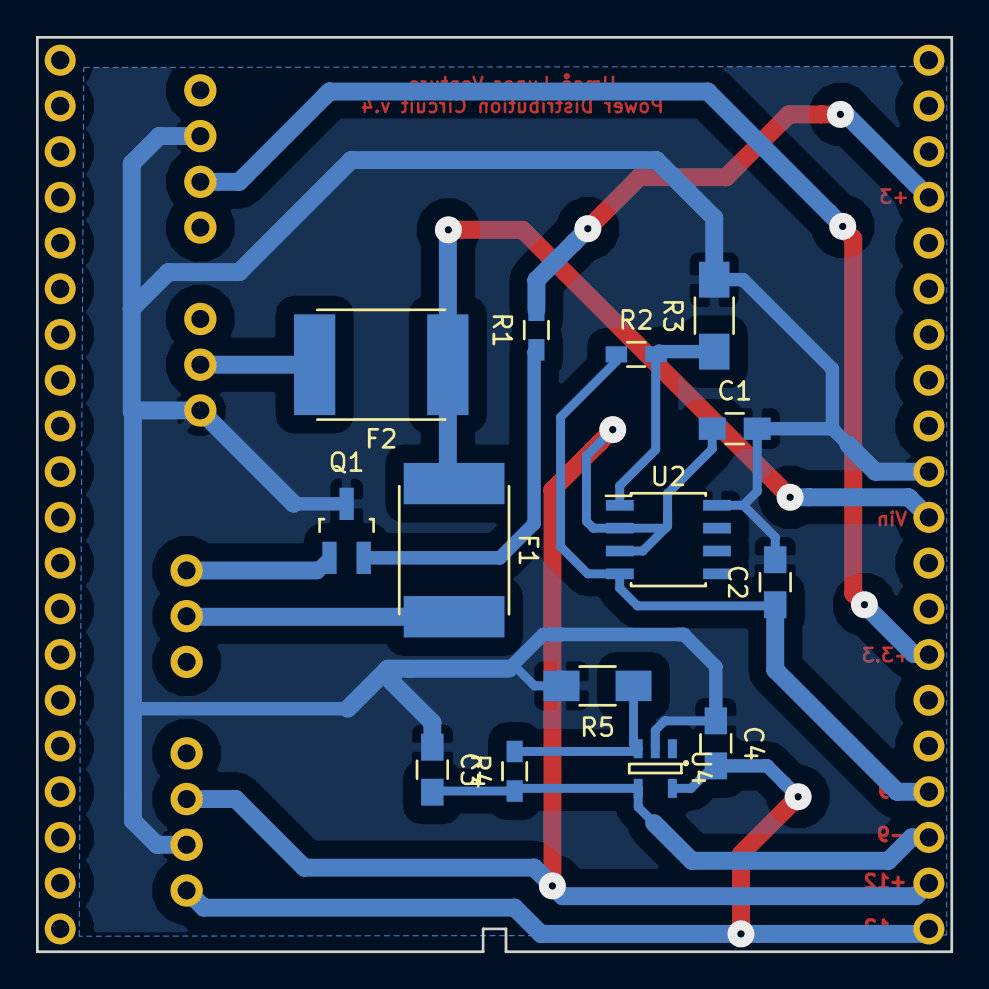
[picture p29: board ulv_PowerDistributionCircuit4.kicad_pcb from below]

Board: 2 copper layers, 50.8 x 50.8 mm, 17 parts (14 on the bottom side), 14 nets.

Parts:
C1: 0.1uF; C_0805_HandSoldering
C2, C3, C4: 10uF; C_0805_HandSoldering
F1, F2: F_Small; Fuse_SMD2920
P1: SCUBE40; scube40_no_holes
Q1: Q_NJFET_DGS; SOT-23_Handsoldering
R1: 10kO; R_0603_HandSoldering
R2, R4: 140kO; R_0603_HandSoldering
R3: 21.7kO; R_1206_HandSoldering
R5: 21.5kO; R_1206_HandSoldering
U1: RSO-2412D-Dual +/- 12V; RSO-2412D
U2: MAX1659 +9V; SOIC-8_3.9x4.9mm_Pitch1.27mm
U3: RSO-2412D-Single +3.3V; RSO-2412D
U4: MIC5270YM5-TR -9V; SOT-23-5

Connections:
unnamed: C1.1, P1.19, U1.6, U2.2, U2.3
unnamed: C1.2, C2.2, C3.1, C4.1, P1.10, Q1.3, R3.2, R5.2, U1.7, U2.8, U3.1, U3.7, U4.2
unnamed: C2.1, P1.17, R2.1, U2.4
unnamed: C3.2, P1.18, R4.1, U4.4
unnamed: C4.2, P1.20, U1.8, U4.5
unnamed: F1.1, F2.1, P1.11
unnamed: F1.2, U1.2
unnamed: F2.2, U3.2
unnamed: P1.4, R1.2
unnamed: P1.14, U3.6
unnamed: Q1.1, U1.1
unnamed: Q1.2, R1.1
unnamed: R2.2, R3.1, U2.1
unnamed: R4.2, R5.1, U4.3
