SpaceScienceSweden/ulv_electronics/power2/power2.kicad_pcb

## KiCad design power2/power2.kicad_pcb (2017-01-14)

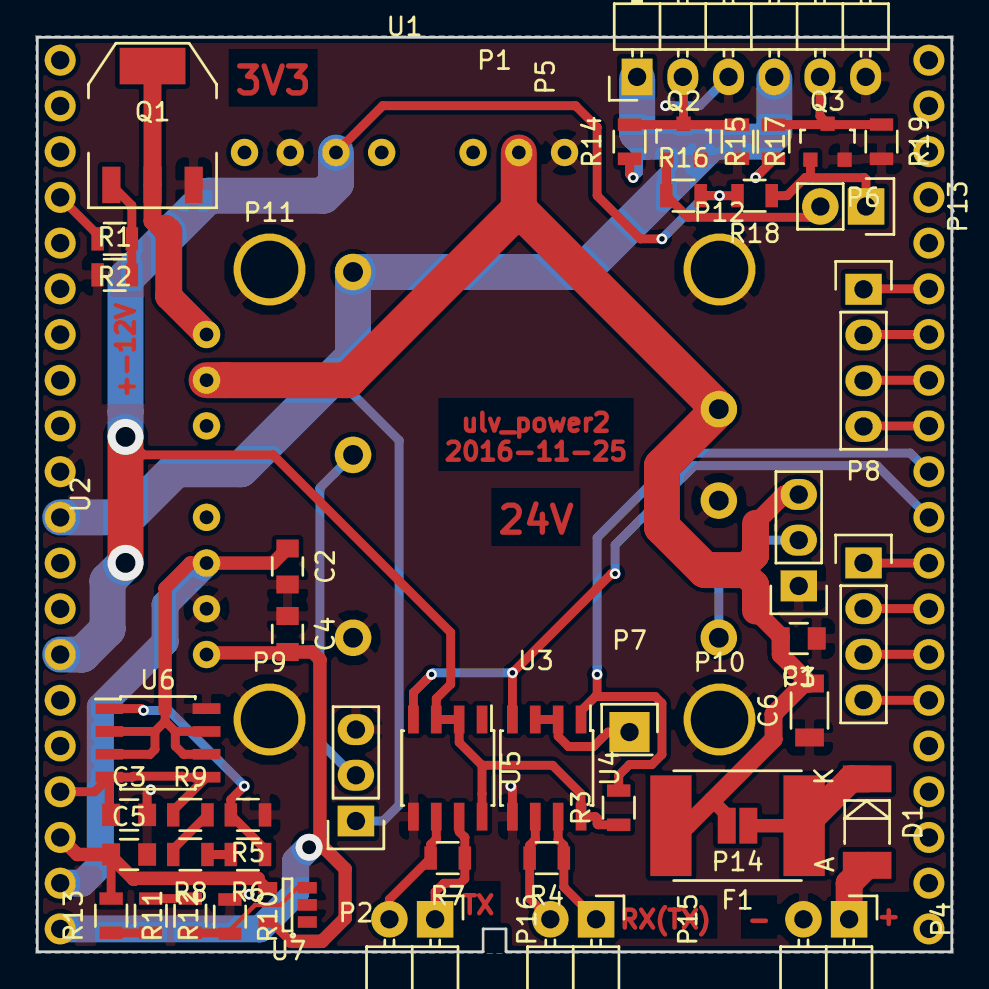
[picture p30: board power2.kicad_pcb from above]

Board: 2 copper layers, 50.8 x 50.8 mm, 53 parts (0 on the bottom side), 40 nets.

Parts:
C1, C3, C5: 10u; C_0805
C2, C4: 100n; C_0805
C6: 100u; C_1206
D1: SMS240; MELF_Standard
F1: PTC; Fuse_SMD2920
P1: SCUBE40; scube40_no_holes
P2: TRIM; Pin_Header_Straight_1x03
P3: ON/OFF; Pin_Header_Straight_1x03
P4: PWR; Pin_Header_Angled_1x02
P5: MOTOR_OUT; Pin_Header_Angled_1x06
P6: DE2; Pin_Header_Straight_1x04
P7: DE; Pin_Header_Straight_1x01
P8: DE1; Pin_Header_Straight_1x04
P9, P10, P11, P12: M3; M3_PTH
P13: PWM; Pin_Header_Straight_1x02
P14: FUSE_BYPASS; solder_bridge
P15: IN; Pin_Header_Angled_1x02
P16: OUT; Pin_Header_Angled_1x02
Q1: IRLL024NPBF; SOT-223
Q2, Q3: PMBF170; SOT-23
R1: 1M; R_0805
R2, R3, R5, R10: 10k; R_0805
R4, R7: 120; R_0805
R6, R11, R14, R15: 56k; R_0805
R8, R12: 8k2; R_0805
R9: 180; R_0805
R13: 820; R_0805
R16, R18: 100k; R_0805
R17, R19: open; R_0805
U1: RS-243.3S; RSO-2412D_v2
U2: RSO-2412D-Dual; RSO-2412D_v2
U3: THN_30-2415
U4, U5: MAX485; SOIC-8_3.9x4.9mm_Pitch1.27mm
U6: MAX1659; SOIC-8_3.9x4.9mm_Pitch1.27mm
U7: MIC5270YM5-TR; SOT-23-5

Connections:
+3V3: P1.14, R3.1, R16.2, R18.2, U1.6, U4.8, U5.2, U5.3, U5.8
+9V: C3.1, P1.17, R9.1, U6.4, U6.5
+12V: C2.1, P1.19, U2.6, U6.2, U6.3, U6.6, U6.7
+24V: P1.11, P2.1, P5.1, P5.4, R14.1, R15.1, U3.3
-9VA: C5.1, P1.18, R13.2, U7.4
-12VA: C4.2, P1.20, U2.8, U7.5
/A: P15.2, R4.2, U4.6
/B: P15.1, R4.1, U4.7
/EN_APWR: P1.4, R2.2
/RX: P1.31, R3.2, U4.1
/TX: P1.30, U4.4, U5.4
/Y: P16.2, R7.2, U5.6
/Z: P16.1, R7.1, U5.7
GND: C1.1, C2.2, C3.2, C4.1, C5.2, C6.1, P1.10, P2.3, P3.1, P4.2, P5.3, P5.6, P9.1, P10.1, P11.1, P12.1, Q1.3, Q2.2, Q3.2, R1.1, R5.1, R10.1, R17.2, R19.2, U1.1, U1.7, U2.7, U3.2, U3.5, U4.5, U5.5, U6.8, U7.2
unnamed: D1.1, F1.1, P14.1
unnamed: D1.2, P4.1
unnamed: P1.26, P8.4
unnamed: P1.27, P8.3
unnamed: P1.28, P8.2
unnamed: P1.29, P8.1
unnamed: P1.32, P6.4
unnamed: P1.33, P6.3
unnamed: P1.34, P6.2
unnamed: P1.35, P6.1
unnamed: P2.2, U3.4
unnamed: P3.2, U3.6
unnamed: P5.2, Q2.3, R14.2, R17.1
unnamed: P5.5, Q3.3, R15.2, R19.1
unnamed: P7.1, U4.2, U4.3
unnamed: P13.1, Q3.1, R18.1
unnamed: P13.2, Q2.1, R16.1
unnamed: Q1.1, R1.2, R2.1
unnamed: Q1.2, Q1.4, U2.1
unnamed: R5.2, R6.1, U6.1
unnamed: R6.2, R8.1
unnamed: R8.2, R9.2
unnamed: R10.2, R11.1, U7.3
unnamed: R11.2, R12.1
unnamed: R12.2, R13.1
VIN: C1.2, C6.2, F1.2, P3.3, P14.2, U1.2, U2.2, U3.1
