SpaceScienceSweden/ulv_electronics/fieldmill7/fieldmill7.kicad_pcb

## KiCad design fieldmill7/fieldmill7.kicad_pcb (2017-01-14)

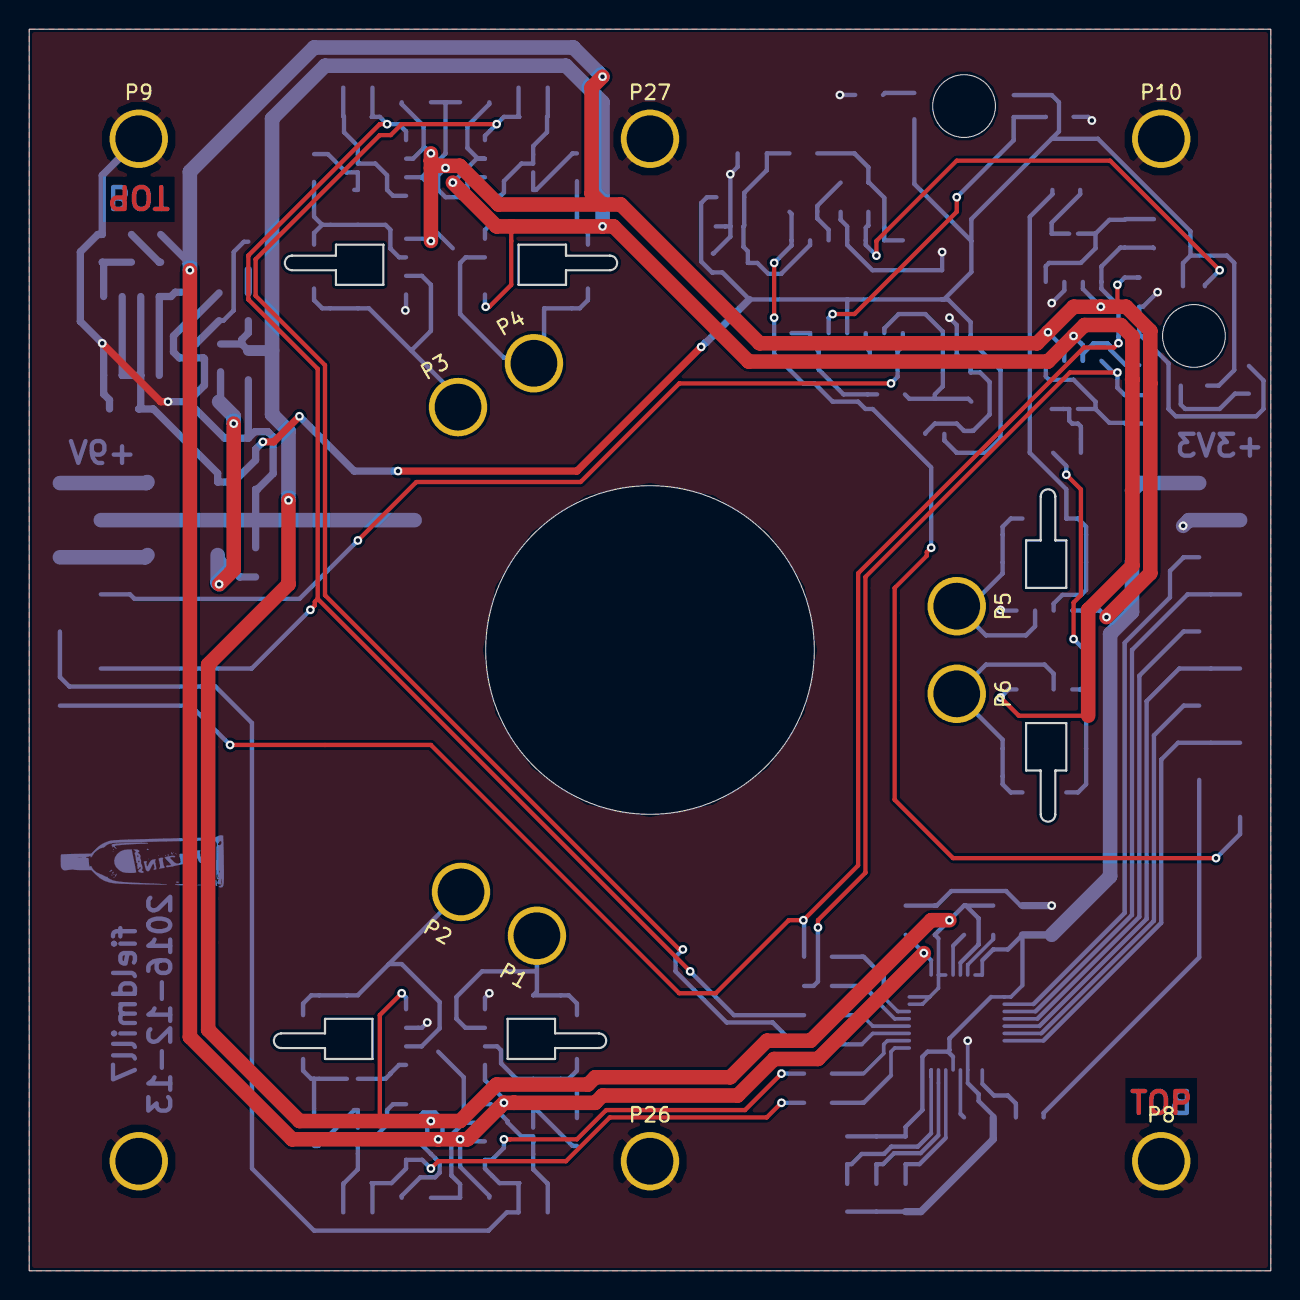
[picture p31: board fieldmill7.kicad_pcb from above]

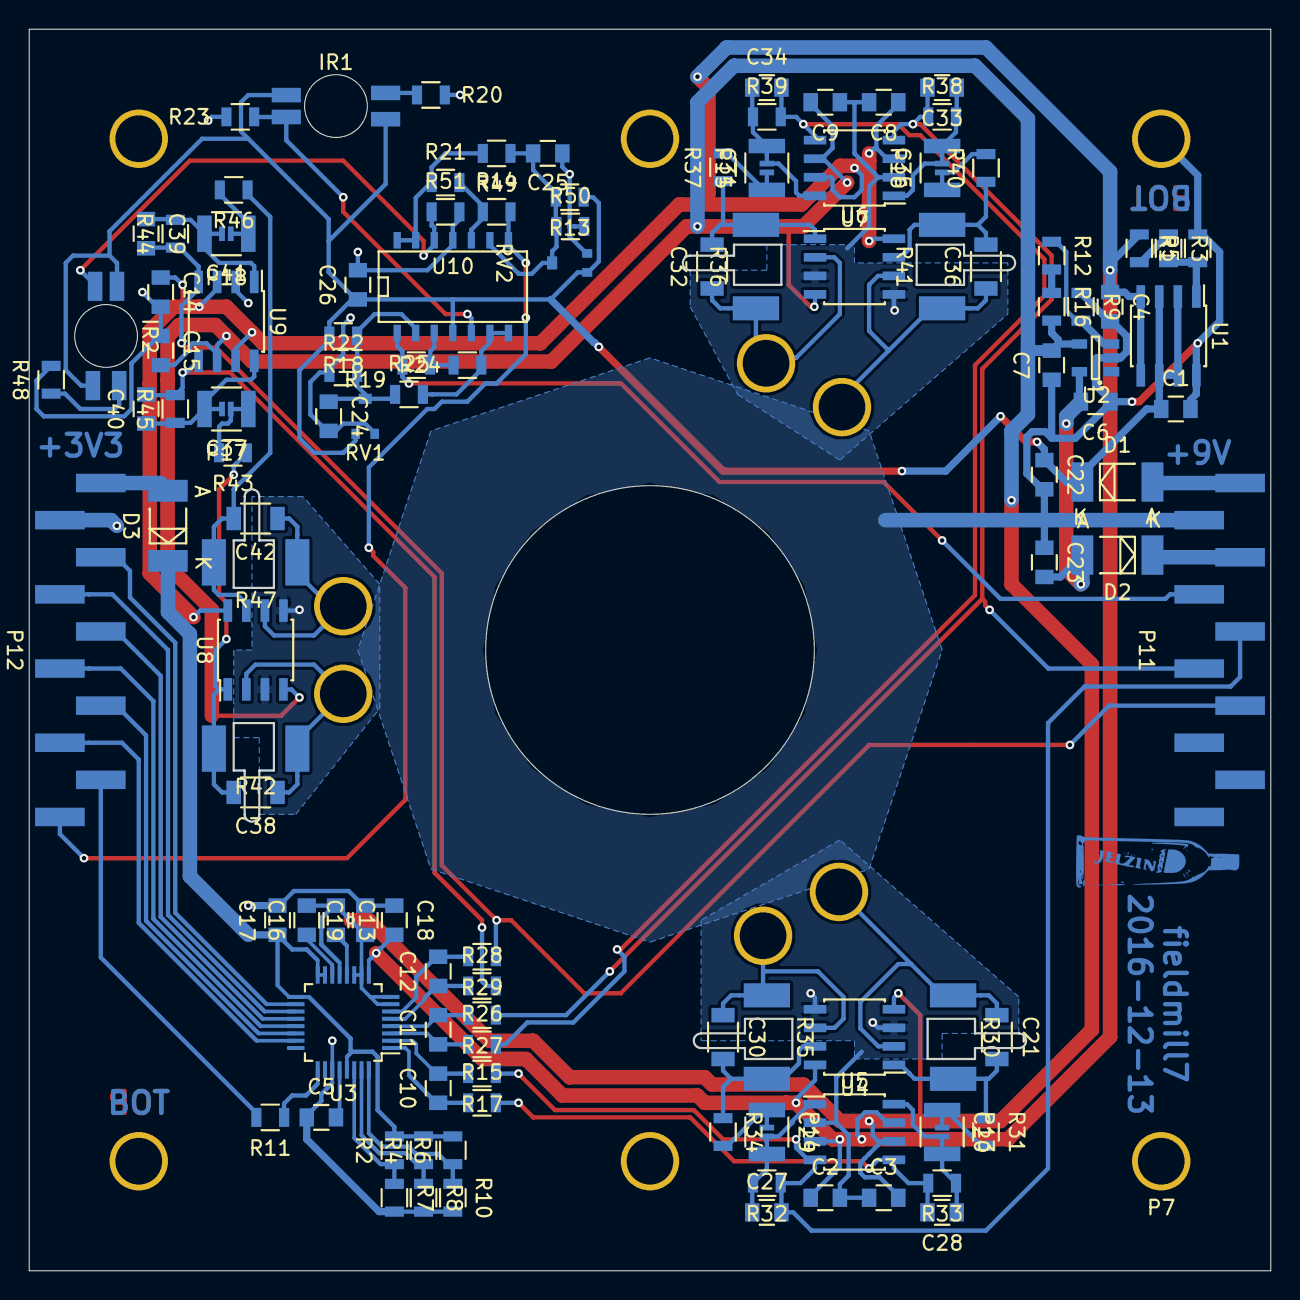
[picture p32: board fieldmill7.kicad_pcb from below]

Board: 2 copper layers, 85.0 x 85.0 mm, 130 parts (119 on the bottom side), 75 nets.

Parts:
C1, C2, C3, C6, C8, C9, C14, C15, C24, C25, C26: 100n; C_0805
C4, C7, C22, C23: 10u; C_0805
C5, C13, C16, C17, C18, C19: 1u; C_0805
C10, C11, C12: 10n; C_0805
C20, C29, C31, C35, C37, C41: 220n; C_1210
C21, C30, C32, C36, C38, C42: 10p; C_1206
C27, C28, C33, C34, C39, C40: 1n; C_0805
D1, D2, D3: SMS240; MELF_Standard
IR1, IR2: SG-2BC
P1, P2, P3, P4, P5, P6: SENSOR; M3_PTH
P7, P8, P9, P10, P26, P27: M3; M3_PTH
P11, P12: CONN_01X10; SMD_pinheader_1x10
P13, P14, P15, P16, P17, P18: NO_HIPASS; solder_bridge_1mm
R1, R3, R9, R12, R21, R24: 10k; R_0805
R2, R4, R6, R7, R8, R10: 470; R_0805
R5: 665; R_0805
R11: 50; R_0805
R13, R18: 220k; R_0805
R14, R19, R25, R49: 1M; R_0805
R15, R17, R26, R27, R28, R29: 1k; R_0805
R16: 845; R_0805
R20, R48: 5k6; R_0805
R22, R50: 100k; R_0805
R23, R51: 470k; R_0805
R30, R35, R36, R41, R42, R47: 10M; Resistor_2010_2512_combined
R31, R32, R33, R34, R37, R38, R39, R40, R43, R44, R45, R46: 18k; R_0805
RV1, RV2: 22k; PVZ2A
U1: MAX1659; SOIC-8_3.9x4.9mm_Pitch1.27mm
U2: MIC5270YM5-TR; SOT-23-5
U3: ADS131A04; LQFP-32_5x5mm_Pitch0.5mm
U4, U6, U8: LTC6241; SOIC-8_3.9x4.9mm_Pitch1.27mm
U5, U7, U9: OPA1632; SOIC-8_3.9x4.9mm_Pitch1.27mm
U10: LM324; SOIC-14_N

Connections:
+2V5: C2.1, C4.1, C8.1, C14.1, C18.2, R5.1, U1.4, U1.5, U3.9, U4.8, U5.3, U5.7, U6.8, U7.3, U7.7, U8.8, U9.3, U9.7
+3V3: C17.1, D3.1, R2.2, R4.2, R6.2, U3.15, U3.16, U3.17, U3.29
+9V: C1.1, C22.1, C26.1, D1.1, IR1.A, IR1.C, IR2.A, IR2.C, R13.1, R18.1, RV1.1, RV2.1, U1.2, U1.3, U1.6, U1.7, U10.4
-2V5: C3.2, C7.2, C9.2, C13.1, C15.2, C16.2, C19.1, R16.2, U2.4, U3.7, U3.8, U3.10, U3.11, U3.13, U4.4, U5.6, U6.4, U7.6, U8.4, U9.6
-9VA: C6.2, C23.2, D2.2, U2.5
//CS: P12.3, U3.23
//DONE: P12.8, U3.18
//DRDY: P12.7, U3.19
/ITACH: P11.4, R19.2, U10.1
/MISO: P12.5, U3.21
/MOSI: P12.6, U3.20
/QTACH: P12.1, R14.2, U10.8
/SCLK: P12.4, U3.22
/channel1/OUT+: C27.2, P11.5, R17.1, R32.1, U5.4
/channel1/OUT-: C28.2, R15.2, R33.2, U5.5
/channel1/SENSORN: C21.1, P2.1, R30.1, U4.2
/channel1/SENSORP: C30.1, P1.1, R35.1, U4.6
/channel2/OUT+: C33.2, P11.6, R27.1, R38.1, U7.4
/channel2/OUT-: C34.2, R26.2, R39.2, U7.5
/channel2/SENSORN: C32.1, P4.1, R36.1, U6.2
/channel2/SENSORP: C36.1, P3.1, R41.1, U6.6
/channel3/OUT+: C39.2, P11.7, R29.1, R44.1, U9.4
/channel3/OUT-: C40.2, R28.2, R45.2, U9.5
/channel3/SENSORN: C38.1, P6.1, R42.1, U8.2
/channel3/SENSORP: C42.1, P5.1, R47.1, U8.6
/f_ADC: P12.2, R11.2
GND: C1.2, C2.2, C3.1, C4.2, C5.1, C6.1, C7.1, C8.2, C9.1, C14.2, C15.1, C17.2, C18.1, C19.2, C22.2, C23.1, C24.2, C25.2, C26.2, P7.1, P8.1, P9.1, P10.1, P11.2, P12.9, P26.1, P27.1, R1.2, R7.2, R8.2, R9.1, R10.2, R20.2, R22.2, R23.2, R48.2, R50.2, R51.2, RV1.3, RV2.3, U1.8, U2.2, U3.27, U4.3, U4.5, U5.2, U6.3, U6.5, U7.2, U8.3, U8.5, U9.2, U10.11
unnamed: C5.2, U3.28
unnamed: C10.1, R15.1, U3.1
unnamed: C10.2, R17.2, U3.2
unnamed: C11.1, R26.1, U3.3
unnamed: C11.2, R27.2, U3.4
unnamed: C12.1, R28.1, U3.5
unnamed: C12.2, R29.2, U3.6
unnamed: C13.2, U3.12
unnamed: C16.1, U3.14
unnamed: C20.1, P13.2, R31.2
unnamed: C20.2, C28.1, P13.1, R33.1, U5.8
unnamed: C21.2, R30.2, R31.1, U4.1
unnamed: C24.1, R18.2, R22.1, R25.1, RV1.2, U10.2
unnamed: C25.1, R13.2, R49.1, R50.1, RV2.2, U10.9
unnamed: C27.1, C29.2, P14.1, R32.2, U5.1
unnamed: C29.1, P14.2, R34.2
unnamed: C30.2, R34.1, R35.2, U4.7
unnamed: C31.1, P15.2, R37.2
unnamed: C31.2, C34.1, P15.1, R39.1, U7.8
unnamed: C32.2, R36.2, R37.1, U6.1
unnamed: C33.1, C35.2, P16.1, R38.2, U7.1
unnamed: C35.1, P16.2, R40.2
unnamed: C36.2, R40.1, R41.2, U6.7
unnamed: C37.1, P17.2, R43.2
unnamed: C37.2, C40.1, P17.1, R45.1, U9.8
unnamed: C38.2, R42.2, R43.1, U8.1
unnamed: C39.1, C41.2, P18.1, R44.2, U9.1
unnamed: C41.1, P18.2, R46.2
unnamed: C42.2, R46.1, R47.2, U8.7
unnamed: D1.2, P11.1
unnamed: D2.1, P11.3
unnamed: D3.2, P12.10
unnamed: IR1.E, R23.1, U10.5
unnamed: IR1.K, R20.1
unnamed: IR2.E, R51.1, U10.12
unnamed: IR2.K, R48.1
unnamed: R1.1, R3.2, U1.1
unnamed: R2.1, R7.1, U3.30
unnamed: R3.1, R5.2
unnamed: R4.1, R8.1, U3.31
unnamed: R6.1, R10.1, U3.32
unnamed: R11.1, U3.25
unnamed: R9.2, R12.1, U2.3
unnamed: R12.2, R16.1
unnamed: R14.1, R21.2, U10.10
unnamed: R19.1, R24.2, U10.3
unnamed: R21.1, R49.2, U10.13, U10.14
unnamed: R24.1, R25.2, U10.6, U10.7
