SpaceScienceSweden/ulv_electronics/adc1/adc1.kicad_pcb

## KiCad design adc1/adc1.kicad_pcb (2016-10-04)

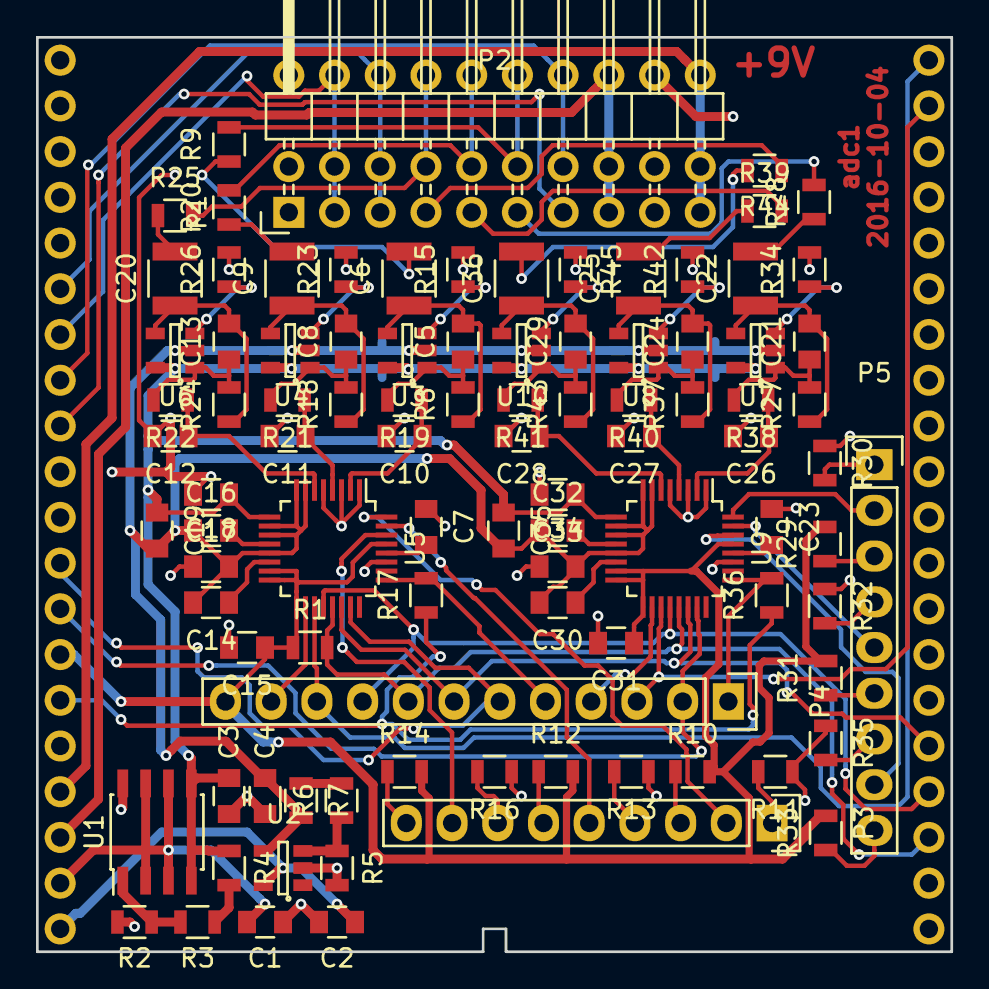
[picture p33: board adc1.kicad_pcb from above]

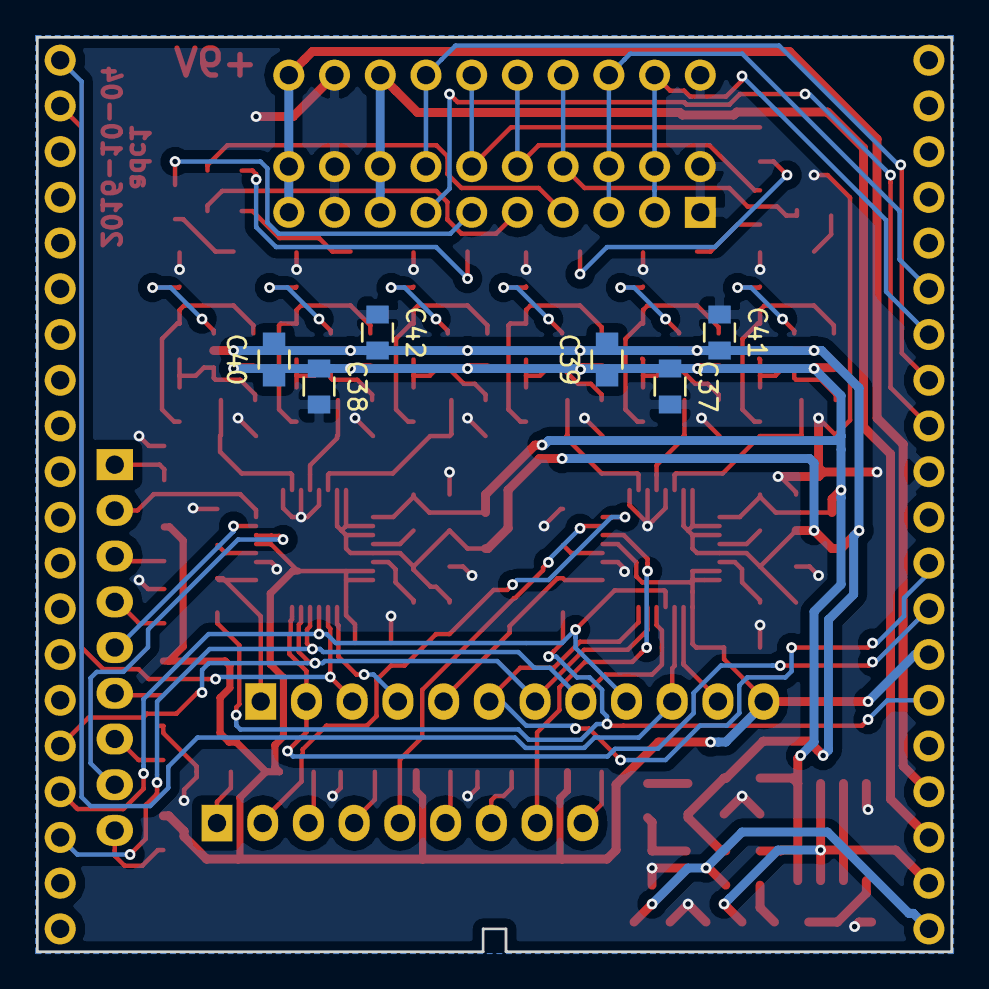
[picture p34: board adc1.kicad_pcb from below]

Board: 2 copper layers, 50.8 x 50.8 mm, 102 parts (6 on the bottom side), 88 nets.

Parts:
C1, C2, C37, C38, C39, C40, C41, C42: 100n; C_0805
C3, C4: 10u; C_0805
C5, C8, C13, C21, C24, C29: 1n; C_0805
C6, C9, C20, C22, C25, C36: 220n; C_1210
C7, C14, C15, C16, C17, C18, C19, C23, C30, C31, C32, C33, C34, C35: 1u; C_0805
C10, C11, C12, C26, C27, C28: 18n; C_0805
P1: CONN_02X10; Pin_Header_Angled_2x10_dualfootprint
P2: SCUBE40; scube40_no_holes
P3, P5: CONN_01X09; Pin_Header_Straight_1x09
P4: DEBUG; Pin_Header_Straight_1x12
R1: 100k; R_0805
R2, R3, R5, R6: 10k; R_0805
R4: 660; R_0805
R7: 830; R_0805
R8, R9, R15, R18, R20, R23, R24, R25, R26, R27, R28, R34, R37, R39, R42, R43, R44, R45: 18k; R_0805
R10, R11, R12, R13, R14, R16, R29, R30, R31, R32, R33, R35: 470; R_0805
R17, R36: 50; R_0805
R19, R21, R22, R38, R40, R41: 1k; R_0805
U1: MAX1659; SOIC-8_3.9x4.9mm_Pitch1.27mm
U2: MIC5270YM5-TR; SOT-23-5
U3, U4, U6, U7, U8, U10: LM6211MF; SOT-23-5
U5, U9: ADS131A04; LQFP-32_5x5mm_Pitch0.5mm

Connections:
+2V5: C3.1, C17.1, C19.1, C33.1, C35.1, C37.1, C38.1, C39.1, C40.1, R4.2, U1.4, U1.5, U3.5, U4.5, U5.9, U6.5, U7.5, U8.5, U9.9, U10.5
+3V3: C15.1, C31.1, P2.14, P4.12, R1.1, R10.2, R12.2, R14.2, R29.2, R31.2, R33.2, U5.15, U5.16, U5.17, U5.29, U9.15, U9.16, U9.17, U9.29
+9V: P1.19, P1.20, P2.17
-2V5: C4.1, C14.2, C16.1, C18.2, C19.2, C30.2, C32.1, C34.2, C35.2, C39.2, C40.2, C41.2, C42.2, R7.2, U2.4, U3.2, U4.2, U5.7, U5.8, U5.10, U5.11, U5.13, U6.2, U7.2, U8.2, U9.7, U9.8, U9.10, U9.11, U9.13, U10.2
-9VA: P1.15, P1.16, P2.18
/A0: P1.5, P1.6, P2.6
/A1: P1.3, P1.4, P2.7
/TACHa: P1.14, P2.8
/TACHb: P1.13, P2.9
/channel1//CS: P2.12, P4.6, U5.23
/channel1//DONE: P4.11, U5.18
/channel1//DRDY: P2.40, P4.10, U5.19
/channel1/AIN1: P1.12, R9.2
/channel1/AIN2: P1.10, R20.2
/channel1/AIN3: P1.8, R25.2
/channel1/f_out: P4.5, R17.2, U5.25
/channel2//CS: P2.13, P4.2, U9.23
/channel2//DONE: P4.4, U9.18
/channel2//DRDY: P2.39, P4.3, U9.19
/channel2/AIN1: P1.11, R28.2
/channel2/AIN2: P1.9, R39.2
/channel2/AIN3: P1.7, R44.2
/channel2/f_out: P4.1, R36.2, U9.25
GND: C1.2, C2.1, C3.2, C4.2, C7.1, C10.2, C11.2, C12.2, C15.2, C17.2, C18.1, C23.1, C26.2, C27.2, C28.2, C31.2, C33.2, C34.1, C37.2, C38.2, C41.1, C42.1, P1.1, P1.2, P1.17, P1.18, P2.10, R2.1, R5.1, R11.1, R13.1, R15.2, R16.1, R23.2, R26.2, R30.1, R32.1, R34.2, R35.1, R42.2, R45.2, U1.8, U2.2, U5.1, U5.3, U5.5, U5.27, U9.1, U9.3, U9.5, U9.27
MISO: P2.23, P4.8, R1.2, U5.21, U9.21
MOSI: P2.24, P4.9, U5.20, U9.20
unnamed: C1.1, P2.19, U1.2, U1.3, U1.6, U1.7
unnamed: C2.2, P2.20, U2.5
unnamed: C5.1, R8.2, R19.2, U3.1
unnamed: C5.2, C6.1, R8.1, U3.4
unnamed: C6.2, R9.1
unnamed: C7.2, U5.28
unnamed: C8.1, R18.2, R21.2, U4.1
unnamed: C8.2, C9.1, R18.1, U4.4
unnamed: C9.2, R20.1
unnamed: C10.1, R19.1, U5.2
unnamed: C11.1, R21.1, U5.4
unnamed: C12.1, R22.1, U5.6
unnamed: C13.1, R22.2, R24.2, U6.1
unnamed: C13.2, C20.1, R24.1, U6.4
unnamed: C14.1, U5.14
unnamed: C16.2, U5.12
unnamed: C20.2, R25.1
unnamed: C21.1, R27.2, R38.2, U7.1
unnamed: C21.2, C22.1, R27.1, U7.4
unnamed: C22.2, R28.1
unnamed: C23.2, U9.28
unnamed: C24.1, R37.2, R40.2, U8.1
unnamed: C24.2, C25.1, R37.1, U8.4
unnamed: C25.2, R39.1
unnamed: C26.1, R38.1, U9.2
unnamed: C27.1, R40.1, U9.4
unnamed: C28.1, R41.1, U9.6
unnamed: C29.1, R41.2, R43.2, U10.1
unnamed: C29.2, C36.1, R43.1, U10.4
unnamed: C30.1, U9.14
unnamed: C32.2, U9.12
unnamed: C36.2, R44.1
unnamed: P3.1, R11.2
unnamed: P3.2, U5.32
unnamed: P3.3, R10.1
unnamed: P3.4, R13.2
unnamed: P3.5, U5.31
unnamed: P3.6, R12.1
unnamed: P3.7, R16.2
unnamed: P3.8, U5.30
unnamed: P3.9, R14.1
unnamed: P5.1, R30.2
unnamed: P5.2, U9.32
unnamed: P5.3, R29.1
unnamed: P5.4, R32.2
unnamed: P5.5, U9.31
unnamed: P5.6, R31.1
unnamed: P5.7, R35.2
unnamed: P5.8, U9.30
unnamed: P5.9, R33.1
unnamed: R2.2, R3.1, U1.1
unnamed: R3.2, R4.1
unnamed: R5.2, R6.1, U2.3
unnamed: R6.2, R7.1
unnamed: R15.1, U3.3
unnamed: R23.1, U4.3
unnamed: R26.1, U6.3
unnamed: R34.1, U7.3
unnamed: R42.1, U8.3
unnamed: R45.1, U10.3
SCLK: P2.25, P4.7, U5.22, U9.22
f_ADC: P2.15, R17.1, R36.1
