SpaceScienceSweden/ulv_electronics/demodulator3/demodulator3.kicad_pcb

## KiCad design demodulator3/demodulator3.kicad_pcb (2016-08-09)

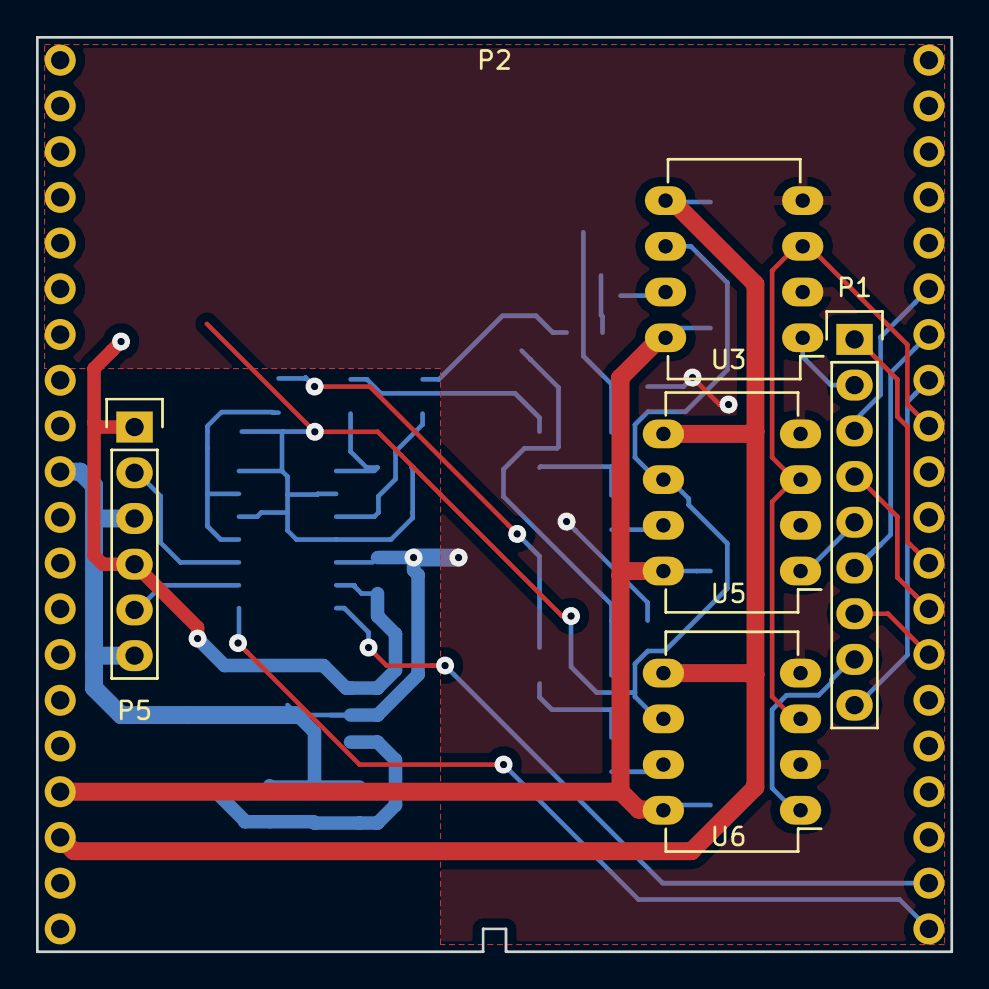
[picture p35: board demodulator3.kicad_pcb from above]

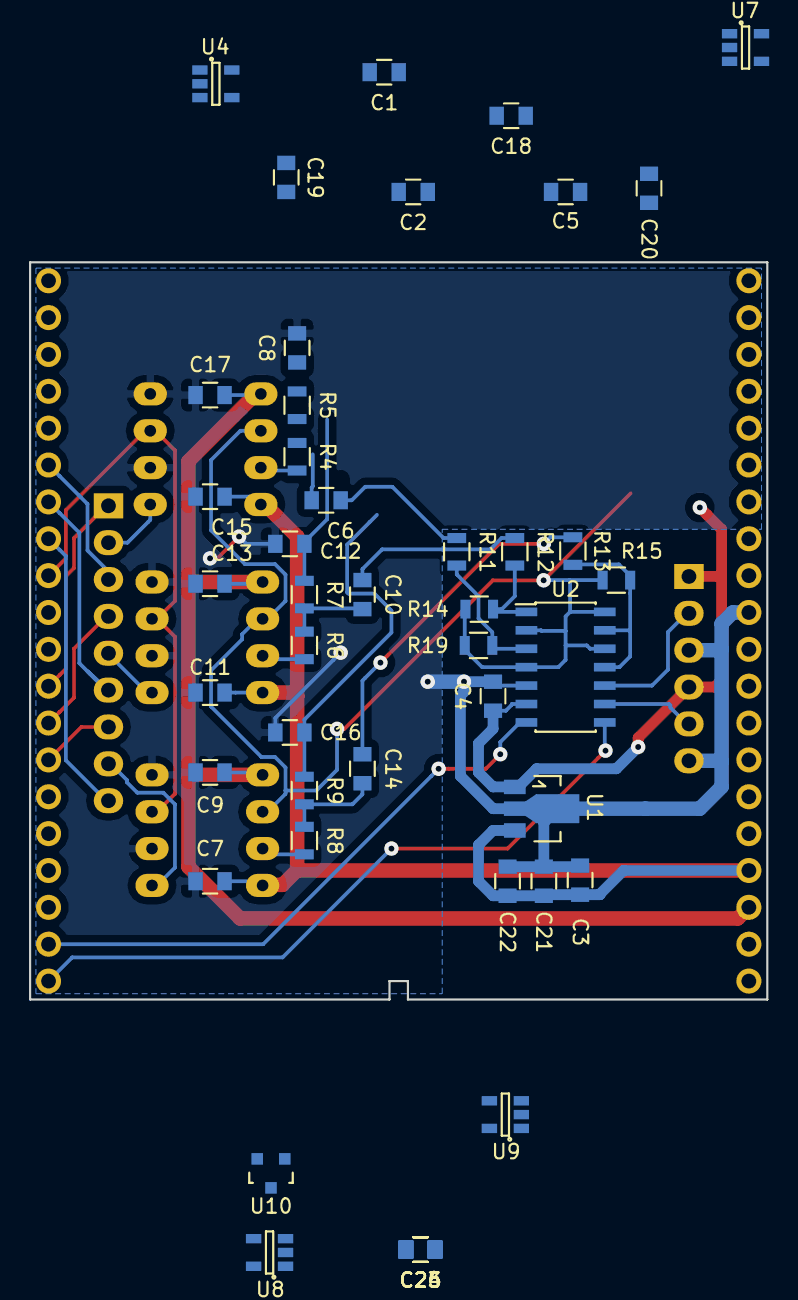
[picture p36: board demodulator3.kicad_pcb from below]

Board: 2 copper layers, 50.8 x 50.8 mm, 51 parts (45 on the bottom side), 35 nets.

Parts:
C1, C2, C3, C4, C5, C7, C9, C11, C13, C15, C17, C18, C19, C20, C21, C22, C23, C24, C25, C26: 100n; C_0805
C6, C8, C10, C12, C14, C16: 1u; C_0805
P1: CONN_01X09; Pin_Header_Straight_1x09
P2: SCUBE40; scube40_no_holes
P5: Adr conf; Pin_Header_Straight_1x06
R4, R5, R6, R7, R8, R9, R11, R12, R13: 100k; R_0805
R14, R15, R19: 10k; R_0805
U1: L78L33; SOT89-3_Housing
U2: MCP3428; SOIC-14_3.9x8.7mm_Pitch1.27mm
U3, U5, U6: AD633; DIP-8_W7.62mm_LongPads
U4, U7, U8, U9: LM6211MF; SOT-23-5
U10: ISL21010; SOT-23

Connections:
+3.3VADC: C4.1, C20.1, P5.1, P5.4, U1.1, U2.6, U10.1
+9V: C1.1, C3.1, C7.1, C11.1, C15.1, C18.1, C21.1, C22.1, C23.1, C24.1, P2.17, U1.3, U3.8, U4.5, U5.8, U6.8, U7.5, U8.5, U9.5
-9VA: C2.2, C9.2, C13.2, C17.2, C19.2, C25.2, C26.2, P2.18, U3.5, U4.2, U5.5, U6.5, U7.2, U8.2, U9.2
/SCL: P2.21, U2.8
/SDA: P2.22, U2.7
/channel1/BIAS: R14.1, R15.2, R19.1, U2.2, U2.4, U2.12, U2.14, U3.6, U4.1, U4.4, U5.6, U6.6
/channel1/DEMOD: C6.1, R11.1, U7.1, U7.4
/channel1/X: P1.2, U3.1
/channel1/Y: P2.32, U3.3, U5.3, U6.3
/channel2/DEMOD: C10.1, R12.1, U8.1, U8.4
/channel2/X: P1.5, U5.1
/channel3/DEMOD: C14.1, R13.2, U9.1, U9.4
/channel3/X: P1.8, U6.1
GND: C1.2, C2.1, C3.2, C4.2, C5.2, C7.2, C8.2, C9.1, C11.2, C12.2, C13.1, C15.2, C16.2, C17.1, C18.2, C19.1, C20.2, C21.2, C22.2, C23.2, C24.2, C25.1, C26.1, P2.10, P5.3, P5.6, U1.2, U2.5, U3.2, U3.4, U5.2, U5.4, U6.2, U6.4, U10.3
unnamed: C5.1, U4.3, U10.2
unnamed: C6.2, R4.1, R5.2
unnamed: C8.1, R5.1, U7.3
unnamed: C10.2, R6.1, R7.2
unnamed: C12.1, R7.1, U8.3
unnamed: C14.2, R8.1, R9.2
unnamed: C16.1, R9.1, U9.3
unnamed: P1.1, P2.29
unnamed: P1.3, P2.35
unnamed: P1.4, P2.28
unnamed: P1.6, P2.34
unnamed: P1.7, P2.27
unnamed: P1.9, P2.33
unnamed: P5.2, U2.10
unnamed: P5.5, U2.9
unnamed: R4.2, U3.7
unnamed: R6.2, U5.7
unnamed: R8.2, U6.7
unnamed: R11.2, R19.2, U2.3
unnamed: R12.2, R14.2, U2.1
unnamed: R13.1, R15.1, U2.11, U2.13
