SpaceScienceSweden/ulv_electronics/ulv_esc/ulv_esc.kicad_pcb

## KiCad design ulv_esc/ulv_esc.kicad_pcb (2016-08-08)

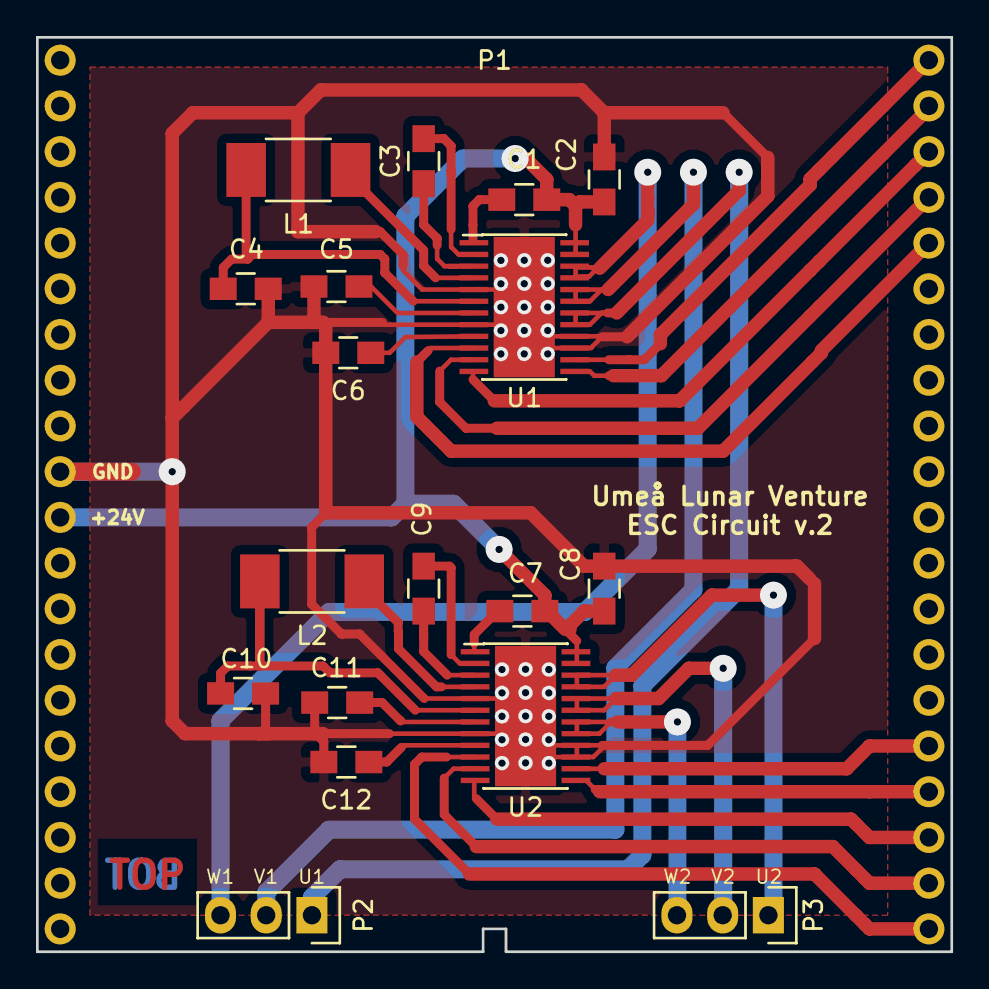
[picture p37: board ulv_esc.kicad_pcb from above]

Board: 2 copper layers, 50.8 x 50.8 mm, 19 parts (0 on the bottom side), 32 nets.

Parts:
C1, C3, C7, C9: 0.1 uF; C_0805_HandSoldering
C2, C4, C8, C10: 10 uF; C_0805_HandSoldering
C5, C6, C11, C12: 1 uF; C_0805_HandSoldering
L1, L2: 47 uH; C_1812_HandSoldering
P1: SCUBE40; scube40_no_holes
P2, P3: CONN_01X03; Pin_Header_Straight_1x03
U1, U2: DRV10983; TSSOP-24_Pitch0.65mm_PowerPad

Connections:
GND: C2.2, C4.1, C5.2, C6.2, C8.2, C10.1, C11.2, C12.2, P1.10, U1.5, U1.8, U1.15, U1.16, U1.25, U2.5, U2.8, U2.15, U2.16, U2.25
unnamed: C1.1, C2.1, C7.1, C8.1, P1.11, U1.23, U1.24, U2.23, U2.24
unnamed: C1.2, U1.1
unnamed: C3.1, U1.3
unnamed: C3.2, U1.2
unnamed: C4.2, L1.2, U1.6
unnamed: C5.1, U1.7
unnamed: C6.1, U1.9
unnamed: C7.2, U2.1
unnamed: C9.1, U2.3
unnamed: C9.2, U2.2
unnamed: C10.2, L2.2, U2.6
unnamed: C11.1, U2.7
unnamed: C12.1, U2.9
unnamed: L1.1, U1.4
unnamed: L2.1, U2.4
unnamed: P1.21, U2.10
unnamed: P1.22, U2.11
unnamed: P1.23, U2.12
unnamed: P1.24, U2.13
unnamed: P1.25, U2.14
unnamed: P1.36, U1.10
unnamed: P1.37, U1.11
unnamed: P1.38, U1.12
unnamed: P1.39, U1.13
unnamed: P1.40, U1.14
unnamed: P2.1, U1.17, U1.18
unnamed: P2.2, U1.19, U1.20
unnamed: P2.3, U1.21, U1.22
unnamed: P3.1, U2.21, U2.22
unnamed: P3.2, U2.19, U2.20
unnamed: P3.3, U2.17, U2.18
