SpaceScienceSweden/ulv_electronics/demodulator/demodulator.kicad_pcb

## KiCad design demodulator/demodulator.kicad_pcb (2016-08-06)

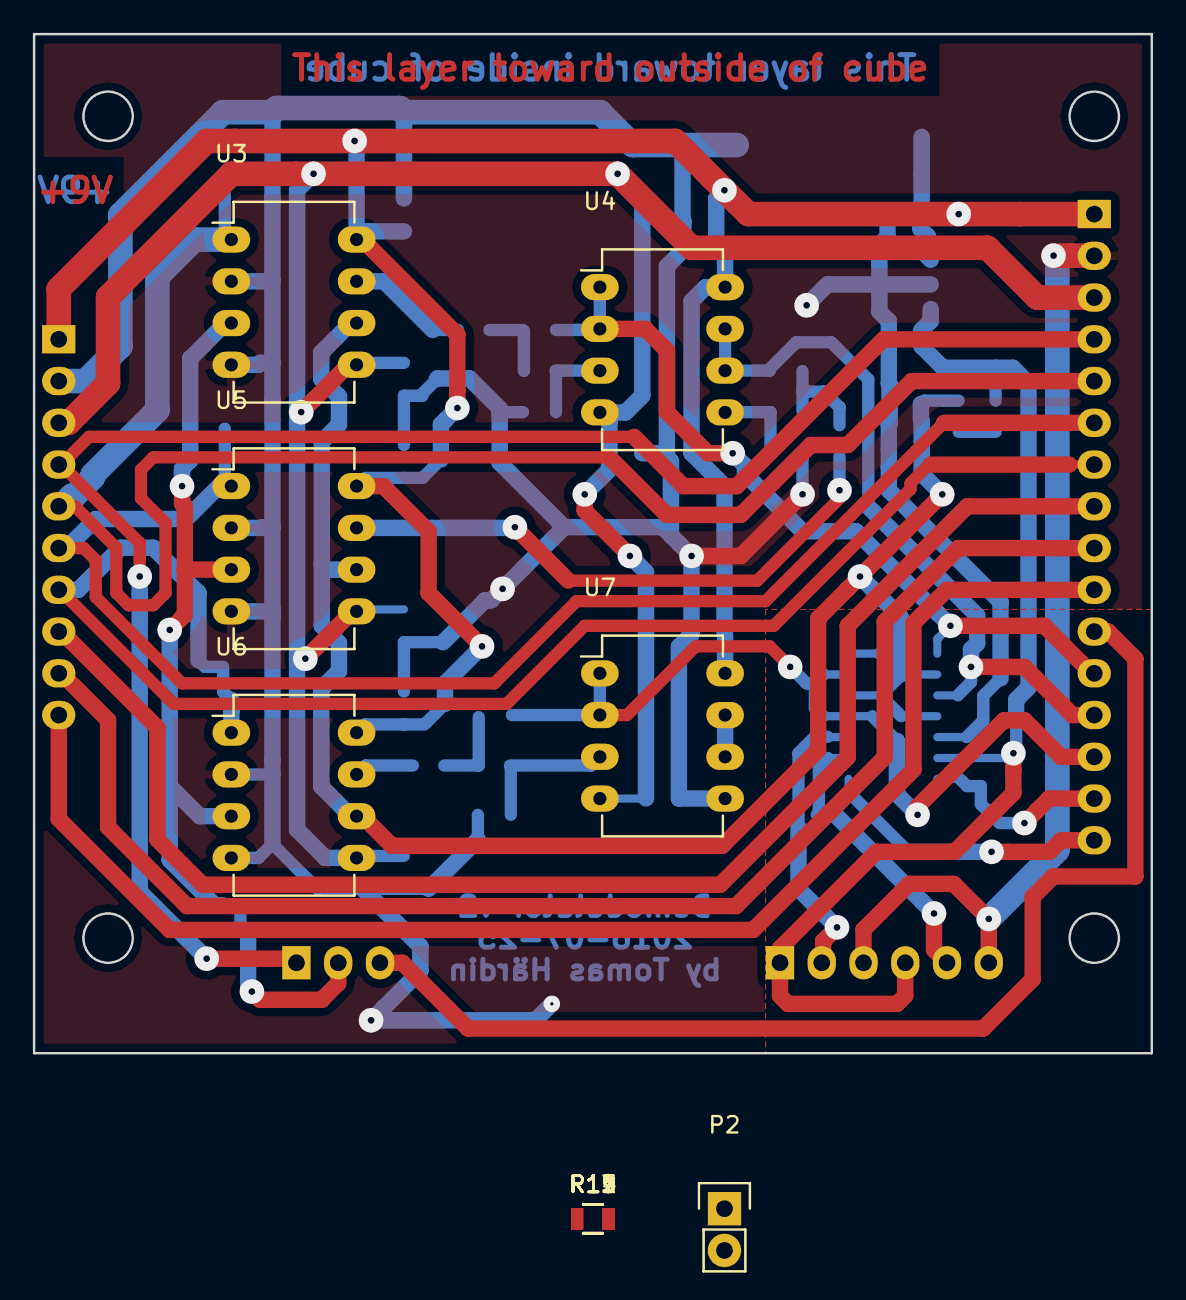
[picture p38: board demodulator.kicad_pcb from above]

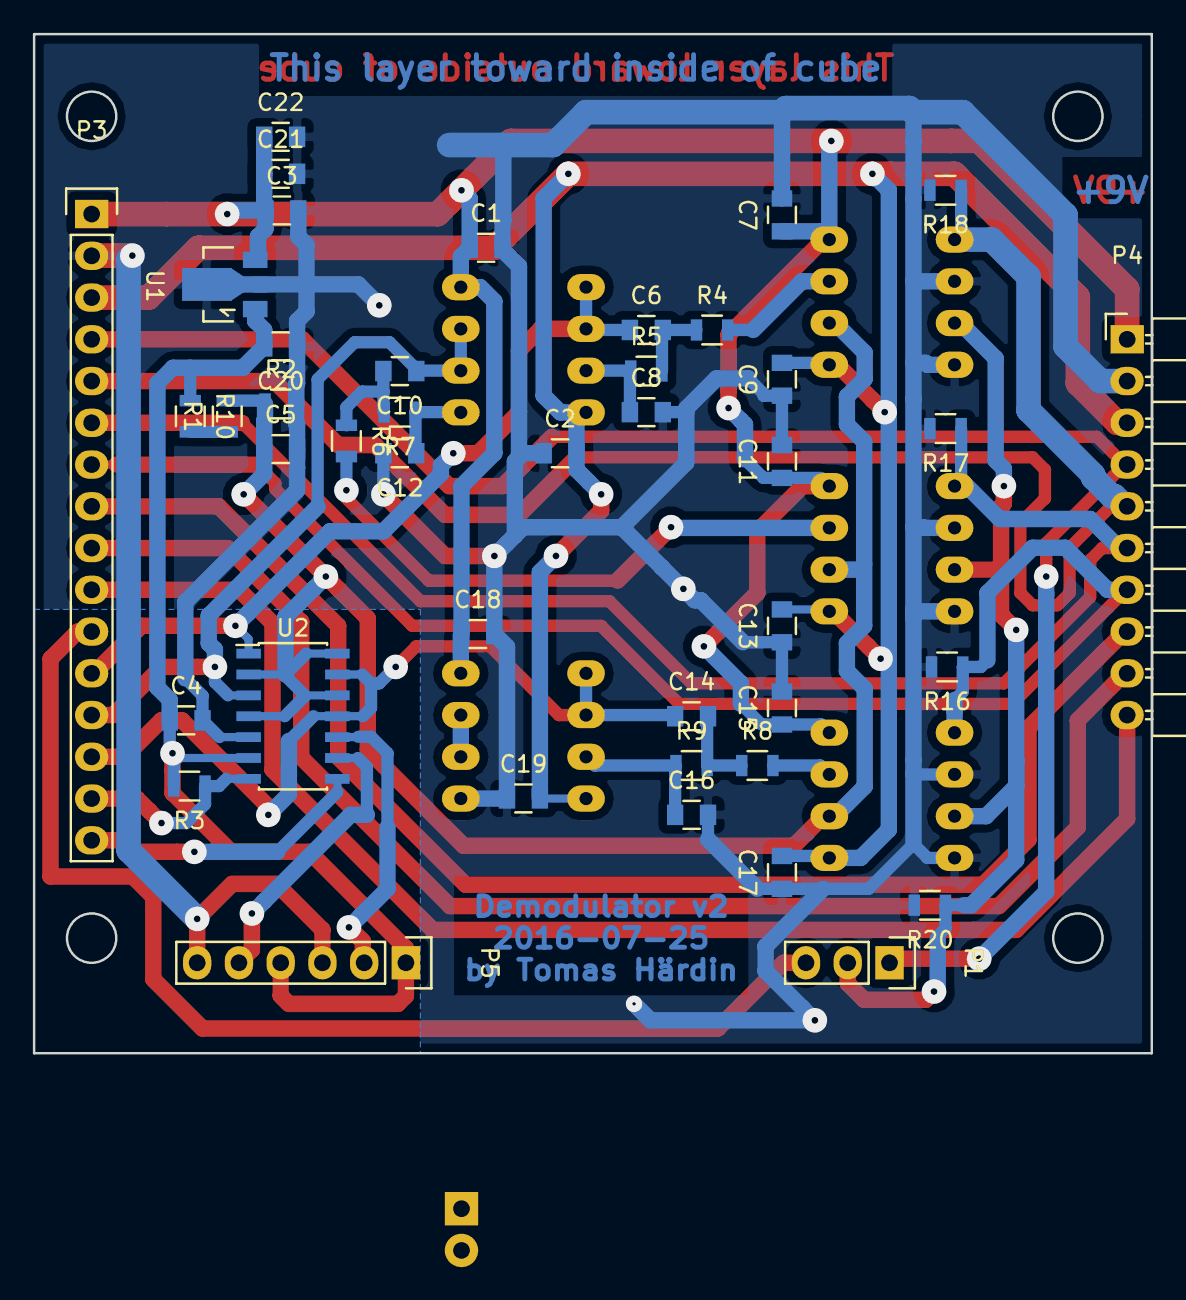
[picture p39: board demodulator.kicad_pcb from below]

Board: 2 copper layers, 68.0 x 62.0 mm, 54 parts (42 on the bottom side), 35 nets.

Parts:
C1, C2, C3, C4, C5, C7, C9, C11, C13, C15, C17, C18, C19, C20, C21, C22: 100n; C_0805
C6, C8, C10, C12, C14, C16: 1u; C_0805
P1: CONN_01X03; Pin_Header_Straight_1x03
P2: ZERO BIAS; Pin_Header_Straight_1x02
P3: CONN_01X16; Pin_Header_Straight_1x16
P4: CONN_01X10; Pin_Header_Angled_1x10
P5: Adr conf; Pin_Header_Straight_1x06
R1, R2, R3, R10, R14, R15, R19: 10k; R_0805
R4, R5, R6, R7, R8, R9, R11, R12, R13, R16, R17, R18, R20: 100k; R_0805
U1: L78L33; SOT89-3_Housing
U2: MCP3428; SOIC-14_3.9x8.7mm_Pitch1.27mm
U3, U5, U6: AD633; DIP-8_W7.62mm_LongPads
U4, U7: LM6172; DIP-8_W7.62mm_LongPads

Connections:
+3.3VADC: C4.1, C20.2, P5.1, P5.4, R3.2, R10.1, U1.1, U2.6
+9V: C1.1, C3.1, C7.1, C11.1, C15.1, C18.1, C21.1, C22.1, P3.1, P4.1, U1.3, U3.8, U4.8, U5.8, U6.8, U7.8
-9VA: C2.2, C9.2, C13.2, C17.2, C19.2, P3.3, P4.3, U3.5, U4.4, U5.5, U6.5, U7.4
/A0: P3.8, P4.8
/A1: P3.9, P4.9
/LO: P1.3, P3.11
/REF: P3.10, P4.10
/SCL: P3.16, U2.8
/SDA: P3.15, R3.1, U2.7
/TACH: P1.1, P3.4, P4.4
/channel1/BIAS: C5.1, P2.1, R1.2, R2.1, U2.2, U2.4, U2.12, U2.14, U3.6, U5.6, U6.6, U7.5
/channel1/DEMOD: C6.1, P3.12, R12.1, U4.1, U4.2
/channel1/X: P3.5, P4.5, R18.1, U3.1
/channel1/Y: P1.2, R20.1, U3.3, U5.3, U6.3
/channel2/DEMOD: C10.1, P3.13, R11.1, U4.6, U4.7
/channel2/X: P3.6, P4.6, R17.1, U5.1
/channel3/DEMOD: C14.1, P3.14, R13.2, U7.1, U7.2
/channel3/X: P3.7, P4.7, R16.1, U6.1
GND: C1.2, C2.1, C3.2, C4.2, C5.2, C7.2, C8.2, C9.1, C11.2, C12.2, C13.1, C15.2, C16.2, C17.1, C18.2, C19.1, C20.1, C21.2, C22.2, P2.2, P3.2, P4.2, P5.3, P5.6, R2.2, R16.2, R17.2, R18.2, R20.2, U1.2, U2.5, U3.2, U3.4, U5.2, U5.4, U6.2, U6.4
unnamed: C6.2, R4.1, R5.2
unnamed: C8.1, R5.1, U4.3
unnamed: C10.2, R6.1, R7.2
unnamed: C12.1, R7.1, U4.5
unnamed: C14.2, R8.1, R9.2
unnamed: C16.1, R9.1, U7.3
unnamed: P5.2, U2.10
unnamed: P5.5, U2.9
unnamed: R1.1, R10.2
unnamed: R4.2, U3.7
unnamed: R6.2, U5.7
unnamed: R8.2, U6.7
unnamed: R11.2, R19.2, U2.3
unnamed: R12.2, R14.2, U2.1
unnamed: R13.1, R15.1, U2.11, U2.13
unnamed: R14.1, R15.2, R19.1, U7.6, U7.7
