SpaceScienceSweden/ulv_electronics/fieldmill5/fieldmill5.kicad_pcb

## KiCad design fieldmill5/fieldmill5.kicad_pcb (2016-07-20)

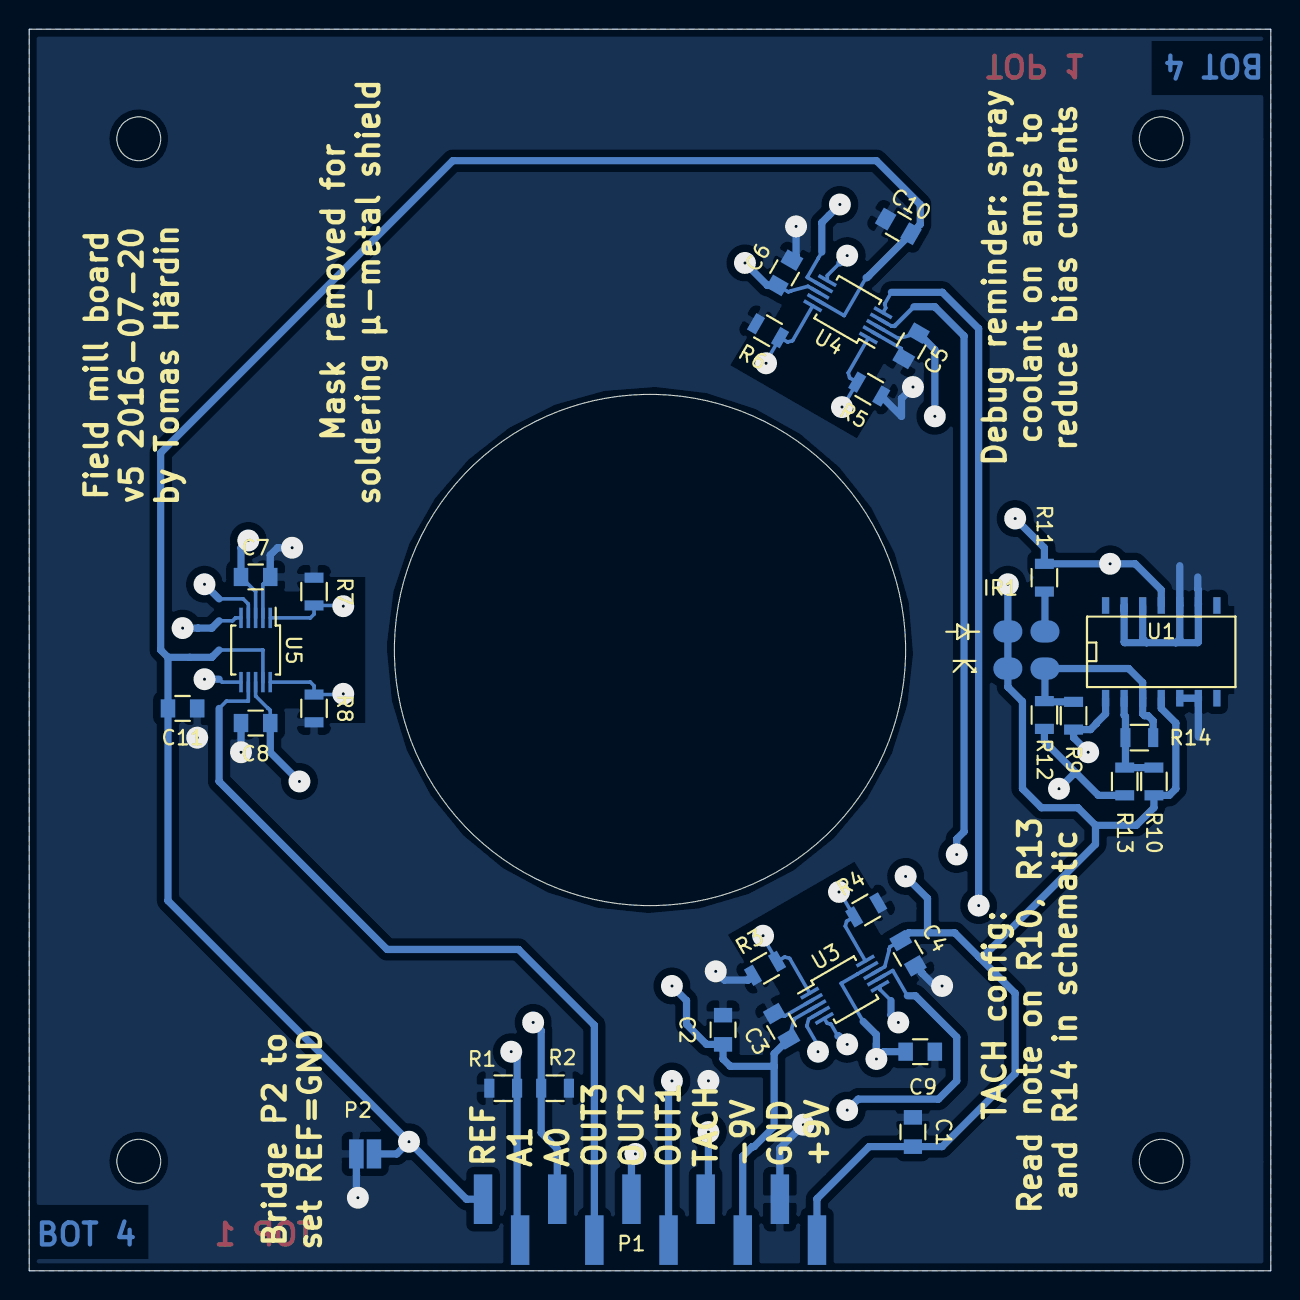
[picture p40: board fieldmill5.kicad_pcb from below]

Board: 4 copper layers, 85.0 x 85.0 mm, 32 parts (32 on the bottom side), 19 nets.

Parts:
C1, C2: 10u; C_0805
C3, C4, C5, C6, C7, C8, C9, C10, C11: 100n; C_0805
IR1: ITR20001; ITR20001-smd
P1: CONN_01X10; SMD_pinheader_1x10
P2: CONN_01X02; solder_bridge
R1, R2, R11: 10k; R_0805
R3, R4, R5, R6, R7, R8: 10M; R_0805
R9, R14: 1M; R_0805
R10, R12, R13: 100k; R_0805
U1: LM324; SOIC-14_N
U3, U4, U5: AD8253; MSOP-10_3x3mm_Pitch0.5mm_thinpads

Connections:
+9V: C1.2, C4.1, C6.1, C8.1, IR1.A, IR1.C, P1.1, R10.1, U1.4, U3.8, U4.8, U5.8
-9VA: C2.2, C3.2, C5.2, C7.2, P1.3, R11.2, R12.2, R13.2, U1.11, U3.3, U3.6, U4.3, U4.6, U5.3, U5.6
/TACH: P1.4, R9.2, U1.1
/channel1/A0: P1.8, R2.1, U3.4, U4.4, U5.4
/channel1/A1: P1.9, R1.1, U3.5, U4.5, U5.5
/channel1/OUT: P1.5, U3.7
/channel1/REF: C9.1, C10.1, C11.1, P1.10, P2.2, U3.9, U4.9, U5.9
/channel1/SENSORN: R3.2, U3.1
/channel1/SENSORP: R4.1, U3.10
/channel2/OUT: P1.6, U4.7
/channel2/SENSORN: R5.2, U4.1
/channel2/SENSORP: R6.1, U4.10
/channel3/OUT: P1.7, U5.7
/channel3/SENSORN: R7.2, U5.1
/channel3/SENSORP: R8.1, U5.10
GND: C1.1, C2.1, C3.1, C4.2, C5.1, C6.2, C7.1, C8.2, C9.2, C10.2, C11.2, P1.2, P2.1, R1.2, R2.2, R3.1, R4.2, R5.1, R6.2, R7.1, R8.2, U1.5, U1.6, U1.9, U1.10, U1.12, U1.13, U3.2, U4.2, U5.2
unnamed: IR1.E, R9.1, R12.1, R14.1, U1.3
unnamed: IR1.K, R11.1
unnamed: R10.2, R13.1, R14.2, U1.2
