SpaceScienceSweden/ulv_electronics/fieldmill3/fieldmill3.kicad_pcb

## KiCad design fieldmill3/fieldmill3.kicad_pcb (2016-07-14)

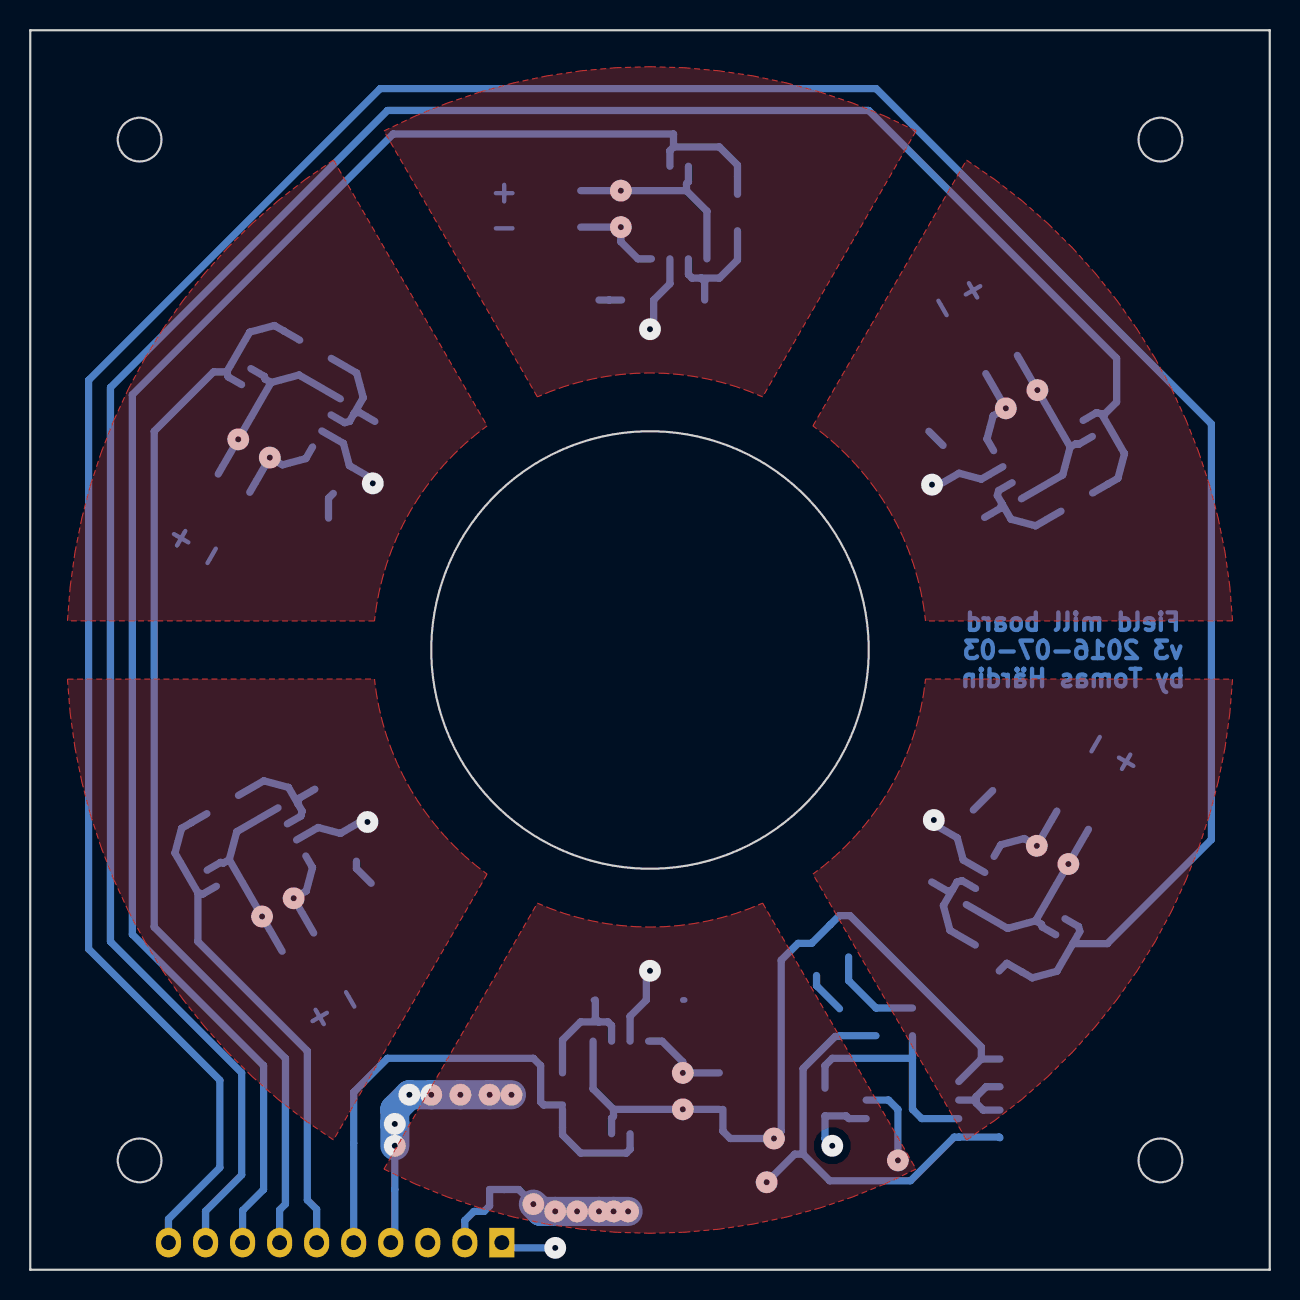
[picture p41: board fieldmill3.kicad_pcb from above]

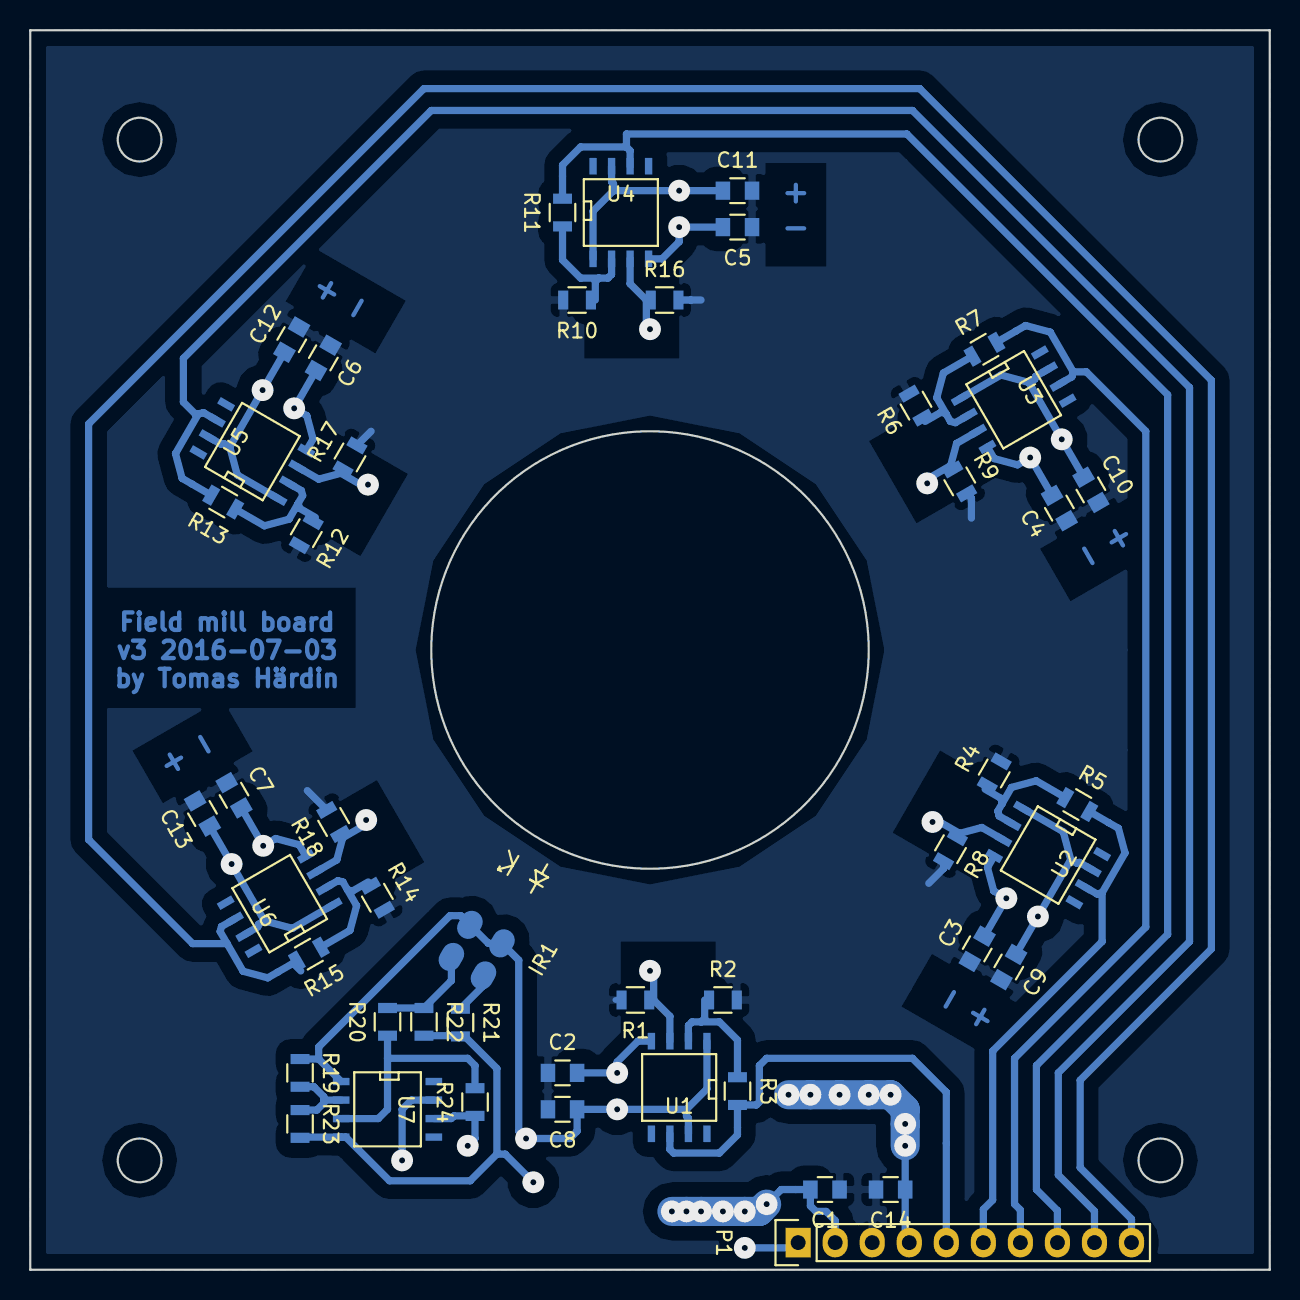
[picture p42: board fieldmill3.kicad_pcb from below]

Board: 4 copper layers, 85.0 x 85.0 mm, 47 parts (47 on the bottom side), 26 nets.

Parts:
C1, C14: 10u; C_0805
C2, C3, C4, C5, C6, C7, C8, C9, C10, C11, C12, C13: 100n; C_0805
IR1: ITR20001; ITR20001-smd
P1: CONN_01X10; Pin_Header_Straight_1x10
R1, R8, R9, R16, R17, R18: 10M; R_0805
R2, R4, R6, R10, R12, R14: 10k; R_0805
R3, R5, R7, R11, R13, R15, R19, R20, R22, R23: 100k; R_0805
R21: 2k2; R_0805
R24: 1M; R_0805
U1, U2, U3, U4, U5, U6, U7: MAX4238; SOIC-8-N

Connections:
/GRD1: R2.1, R3.1, U1.2
/GRD2: R4.1, R5.1, U2.2
/GRD3: R6.1, R7.1, U3.2
/GRD4: R10.1, R11.1, U4.2
/GRD5: R12.1, R13.1, U5.2
/GRD6: R14.1, R15.1, U6.2
/SENSOR1: R1.1, U1.3
/SENSOR2: R8.1, U2.3
/SENSOR3: R9.1, U3.3
/SENSOR4: R16.1, U4.3
/SENSOR5: R17.1, U5.3
/SENSOR6: R18.1, U6.3
GND: C1.1, C2.1, C3.1, C4.1, C5.1, C6.1, C7.1, C8.2, C9.2, C10.2, C11.2, C12.2, C13.2, C14.2, P1.3, R1.2, R2.2, R4.2, R6.2, R8.2, R9.2, R10.2, R12.2, R14.2, R16.2, R17.2, R18.2
unnamed: IR1.E, R20.2, R22.1
unnamed: IR1.K, R21.1
unnamed: P1.1, R24.1, U7.6
unnamed: P1.5, R3.2, U1.6
unnamed: P1.6, R5.2, U2.6
unnamed: P1.7, R7.2, U3.6
unnamed: P1.8, R11.2, U4.6
unnamed: P1.9, R13.2, U5.6
unnamed: P1.10, R15.2, U6.6
unnamed: R19.2, R23.1, U7.2
unnamed: R20.1, R24.2, U7.3
VDD: C1.2, C8.1, C9.1, C10.1, C11.1, C12.1, C13.1, IR1.A, IR1.C, P1.2, R19.1, U1.1, U1.7, U2.1, U2.7, U3.1, U3.7, U4.1, U4.7, U5.1, U5.7, U6.1, U6.7, U7.1, U7.7
VSS: C2.2, C3.2, C4.2, C5.2, C6.2, C7.2, C14.1, P1.4, R21.2, R22.2, R23.2, U1.4, U2.4, U3.4, U4.4, U5.4, U6.4, U7.4
