SpaceScienceSweden/ulv_electronics/UmeaLunarVenture3/UmeaLunarVenture3.kicad_pcb

## KiCad design UmeaLunarVenture3/UmeaLunarVenture3.kicad_pcb (2016-07-06)

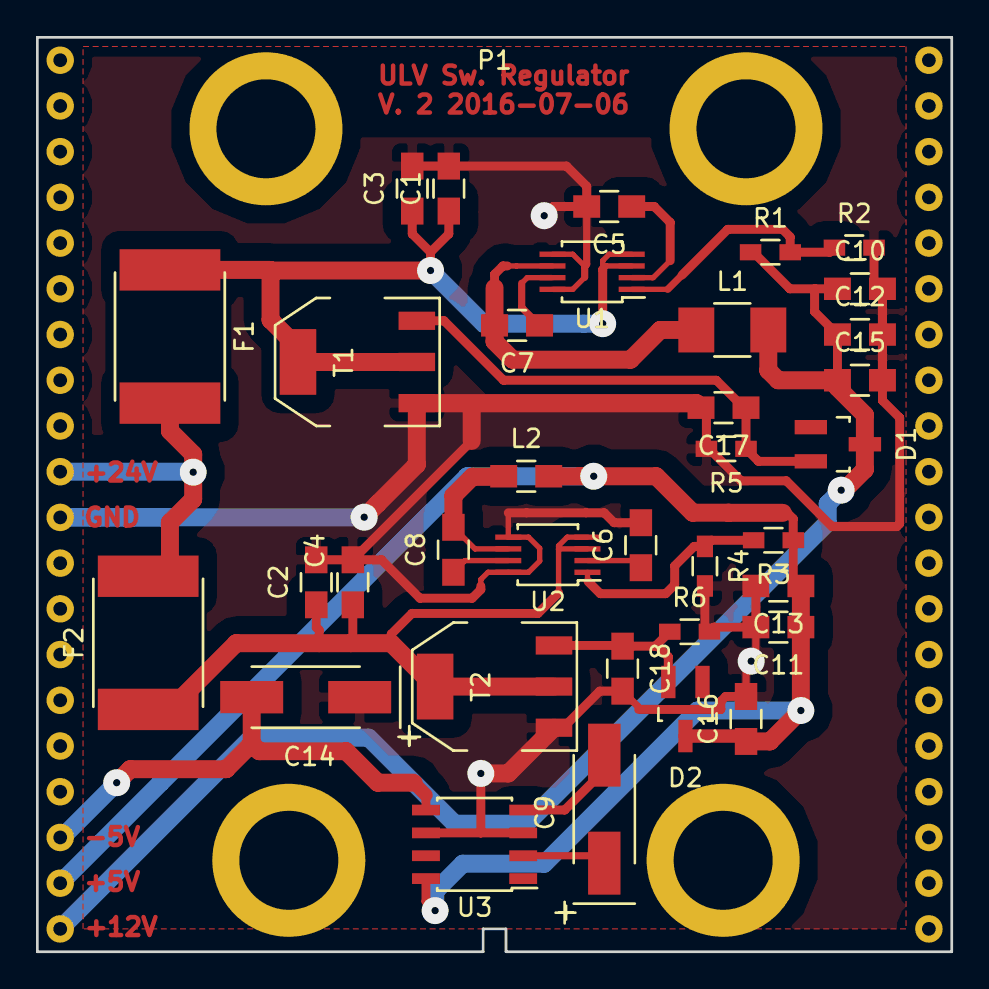
[picture p43: board UmeaLunarVenture3.kicad_pcb from above]

Board: 2 copper layers, 50.8 x 50.8 mm, 36 parts (0 on the bottom side), 19 nets.

Parts:
C1, C2, C3, C4, C10, C11, C12, C13: 10 uF; C_0805_HandSoldering
C5, C6: 1 uF; C_0805_HandSoldering
C7, C8, C15, C16: 100 nF; C_0805_HandSoldering
C9, C14: 150 uF; TantalC_SizeC_EIA-6032_HandSoldering
C17, C18: 47 nF; C_0805_HandSoldering
D1: ZD +15V; SOT-23_Handsoldering-Swapped_Pads
D2: ZD +5.6V; SOT-23_Handsoldering-Swapped_Pads
F1, F2: Fuse 1.5A; Fuse_SMD2920
L1: 56 uH; C_1210_HandSoldering
L2: 22 uH; C_0805_HandSoldering
P1: SCUBE40; scube40
R1: 140 kOhm; R_0603_HandSoldering
R2, R4: 10 kOhm; R_0603_HandSoldering
R3: 52.3 kOhm; R_0603_HandSoldering
R5, R6: 1k Ohm; R_0603_HandSoldering
T1, T2: T; SOT-223-KAG
U1, U2: MCP16311/2; MSOP-8_3x3mm_Pitch0.65mm_thinpads
U3: MAX660; SOIC-8_3.9x4.9mm_Pitch1.27mm

Connections:
GND: C1.2, C2.2, C3.2, C4.2, C5.2, C6.2, C10.2, C11.2, C12.2, C13.2, C14.1, C15.2, C16.2, C17.2, C18.2, P1.11, R2.2, R4.2, R5.2, R6.2, T1.K, T2.K, U1.5, U1.8, U2.5, U2.8, U3.3, U3.6
unnamed: C1.1, C3.1, F1.1, T1.A, U1.3, U1.4
unnamed: C2.1, C4.1, F2.1, T2.A, U2.3, U2.4
unnamed: C5.1, U1.2
unnamed: C6.1, U2.2
unnamed: C7.1, U1.7
unnamed: C7.2, L1.1, U1.6
unnamed: C8.1, U2.7
unnamed: C8.2, L2.1, U2.6
unnamed: C9.1, U3.2
unnamed: C9.2, U3.4
unnamed: C10.1, C12.1, C15.1, D1.1, L1.2, P1.20, R1.1
unnamed: C11.1, C13.1, C16.1, D2.1, L2.2, P1.19, R3.1, U3.8
unnamed: C14.2, P1.18, U3.5
unnamed: C17.1, D1.2, R5.1, T1.G
unnamed: C18.1, D2.2, R6.1, T2.G
unnamed: F1.2, F2.2, P1.10
unnamed: R1.2, R2.1, U1.1
unnamed: R3.2, R4.1, U2.1
