SpaceScienceSweden/ulv_electronics/fieldmill1/ulv_fieldmill.kicad_pcb

## KiCad design fieldmill1/ulv_fieldmill.kicad_pcb (2016-06-21)

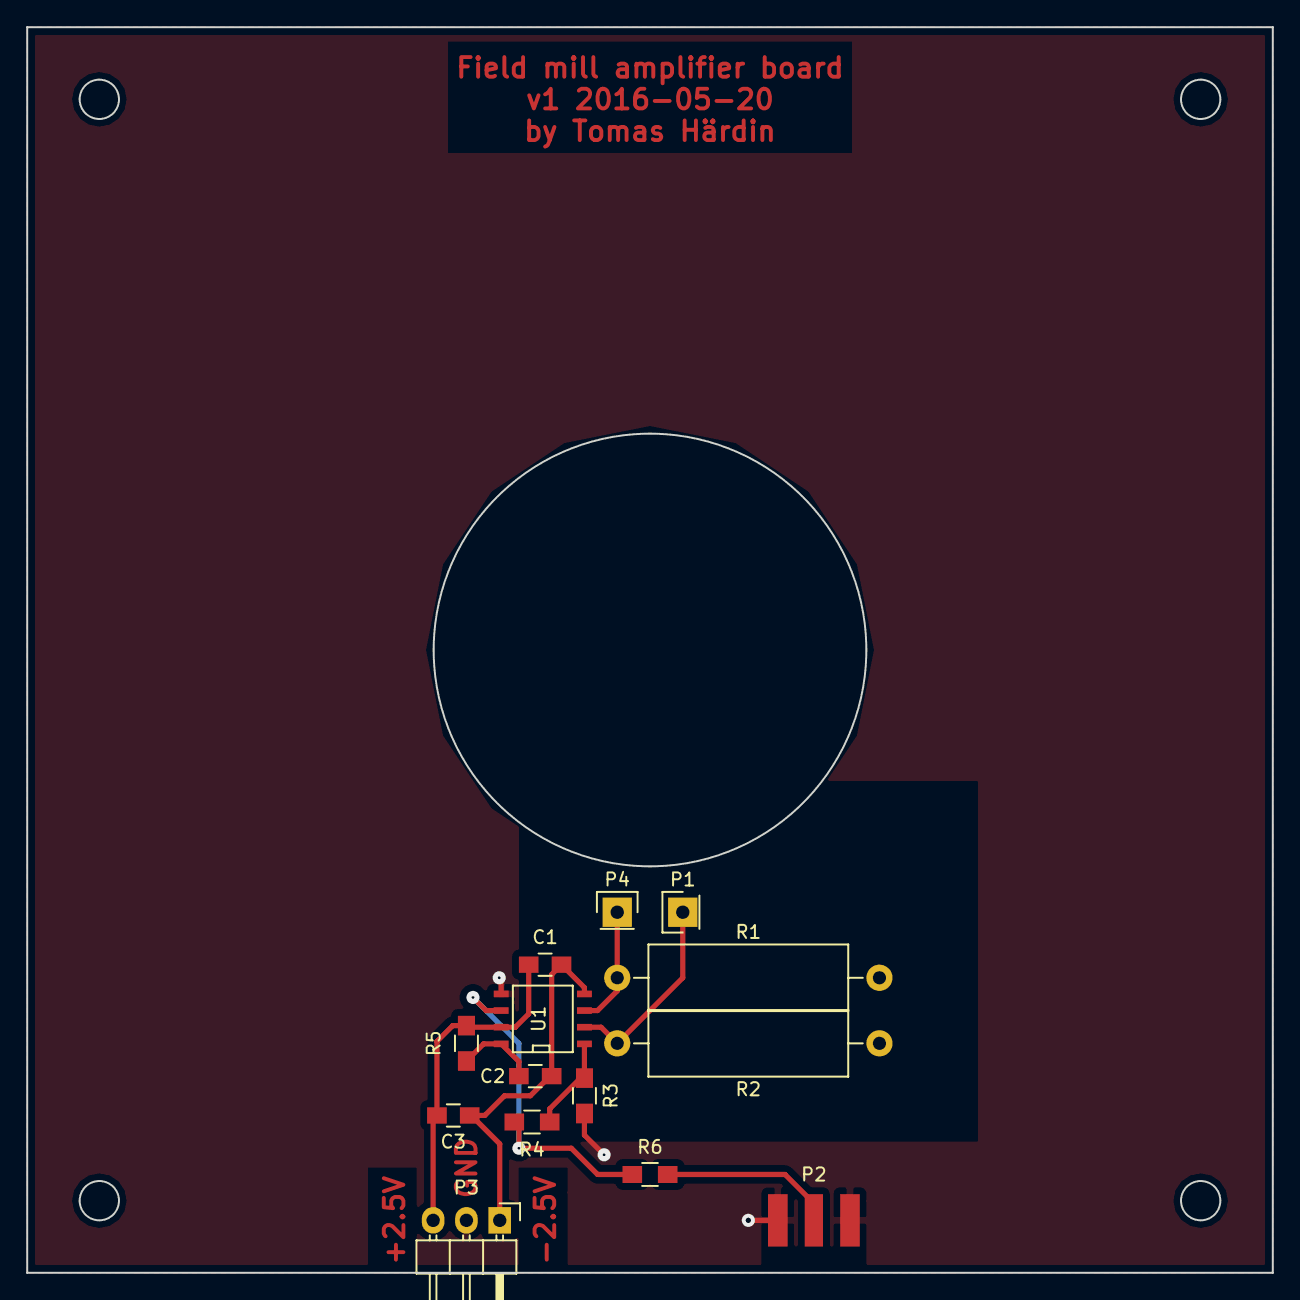
[picture p44: board fieldmill1/ulv_fieldmill.kicad_pcb from above]

Board: 2 copper layers, 95.0 x 95.0 mm, 14 parts (0 on the bottom side), 9 nets.

Parts:
C1, C2: 100n; C_0805_HandSoldering
C3: 1u; C_0805_HandSoldering
P1, P4: CONN_01X01; Pin_Header_Straight_1x01
P2: SMA; SMA-edge
P3: CONN_01X03; Pin_Header_Angled_1x03
R1, R2: 1M; Resistor_Horizontal_RM20mm
R3, R6: 1k; R_0805_HandSoldering
R4, R5: 100k; R_0805_HandSoldering
U1: MCP6N11; SOIC-8-N

Connections:
GND: P2.2, P3.2, R1.1, R2.1, R3.1, U1.5
unnamed: C2.1, R5.2, U1.8
unnamed: P1.1, R2.2, U1.2
unnamed: P2.1, R6.2
unnamed: P4.1, R1.2, U1.3
unnamed: R3.2, R4.1, U1.1
unnamed: R4.2, R6.1, U1.6
VDD: C1.1, C3.1, P3.3, R5.1, U1.7
VSS: C1.2, C2.2, C3.2, P3.1, U1.4
