SpaceScienceSweden/ulv_electronics/fieldmill2/ulv_fieldmill.kicad_pcb

## KiCad design fieldmill2/ulv_fieldmill.kicad_pcb (2016-06-18)

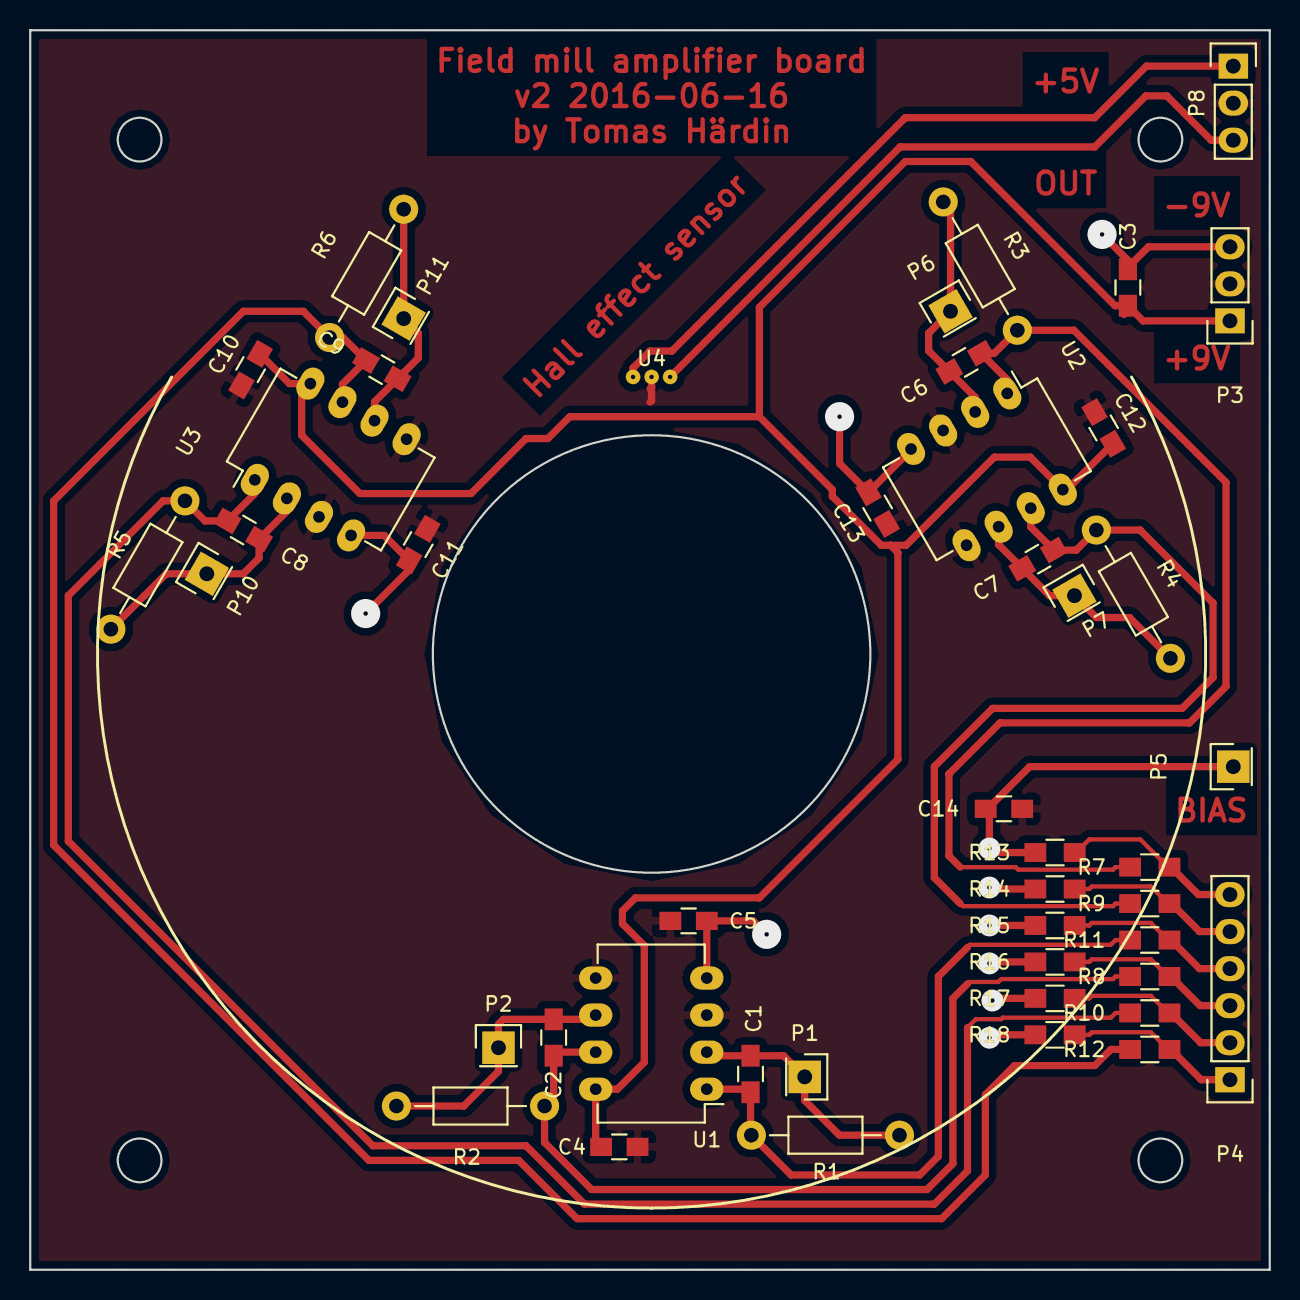
[picture p45: board fieldmill2/ulv_fieldmill.kicad_pcb from above]

Board: 4 copper layers, 85.0 x 85.0 mm, 46 parts (0 on the bottom side), 24 nets.

Parts:
C1, C2, C6, C7, C8, C9: 1p; C_0805_HandSoldering
C3, C14: 1u; C_0805_HandSoldering
C4, C5, C10, C11, C12, C13: 100n; C_0805_HandSoldering
P1, P2, P5, P6, P7, P10, P11: CONN_01X01; Pin_Header_Straight_1x01
P3, P8: CONN_01X03; Pin_Header_Straight_1x03
P4: CONN_01X06; Pin_Header_Straight_1x06
R1, R2, R3, R4, R5, R6: 100M; Resistor_Horizontal_RM10mm
R7, R8, R9, R10, R11, R12, R13, R14, R15, R16, R17, R18: 10k; R_0805_HandSoldering
U1, U2, U3: OPA2604; DIP-8_W7.62mm_LongPads
U4: A3506LU; 3x50mil

Connections:
+5V: P8.1, U4.1
+9VA: C3.2, C4.2, C10.2, C12.2, P3.1, U1.8, U2.8, U3.8
-9VA: C3.1, C5.1, C11.1, C13.1, P3.3, U1.4, U2.4, U3.4
GND: C4.1, C5.2, C10.1, C11.2, C12.1, C13.2, C14.1, P3.2, P8.2, U1.3, U1.5, U2.3, U2.5, U3.3, U3.5, U4.2
unnamed: C1.1, R1.1, R11.2, U1.1
unnamed: C1.2, P1.1, R1.2, U1.2
unnamed: C2.1, R2.1, R8.2, U1.7
unnamed: C2.2, P2.1, R2.2, U1.6
unnamed: C6.1, R3.1, R7.2, U2.1
unnamed: C6.2, P6.1, R3.2, U2.2
unnamed: C7.1, R4.1, R9.2, U2.7
unnamed: C7.2, P7.1, R4.2, U2.6
unnamed: C8.1, R5.1, R10.2, U3.1
unnamed: C8.2, P10.1, R5.2, U3.2
unnamed: C9.1, R6.1, R12.2, U3.7
unnamed: C9.2, P11.1, R6.2, U3.6
unnamed: C14.2, P5.1, R13.2, R14.2, R15.2, R16.2, R17.2, R18.2
unnamed: P4.1, R12.1, R18.1
unnamed: P4.2, R10.1, R17.1
unnamed: P4.3, R8.1, R16.1
unnamed: P4.4, R11.1, R15.1
unnamed: P4.5, R9.1, R14.1
unnamed: P4.6, R7.1, R13.1
unnamed: P8.3, U4.3
