SpaceScienceSweden/ulv_electronics/code/app/feature_programs.c

//each program consists of a number of lines
//each line is NUL terminated
char program_store[4096];

struct {
  char name[16];      //"" = free slot
  char *start, *end;  //pointers into program_store
} programs[16];
static const int max_programs = sizeof(programs)/sizeof(programs[0]);

static size_t free_program_space(void) {
  if (programs[0].name[0] == 0) {
    return sizeof(program_store);
  }
  uint8_t x;
  for (x = 0; x < max_programs - 1 && programs[x+1].name[0]; x++);
  return &program_store[sizeof(program_store)] - programs[x].end;
}

static void list_programs(void) {
  start_section("PROGRAMS");
  uint8_t x;
  for (x = 0; x < max_programs; x++) {
    if (!programs[x].name[0]) {
      break;
    }
    printf_P(PSTR("%i: %s\r\n"), (int)x, programs[x].name);
    char *ptr = programs[x].start;
    while (ptr < programs[x].end) {
      size_t sz = strlen(ptr)+1;
      printf_P(PSTR("%s\r\n"), ptr);
      ptr += sz;
      wdt_reset();
    }
    printf_P(PSTR("\r\n"));
  }
  printf_P(PSTR("%i/%i programs (%u B free)\r\n"), (int)x, max_programs, free_program_space());
}

static void delete_program_slot(uint8_t x) {
  uint16_t sz = programs[x].end - programs[x].start;
  memmove(programs[x].start, programs[x].end, &program_store[sizeof(program_store)] - programs[x].end);
  memmove(&programs[x], &programs[x+1], (max_programs-x-1)*sizeof(programs[0]));

  for (; x < max_programs; x++) {
    programs[x].start -= sz;
    programs[x].end -= sz;
  }

  //last slot is always free
  programs[max_programs-1].name[0] = 0;
}

static char delete_program(const char *name) {
  //delete program if we can find it
  //then memmove() program data and pointers around
  uint8_t x;
  for (x = 0; x < max_programs; x++) {
    if (!strcmp(programs[x].name, name)) {
      delete_program_slot(x);
      return 0;
    }
  }
  //no such program found
  return -1;
}

static char add_program(const char *name) {
  size_t l = strlen(name);
  if (l <= 0 || l > 15) {
    return -1;
  }
  //find a free spot
  for (uint8_t x = 0; x < max_programs; x++) {
    if (programs[x].name[0] == 0) {
      strcpy(programs[x].name, name);
      if (x == 0) {
        programs[x].end = programs[x].start = program_store;
      } else {
        programs[x].end = programs[x].start = programs[x-1].end;
      }
      return x;
    }
  }
  return -2;
}

//adds line to last program
static char add_program_line(const char *line) {
  //include NUL in size
  size_t sz = strlen(line) + 1;
  uint8_t x;
  for (x = 0; x < max_programs - 1 && programs[x+1].name[0]; x++);

  //how much space have we got?
  size_t maxsz = &program_store[sizeof(program_store)] - programs[x].end;

  if (sz > maxsz) {
    return -1;
  }

  memcpy(programs[x].end, line, sz);
  programs[x].end += sz;

  return 0;
}
