SpaceScienceSweden/ulv_electronics/(commit log)

2016-03-09 Initial commit, inspired by LibreCube's pin assignment
    [PC104_connector.sch]
2016-03-09 Add project file and board
    [PC104_connector.kicad_pcb]
2016-03-09 There, now everything should be in order
    [PC104_connector.kicad_pcb]
2016-03-11 Switch to 4 layers, 0.204 mm min trace width due to inner layers
    [PC104_connector.kicad_pcb, PC104_connector.sch]
2016-03-13 Redesign symbol, schematic, and pin numbering
    [PC104_connector.kicad_pcb, PC104_connector.sch]
2016-03-13 Move PC edge cuts to connector footprint
    This way we'll be able to modify the edge cuts and all boards
    will be automatically updated
    [PC104_connector.kicad_pcb]
2016-03-13 Rename module template to "template"
    [template.kicad_pcb, template.sch]
2016-03-13 Add BOM field names for future reference
2016-03-13 Add Bourns footprint (SDE0805A Series)
2016-03-13 Change name of VBAT5..8 to PV1..4
    This because we need connectors for the batteries too.
    These may end up being collapsed to a single pin via diodes due to the need for deployment switches.
2016-03-13 Add 2p jst connector
2016-03-13 Add initial battery board
    [ulv_battery.kicad_pcb, ulv_battery.sch]
2016-03-13 Add 3d cad files for JST contacts
2016-03-13 Improve battery circuit
    * connect to vsys via schottky diodes
    * add solder pads for deployment switch
    [battery_circuit.sch, ulv_battery.kicad_pcb, ulv_battery.sch]
2016-03-14 Very rough sketch
    [chargerchannel.sch, ulv_power.kicad_pcb, ulv_power.sch]
2016-03-14 Add connectors and deployment switch for solar cells
    The deployment switch is on the negative side of the cells since we need the raw voltage for the charge controllers (for now).
    [battery_circuit.sch, solar_circuit.sch, ulv_battery.sch]
2016-03-14 Add NTC stuff, mark VOC logic as TODO
    In short, it might be possible to have a circuit that figures out what VOC *should* be, based on a small light sensor.
    [chargerchannel.sch, ulv_power.sch]
2016-03-14 Route new components on battery board
    still trying to keep it to only two layers to make it more
    hack friendly
    [ulv_battery.kicad_pcb]
2016-03-14 Update battery submodule
2016-03-14 Clean up hierarchical pin directions
    [battery_circuit.sch, solar_circuit.sch, ulv_battery.kicad_pcb, ulv_battery.sch]
2016-03-15 Duplicate chargerchannel to four copies, hook everything up to pc104
    PCB is TODO
    [chargerchannel.sch, ulv_power.sch]
2016-03-15 Switch to new PC104 connector, use bus to make schematic a bit prettier
    [battery_circuit.sch, solar_circuit.sch, ulv_battery.sch]
2016-03-29 Add PLLs, regulators and crystals
2016-03-29 Initial commit, based off of my old bpsk_modem.pro
    [ulv_cw_beacon.sch]
2016-03-29 Add PC104 connector, rework choke/balun section
    This gives another 0.3 dB output
    [ulv_cw_beacon.sch]
2016-04-06 Add XTC7005 footprint
2016-04-10 Add library for new board layout
2016-04-10 Use new board layout
    [battery_circuit.sch, solar_circuit.sch, ulv_battery.kicad_pcb, ulv_battery.sch]
2016-04-11 Move ulv_libraries to ulv_electronics/
    [ulv_battery.kicad_pcb]
2016-04-16 Add bq2970 protection
    BOM and assigning N-ch FET footprint is still TODO
    [battery_circuit.sch, solar_circuit.sch, ulv_battery.sch]
2016-04-17 Assign NMOS devices, BOM work
    [battery_circuit.sch, solar_circuit.sch]
2016-04-18 BOM close to done, maximum current per cell figured
    We could increase current capacity by picking FETs with lower Rds(on).
    For now we max out around 1 A when the batteries are full, down to 0.5 A full almost empty batteries with the system at 100°C
    [battery_circuit.sch, solar_circuit.sch]
2016-04-18 More BOM
2016-04-21 Add pin headers for jumpers or for tapping off current measurements, plus status LEDs
    [battery_circuit.sch, solar_circuit.sch, ulv_battery.sch]
2016-04-22 BOM LEDs
    [battery_circuit.sch, solar_circuit.sch, ulv_battery.sch]
2016-04-22 Re-layout board
    [ulv_battery.kicad_pcb]
2016-04-22 BOM everything, collapse some components to 47k and 4µ7
    [chargerchannel.sch, ulv_power.sch]
2016-04-24 Route board
    Had to move some components around, especially resistors that weren't place the same way for every battery circuit
    [ulv_battery.kicad_pcb]
2016-04-24 Fully routed and BOM'd battery board
2016-04-25 Mostly done routing
    [ulv_power.kicad_pcb]
2016-05-02 Update BOM
    [battery_circuit.sch, solar_circuit.sch, ulv_battery.kicad_pcb, ulv_battery.sch]
2016-05-02 Finish routing board
    I tried to keep the ground plane as unbroken as possible between the inductors and output filter caps
    [ulv_power.kicad_pcb]
2016-05-02 Finish routing charger board
2016-05-05 Fix routing and silk screen label placements
    [battery_circuit.sch, solar_circuit.sch, ulv_battery.kicad_pcb, ulv_battery.sch]
2016-05-05 Swap some pins on the connector
2016-05-11 Re-generate pcb nets from schematic
    [ulv_battery.kicad_pcb]
2016-05-11 Enthicken traces under power MOSFETs
    [ulv_battery.kicad_pcb]
2016-05-11 Updated battery board with fab house feedback
2016-05-11 Add Analog Devices library with ADA4530-1
2016-05-14 Fix copper connecting to drill holes, add information to silkscreen
    This is a release candidate for version 1 of this board
    TODO: make drill holes = GND? should simplify future boards too
    [ulv_battery.kicad_pcb]
2016-05-20 Field mill buffer board
    [ulv_fieldmill.kicad_pcb, ulv_fieldmill.sch]
2016-05-20 Moved SMA connector a bit
    [ulv_fieldmill.kicad_pcb]
2016-05-20 Add 1k to output to prevent capacitive from messing up the output
    Reduce the supply decoupling cap to 1u as well.
    [ulv_fieldmill.kicad_pcb, ulv_fieldmill.sch]
2016-05-20 Expand vias, reduce drill
    [ulv_fieldmill.kicad_pcb]
2016-06-13 ulv_fieldmill: Update resistors to match reality (1M)
    [ulv_fieldmill.kicad_pcb, ulv_fieldmill.sch]
2016-06-14 mv ulv_fieldmill fieldmill
    [ulv_fieldmill.kicad_pcb, ulv_fieldmill.sch]
2016-06-14 Add SCUBE40 footprint
2016-06-14 Add very simple linear regulator board
    [regboard.kicad_pcb, regboard.sch]
2016-06-14 New field mill board based around OPA2604
    [ulv_fieldmill.kicad_pcb, ulv_fieldmill.sch]
2016-06-15 Make it so that we have six separate channels
    +9V is distributed with air wires, simulated with an internal copper layer.
    The bottom layer needs to be as unbroken as possible, which is at odds with using through-hole components
    [ulv_fieldmill.kicad_pcb, ulv_fieldmill.sch]
2016-06-15 Add output level shifting resistors
    These can be driven by an ADC to place signals in the appropriate range based on PGA setting
    [ulv_fieldmill.kicad_pcb, ulv_fieldmill.sch]
2016-06-16 Add symbol + footprint for A3506LU
2016-06-16 Version 2, including hall effect sensor
    [ulv_fieldmill.kicad_pcb, ulv_fieldmill.sch]
2016-06-16 Re-route board..
    New field mill board is 85x85 mm with 70 mm hole spacing and 30 mm center hole.
    [ulv_fieldmill.kicad_pcb]
2016-06-21 Modify field mill schematic to reflec reality
    Some passives have different values due to what was available
    [ulv_fieldmill.sch]
2016-06-21 Add field mill from commit ab8c727 as fieldmill1/ and rename current mill fieldmill2/
    [ulv_fieldmill.kicad_pcb, ulv_fieldmill.sch]
2016-06-21 Patch fieldmill1 to work with changed library structure
    [ulv_fieldmill.kicad_pcb]
2016-06-21 Empty project..
    [fieldmill3.kicad_pcb, fieldmill3.sch]
2016-06-21 Four-layer card with sensors in top layer, ICs in bottom and internal ground plane
    [fieldmill3.kicad_pcb, fieldmill3.sch]
2016-06-21 Getting somewhere
    [fieldmill3.kicad_pcb]
2016-06-29 Add some components and footprints
2016-06-29 Turns out we need to do high-impedance measurement after all
    This is the mostly laid out third version of the board.
    [fieldmill3.kicad_pcb, fieldmill3.sch]
2016-07-02 Add date and such
    [fieldmill3.kicad_pcb]
2016-07-02 cp fieldmill3 fieldmill4
    [fieldmill4.kicad_pcb, fieldmill4.sch]
2016-07-02 v4 of the field mill board
    Makes use of surface-mounting of components that are usually throughhole, to avoid having anything but sensors on the top layer.
    Some airwires are used.
    [fieldmill4.kicad_pcb, fieldmill4.sch]
2016-07-03 Add alignment targets as poor man's drill aids, make use of air wires in fieldmill3
    DRC thinks some things in fieldmill3 are not connected (C1 and C8) when they clearly are..
    [fieldmill3.kicad_pcb, fieldmill3.sch, fieldmill4.kicad_pcb]
2016-07-03 Fixed the DRC problem in fieldmill3
    [fieldmill3.kicad_pcb]
2016-07-05 Initial commit, added first prototype of circuit design
    [UmeaLunarVenture3.kicad_pcb, UmeaLunarVenture3.sch]
2016-07-05 Added footprints, connected C14 to ground in circuit
    [UmeaLunarVenture3.kicad_pcb, UmeaLunarVenture3.sch]
2016-07-05 Changed positions of vias, increased size of drill holes
    [UmeaLunarVenture3.kicad_pcb]
2016-07-05 Thicken GND trace from T1, add missing GND traces between pins 2-4 on T1 and T2
    [UmeaLunarVenture3.kicad_pcb]
2016-07-05 Make power traces as thick as possible without affecting the layout
    We can do better, but this is probably good enough for a prototype.
    [UmeaLunarVenture3.kicad_pcb]
2016-07-06 Added top/bottom layer of copper, added text
    [UmeaLunarVenture3.kicad_pcb]
2016-07-06 Fix issue of 0.25mm traces printing much thinner by setting the minimum width to 0.4mm and redrawing parts of the board
    [UmeaLunarVenture3.kicad_pcb]
2016-07-06 Adjust board to be easier to etch
    0.65mm pitch is no fun...
    [UmeaLunarVenture3.kicad_pcb, UmeaLunarVenture3.sch]
2016-07-09 Add footprint for ATmegaS128 and edge-mount AVR ISP connector
    For the S128 we assume that we can somehow bend the pins into normal L-shaped ones
2016-07-09 Add start of CPU card
    This is mostly to get a feel of how much size the packages take up.
    It should be compatible with both TQFP64 and CQFP64 variants.
    [cpu.kicad_pcb, cpu.sch]
2016-07-10 cp fieldmill4 fieldmill5
    [fieldmill5.kicad_pcb, fieldmill5.sch]
2016-07-11 Improved Eeschematic layout
    [UmeaLunarVenture3.sch]
2016-07-11 Removed backup voltage pins in scube40 component
2016-07-11 Start working on version 5
    Demodulator should be on separate board though
    [fieldmill5.kicad_pcb, fieldmill5.sch]
2016-07-13 rm regboard
    [regboard.kicad_pcb, regboard.sch]
2016-07-14 WIP on board that we probably won't use
    Added IR tachometer and such.
    [fieldmill3.kicad_pcb, fieldmill3.sch]
2016-07-16 Add some useful SMD footprints
2016-07-16 Add BOM for power board
    [Komponentlista 3.ods]
2016-07-16 fieldmill5 mostly done
    [channel.sch, fieldmill5.kicad_pcb, fieldmill5.sch]
2016-07-18 Add decoupling to REF inputs
    [channel.sch, fieldmill5.kicad_pcb, fieldmill5.sch]
2016-07-18 Add vias to ground plane
    [fieldmill5.kicad_pcb]
2016-07-18 Remove solder mask around center hole for shield solderability
    [fieldmill5.kicad_pcb]
2016-07-18 0.15 mm mask clearance, 0.1 mm minimum mask width
    [fieldmill5.kicad_pcb]
2016-07-18 Created ulv_esc for custom-made ESC circuit
    [ulv_esc.kicad_pcb, ulv_esc.sch]
2016-07-18 Move silkscreen figures for IR sensor away from exposed copper
    [fieldmill5.kicad_pcb]
2016-07-19 Add optional R14, such that we can replace the reference voltage on the TACH OP-amp with a low-pass filtered (average) version of the IR signal
    [fieldmill5.sch]
2016-07-20 Initial ESC circuit finished
    [ulv_esc.kicad_pcb, ulv_esc.sch]
2016-07-20 Improvements made to ESC circuit v.1
    [ulv_esc.kicad_pcb, ulv_esc.sch]
2016-07-20 Actually, /WR should be tied to VSS not (D)GND
    [channel.sch]
2016-07-20 More changes
    [channel.sch, fieldmill5.kicad_pcb, fieldmill5.sch]
2016-07-20 Change solder mask clearance to 62 µm
    Board house can do 50 µm, 75 µm is 'better'.
    Minimum mask bridge is 100 µm, the choice of 62 µm clearance makes the bridges in the MSOP gaps 126 µm.
    [fieldmill5.kicad_pcb]
2016-07-20 Add 'blind' vias on the six normal vias such that the drill files end up having an entry for them in every layer
    [fieldmill5.kicad_pcb]
2016-07-20 Change Edge.Cuts thicknesses to 1 µm per board house recommendations
    [fieldmill5.kicad_pcb]
2016-07-20 Replace blind vias that penetrate more than one layer with buried vias
    It's easier/cheaper for the fab house to just lay a bunch of buried vias
    [fieldmill5.kicad_pcb]
2016-07-20 Fix date
    [fieldmill5.kicad_pcb]
2016-07-20 Add layer labels in copper for even easier manufacture
    [fieldmill5.kicad_pcb]
2016-07-21 Added new power dist circuit
    [ulv_PowerDistributionCircuit4.kicad_pcb, ulv_PowerDistributionCircuit4.sch]
2016-07-22 Demodulator board
    [channel.sch, demodulator.kicad_pcb, demodulator.sch]
2016-07-22 Add final fieldmill5 gerbers and drill files
    [fieldmill5-B.Cu.gbl, fieldmill5-B.Mask.gbs, fieldmill5-B.SilkS.gbo, fieldmill5-Edge.Cuts.gm1, fieldmill5-F.Cu.gtl, fieldmill5-F.Mask.gts, fieldmill5-F.SilkS.gto, fieldmill5-inner1-inner2.drl]
2016-07-22 Expand via rings to 1.5 mm, for easier drilling
    [ulv_PowerDistributionCircuit4.kicad_pcb]
2016-07-24 Add +9V text to both layers, move some decoupling caps
    [demodulator.kicad_pcb]
2016-07-25 Replaced DC/DC footprints with 8-pin connectors
    [ulv_PowerDistributionCircuit4.kicad_pcb, ulv_PowerDistributionCircuit4.sch]
2016-07-25 Created new footprint for DC/DC converter, added to design
    [ulv_PowerDistributionCircuit4.kicad_pcb, ulv_PowerDistributionCircuit4.sch]
2016-07-25 Switch from OPA2604 to LM6172
    The pinouts are the same so I didn't bother making a new component, just changed the names of U4/U7.
    [channel.sch, demodulator.kicad_pcb, demodulator.sch]
2016-07-25 v2: Enthicken almost all traces to ease etching
    First attempt wasn't so successful.
    [demodulator.kicad_pcb]
2016-07-25 Add ground layers to reduce amount of etching needed, except under ADC
    This should hopefully keep switching noise from coupling capacitively to the rest of the circuit
    [demodulator.kicad_pcb]
2016-07-26 added voltage text
    [ulv_PowerDistributionCircuit4.kicad_pcb]
2016-07-26 Moved pin connections to 2nd layer in ESC
    [ulv_esc.kicad_pcb]
2016-07-27 Flipped components in power dist circuits
    [ulv_PowerDistributionCircuit4.kicad_pcb, ulv_esc.sch]
2016-07-28 Simplify BOM
    [channel.sch, demodulator.kicad_pcb, demodulator.sch]
2016-07-29 Expand vias to 1.5 mm, thin pads to 0.3 mm
    There's still an issue with 0.25 mm traces printing as <0.1 mm though.
    [ulv_esc.kicad_pcb]
2016-07-29 HACKHACK: Increase thicknesses from 0.25 mm to 0.26 mm to work around an apparent bug in KiCAD
    [ulv_esc.kicad_pcb]
2016-07-29 Added MOSFET to CTRL for 12V DC/DC
    [ulv_PowerDistributionCircuit4.kicad_pcb, ulv_PowerDistributionCircuit4.sch]
2016-08-01 Embiggen som traces, move text to silkscreen
    [ulv_esc.kicad_pcb]
2016-08-01 minor track changes
    [ulv_PowerDistributionCircuit4.kicad_pcb]
2016-08-01 Add PowerPad to DRV10983 footprint and symbol
2016-08-01 Add thermal vias, remove solder mask on bottom under ICs
    [ulv_esc.kicad_pcb, ulv_esc.sch]
2016-08-01 ulv_esc gerbers
    [ulv_esc.drl, ulv_esc.gbl, ulv_esc.gbo, ulv_esc.gbs, ulv_esc.gm1, ulv_esc.gtl, ulv_esc.gto, ulv_esc.gts]
2016-08-02 Add beginning of more compact demodulator, for the card stack
    [channel.sch, demodulator.kicad_pcb, demodulator.sch]
2016-08-02 Increase via diameter to 1.5 mm
    [ulv_PowerDistributionCircuit4.kicad_pcb]
2016-08-02 Make SOT23-5 pads slightly thinner
    [ulv_PowerDistributionCircuit4.kicad_pcb]
2016-08-02 Proof-of-concept software demodulator
    The real limitation seems to be the ADC
2016-08-03 Added meta data
    [ulv_PowerDistributionCircuit4.sch, ulv_esc.sch]
2016-08-05 Fix L78L33 symbol and update demodulator PCB
    Pin 3 in Vin and pin 1 is Vout, not the other way around (!)
    [demodulator.kicad_pcb]
2016-08-06 Updated demodulator that doesn't feed 8 V into the 3.3 V rail via ADC input diodes
    [channel.sch, demodulator.kicad_pcb, demodulator.sch]
2016-08-07 Connecting amplifier boards to CPU board, packing demodulator into 2x2 inch module
    [channel.sch, cpu.kicad_pcb, cpu.sch, demodulator.kicad_pcb, demodulator.sch]
2016-08-07 demodulator2: Thicken supply traces
    [demodulator.kicad_pcb]
2016-08-07 demodulator2: Redo BIAS circuit a bit, provide buffered BIAS to all places
    [channel.sch, demodulator.kicad_pcb, demodulator.sch]
2016-08-08 demodulator: Change schematic to reflect reality
    I had to do a bunch of hacks. The pcb hasn't changed, ans is unlikely to change until demodulator2 boards are ordered.
    [channel.sch, demodulator.sch]
2016-08-08 SCUBE40: Increase size of holes and annular rings
    Update all current designs to use it as well.
    [cpu.kicad_pcb, ulv_PowerDistributionCircuit4.kicad_pcb, ulv_esc.kicad_pcb]
2016-08-09 More work on demodulator2
    New OP, simpler circuit
    [channel.sch, demodulator.kicad_pcb, demodulator.sch]
2016-08-12 Add some manufacturing holes and pads
2016-08-12 Add fieldmill_top_plate
    [fieldmill_top_plate.kicad_pcb, fieldmill_top_plate.sch]
2016-08-12 Fix copper area clearance so it passes DRC
    [fieldmill_top_plate.kicad_pcb]
2016-08-12 fieldmill_top_plate Gerbers
    [fieldmill_top_plate.drl, fieldmill_top_plate.gbl, fieldmill_top_plate.gbs, fieldmill_top_plate.gm1, fieldmill_top_plate.gtl, fieldmill_top_plate.gts]
2016-08-14 Add AD8253, start fieldmill6
    [fieldmill6.kicad_pcb, fieldmill6.sch]
2016-08-14 solder_bridge: Remove solder mask between pads
2016-08-14 fieldmill6: Lay out one channel of three
    [fieldmill6.kicad_pcb, fieldmill6.sch]
2016-08-15 More work, should be about ready to route
    [channel.sch, fieldmill6.kicad_pcb]
2016-08-15 OP amp comparison table
    LM6211 is sort of OK, but we can do better.
    Some of the fancy ones aren't terribly useful, despite their price (see: OPA128).
    [op_amps.ods]
2016-08-16 Minor improvements to power dist. circuit
    [ulv_PowerDistributionCircuit4.kicad_pcb, ulv_PowerDistributionCircuit4.sch]
2016-08-17 minor text changes
    [ulv_PowerDistributionCircuit4.kicad_pcb]
2016-08-20 Rename/unassign pins on SCUBE40
    [channel.sch, demodulator.sch, ulv_PowerDistributionCircuit4.sch, ulv_esc.sch]
2016-08-20 Amplifier connectors have moved to demodulator boards
    Add buffers to OUTx biasing circuit..
    [cpu.kicad_pcb, cpu.sch]
2016-08-23 Copy TACH circuit from fieldmill5
    [channel.sch, fieldmill6.kicad_pcb, fieldmill6.sch]
2016-08-23 mv demodulator demodulator2, rm cache
    [channel.sch, demodulator2.kicad_pcb, demodulator2.sch]
2016-08-23 Route channel 3 in field mill 6
    [fieldmill6.kicad_pcb]
2016-08-23 Route channel 1, 2, and 3
    [fieldmill6.kicad_pcb]
2016-08-23 Rework most of demodulator2
    [channel.sch, demodulator2.sch]
2016-08-23 Route remaining parts of the board
    [fieldmill6.kicad_pcb]
2016-08-24 Route between parts WIP
    [fieldmill6.kicad_pcb]
2016-08-25 Add OPs for CHANNELa and CHANNELb
    Might want to add hysteresis..
    [channel.sch, demodulator2.sch]
2016-08-26 Route all unrouted tracks
    [fieldmill6.kicad_pcb]
2016-08-30 Added ADG1219, a nice 3.3V controllable SPDT analog switch
2016-08-30 Simplify demodulator2, pick +-2.5 V LO
    This puts the input of the ADC between 0.024 to 2.024 V.
    [channel.sch, demodulator2.sch]
2016-08-31 demodulator2 design mostly done
    [channel.sch, demodulator2.sch]
2016-09-05 PWM out, TACH in
    We're quickly running into the limits of the Arduino libraries with this one.
2016-09-05 Add some overview and mention the need for a programming device
2016-09-06 cp demodulator2 demodulator3
    [channel.sch, demodulator3.kicad_pcb, demodulator3.sch]
2016-09-06 Simpler demodulator
    [channel.sch, demodulator3.sch]
2016-09-06 Simplify BIAS application, add input bias compensation resistors
    [channel.sch, demodulator3.sch]
2016-09-07 fieldmill6: Clean up board a bit
    [channel.sch, fieldmill6.kicad_pcb]
2016-09-12 Some example output and useful Octave script
    [out.csv]
2016-09-19 Add PVZ2A footprint and more solder bridges
2016-09-19 New TACH circuit, more config bridges
    [channel.sch, fieldmill6.kicad_pcb, fieldmill6.sch]
2016-09-19 fieldmill6: Finish design, add gerbers
    [fieldmill6.kicad_pcb, fieldmill6.sch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]
2016-09-19 Add missing GND to U10D
    [channel.sch, fieldmill6.sch]
2016-09-19 fieldmill6: Increase solder mask clearance to 100 µm, drills to 0.3 mm
    [fieldmill6.kicad_pcb]
2016-09-19 fieldmill6: New gerbers..
    [fieldmill6.drl, fieldmill6.gbl, fieldmill6.gbs, fieldmill6.gm1, fieldmill6.gtl, fieldmill6.gts]
2016-09-20 Start adc1
    [adc1.kicad_pcb, adc1.sch]
2016-09-20 Start putting connectors on adc1
    [adc1.sch]
2016-09-20 Add some bits about field strength vs voltage levels
    This should really be a spreadsheet with formulas etc
2016-09-26 scube.lib: Add -2.5V, new ADC and assigned some more pins on SCUBE40
2016-09-26 More work on adc1
    [adc1.sch]
2016-09-26 Using 47 pF instead of 150 pF in fieldmill6
    [channel.sch, fieldmill6.sch]
2016-09-28 Reserve DRDYa/b, update pin assignment document
2016-09-28 adc1: Schematic done
    [adc1.sch]
2016-09-28 Start laying the ADC board out
    [adc1.kicad_pcb]
2016-09-28 Octave evaluation of filter design
    We want the response in the pass band to be as flat as possible, which is easier said than done.
    For now the ripple is about 0.4 dB between 100-1000 Hz.
2016-09-28 Forgot adc1_channel.sch
    [adc1_channel.sch]
2016-09-29 Hypothetical 2nd hi-pass + 3rd lo-pass
    The original idea is probably fine, since we can calibrate things
2016-10-03 adc1: All parts placed, pre-route
    [adc1.kicad_pcb, adc1.sch, adc1_channel.sch]
2016-10-03 Almost there..
    [adc1.kicad_pcb, adc1.sch, adc1_channel.sch]
2016-10-03 adc1: Finish routing
    Reassigned SPI pins to make it easier
    [adc1.kicad_pcb, adc1.sch, adc1_channel.sch]
2016-10-03 Finally deprecate extra pins on ESC, we're spinning new boards
2016-10-03 adc1: Add some extra decoupling caps, improve ground plane
    [adc1.kicad_pcb, adc1.sch, adc1_channel.sch]
2016-10-04 Add special footprint for 2x10 socket header that can take AMPMODU's type with 7.62 mm vertical spacing in addition to the normal 2.54 mm
    It's hard to find the latter type of socket header, unfortunately
2016-10-04 adc1: Switch to the multi-component footprint for the 2x10 header
    This required some shuffling around of the input resistors, but nothing too major
    [adc1.kicad_pcb, adc1.sch]
2016-10-04 adc1: Add name and date
    [adc1.kicad_pcb, adc1.sch, adc1_channel.sch]
2016-10-04 adc1 gerbers
    [adc1.drl, adc1.gbl, adc1.gbs, adc1.gm1, adc1.gtl, adc1.gts]
2016-10-05 Getting somewhere with the CPU. It seems we may have enough pins for 64k of XMEM
    [cpu.kicad_pcb, cpu.sch]
2016-10-07 cpu: Add XMEM
    Assigning footprints etc it still TODO.
    [cpu.sch, xmem.sch]
2016-10-09 Add more components, and explicit footprint for SO-20
2016-10-09 cpu: Good enough to try some rounting
    [cpu.sch, xmem.sch]
2016-10-09 Route most of cpu
    There's still some design stuff to do
    [cpu.kicad_pcb, cpu.sch]
2016-10-09 Added open-source output to be able to use more than one TX
    More or less finished..
    [cpu.kicad_pcb, cpu.sch, xmem.sch]
2016-10-10 fieldmill6: Add note about 10k
    [fieldmill6.sch]
2016-10-10 cpu: Add protection diode on supply jumper
    [cpu.kicad_pcb, cpu.sch]
2016-10-10 cpu: Gerbers
    [cpu.kicad_pcb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]
2016-10-10 Update pin assignment to reflect what is now on the CPU card
2016-10-10 cpu: Updated gerbers with supply diode
    [cpu.gbl, cpu.gbs, cpu.gm1, cpu.gtl, cpu.gts]
2016-10-18 rename filter.m to filter1.m to avoid collisions with octave's built-in filter function
2016-10-18 Analyze what happens when we average two consecutive samples from a sinc^3 filter
    Turns out we get sinc^2(f)*sinc(2f), so a null at Nyquist like we want
2016-10-18 cp fieldmill6 fieldmill7
    [channel.sch, fieldmill7.kicad_pcb, fieldmill7.sch]
2016-10-18 Add SMD footprint that accepts both 2010 and 2512 parts
    This is useful for being able to pick more types of high-ohm resistors
2016-10-18 fieldmill7: Almost done with schematic
    [channel.sch, fieldmill7.kicad_pcb, fieldmill7.sch]
2016-10-23 fieldmill7: Guard rings laid out, copper pour removed to reduce stray capacitance
    Most of the components are placed. Need to decide on a connector for the digital side
    [channel.sch, fieldmill7.kicad_pcb, fieldmill7.sch]
2016-10-23 fieldmill7: Use same SMD 10-pin socket for digital as analog, add protection diode to +3V3
    [channel.sch, fieldmill7.kicad_pcb, fieldmill7.sch]
2016-10-24 cpu: Switch to 7.3728 MHz
    This divides nicer to common baud rates, especially 115200.
    [cpu.sch]
2016-10-26 fieldmill7: Place all components
    [fieldmill7.kicad_pcb]
2016-10-30 fieldmill7: Partway through routing
    [channel.sch, fieldmill7.kicad_pcb, fieldmill7.sch]
2016-10-31 cpu: Change SRAM to one in *400 mil* wide SOJ-32 that still meets our spec
    Turns out 300 mil parts don't fit 400 mil footprints very well..
    [xmem.sch]
2016-10-31 Start ADC reading program. USART0 + USART1 works, key was disable 103 compat
2016-11-04 Demonstrate sample reading and demodulation
    We're at 76% CPU with this setup. There's is still plenty that can be done to optimize things further.
2016-11-05 Inline SPI transfer and demodulation in /DRDY interrupts
    This should hopefully be maximally optimal.
    sintab has also been optimized in terms of signal-to-residual.
2016-11-07 Use correct initial phase, only assert busy when in interrupts
    If the printf() takes too long then we will notice
    [adc.c]
2016-11-08 Fix currenttime() giving incorrect results when TOV1 is set
    This can happen if an oveflow occurs while cli()d
    [adc.c]
2016-11-08 Optimize TACH ISR further by having Timer1 reset each time, counting the number of cycles between TACHs directly
    [adc.c]
2016-11-08 Add ISP disabler
    The idea here is to prevent our long serial cable from loading down SCLK, since the SPI clock is shared with the ISP interface.
    However, it turns out that simply adding the 4016 is enough to prevent SCLK from being messed up.
    For now we'll still make use of it. It doesn't interfere with ISP
    [adc.c]
2016-11-21 fieldmill6: Fix R24. Is 10k in reality
    [fieldmill6.sch]
2016-11-21 Add ulv_power2
    There's still some small things to add, such as +-9V regulator
    [ulv_power2.kicad_pcb, ulv_power2.sch]
2016-11-22 ulv_power2: Add +-9V
    [ulv_power2.sch]
2016-11-22 Add MAX485
    We should have the 3.3V version
2016-11-22 ulv_power2: Add MAX485, simplex or duplex
    [ulv_power2.kicad_pcb, ulv_power2.sch]
2016-11-24 Nes RSO-2412D footprint
    TODO: double-check drill size
2016-11-24 ulv_power2: Mostly done. Double-check drill sizes and clearances
    [ulv_power2.kicad_pcb, ulv_power2.sch]
2016-11-25 Widen THN 30-2415 drill to 1.1 mm
    Pins are 1.0 mm, copper builds 35 µm from each side meaning 1.016 mm is not enough.
    1.1 mm should be about right, since 1.016 mm is enough for the 0.9 mm pins of SSQ-120-03-F-S.
2016-11-25 ulv_power2: Fix/merge drill sizes
    No need to have both 0.75 and 0.762 for example
    [ulv_power2.kicad_pcb]
2016-11-25 ulv_power2: Final adjustments, gerbers
    [ulv_power2.kicad_pcb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]
2016-11-28 ulv_power2: Fix name of 3.3V reg
    [ulv_power2.sch]
2016-11-28 Print amount of compile-time SRAM used
2016-11-29 Add free SRAM printer
2016-11-29 Add USART0_UDRE ISR
    The idea is to add a 'background printf'. The overhead of the ISR is low enough that we gain from it
2016-11-29 Fix currenttime()
    Seems a better approach is to clear Timer1 somewhere in the middle of its range, so that it never overflows.
    Else it is possible that it overflows between reading TCNT1 and cheching TIFR, leading to 65536 too large value
    [adc.c]
2016-11-29 Use pgmspace for some strings and printf()s
2016-11-29 Reworked code, much improved phase correctness
    Reduced sample rate to 1800 until the code has been proven to be correct, at which point we can optimize.
    [adc.c]
2016-11-30 Reduce /DRDY-to-sei delay. Switch global time to 24-bit, saving cycles here and there
2016-12-04 Implement USART1_UDRE_vect in asm
    This frees up up to 34% CPU for main loop tasks while printing
2016-12-05 ulv_power2: Fix resistor values
    We don't want +-10.2V..
    [ulv_power2.kicad_pcb, ulv_power2.sch]
2016-12-05 Make sure interrupts are enabled in bprintf_P()
2016-12-05 Replace all printf()s with printf_P()
    [adc.c]
2016-12-05 Use Timer3 for global time since we need Timer1's outputs for PWM
2016-12-06 No need to set PF0 when it's already being set during SPI init
2016-12-06 Set up motor PWMs
2016-12-06 cp fieldmill_top_plate fieldmill_top_plate2
    [fieldmill_top_plate2.kicad_pcb, fieldmill_top_plate2.sch]
2016-12-06 fieldmill7: 10M transimpedance, smaller motor hole (22.5 mm)
    [channel.sch, fieldmill7.kicad_pcb, fieldmill7.sch]
2016-12-06 New top plate design
    This also has much tighter clearances than the older design, which might reduce charge buildup
    [fieldmill_top_plate2.kicad_pcb]
2016-12-07 Alternative design without 0.5 mm spokes
    The intent is to make it easier to build up the sensor thickness to more than 2*clearance, say with 0.5 mm copper
    [fieldmill_top_plate2.kicad_pcb]
2016-12-07 Tachometer holes
    [fieldmill_top_plate2.kicad_pcb, fieldmill_top_plate2.sch]
2016-12-08 fieldmill7: Add tachometer holes
    [channel.sch, fieldmill7.kicad_pcb, fieldmill7.sch]
2016-12-08 Add reverse-smd hole mounted SG-2BC
    This works a bit like how SMD LEDs can be mounted backwards across a hole, except for an IR reflex detector
2016-12-08 Switch tachometer holes to 4.3 mm, replace holes in fieldmill7 with 2x SG-2BC
    [channel.sch, fieldmill7.kicad_pcb, fieldmill7.sch, fieldmill_top_plate2.kicad_pcb]
2016-12-08 SG-2BC: Fix pad-hole clearance
2016-12-08 fieldmill7: Two TACH channels, more sensible/compact threshold configuration
    [channel.sch, fieldmill7.kicad_pcb, fieldmill7.sch]
2016-12-09 fieldmill_top_plate2: Gerbers
    [fieldmill_top_plate2.drl, fieldmill_top_plate2.gbl, fieldmill_top_plate2.gbs, fieldmill_top_plate2.gm1, fieldmill_top_plate2.gtl, fieldmill_top_plate2.gts]
2016-12-11 fieldmill7: More routing
    [fieldmill7.kicad_pcb]
2016-12-12 fieldmill7: Finish routing
    [channel.sch, fieldmill7.kicad_pcb]
2016-12-12 fieldmill7: Add courtyard circle for motor, adjust traces going into ADC to 0.25 mm
    [fieldmill7.kicad_pcb]
2016-12-13 fieldmill7: Finishing touches
    [fieldmill7.kicad_pcb]
2016-12-13 fieldmill7: Gerbers
    [fieldmill7-B.Cu.gbl, fieldmill7-B.Mask.gbs, fieldmill7-Edge.Cuts.gm1, fieldmill7-F.Cu.gtl, fieldmill7-F.Mask.gts, fieldmill7-NPTH.drl, fieldmill7.drl]
2016-12-18 fieldmill7: Change values to match reality
    [fieldmill7.sch]
2016-12-18 Switch XTAL2 to 3.3V output
    This uses more power, but allows us to run the ADC at a higher speed
    We could get even more power out of the ADC by running it at 14.7456 MHz and using half of that to drive the CPU
2016-12-20 Less print spam
2016-12-20 Improve sample timing
    Since the ADC runs at a fixed rate we can extrapolate the time of each sample from some well-timed sample
    At the moment this well-timed sample is the second sample efter the third TACH impulse
    A better solution would be to use the input capture unit(s)
    [main.c]
2016-12-20 Improve second_samplet timing by disabling timer3 interrupts
    This is about as well as we can do without input capture
2016-12-20 Conform initial samplet to within 0..K-1 of first_tachstart
2016-12-21 Improve speed by inlining some SPI things
    We could go even further with some inline ASM
2016-12-23 De-statify usart1_buf so it shows up in adc.map
2016-12-27 Start both motors, configure both ADCs
2016-12-27 Print both channels in one go, reduce spam
2016-12-29 Sweep motor speed up and down
2016-12-29 Increase gain
    We seem to have quite a bit of voltage margin
2016-12-29 filter1: Add phase to sinc3
2016-12-30 Raw data
    s = 62.5 cm
    N = 100
    U = +-30V
    E ≃ 100 V/m
    [data_x.csv, data_y.csv, data_z.csv]
2017-01-03 Restart ADC setup if UNLOCK doesn't work
    This makes it possible to turn on 3.3V and 24V in any order
    [adc.c]
2017-01-03 New control scheme
    Motors are given time to read each target speed, then averages are taken for some fixed amount of time (3000 ms).
    This removes the previous unfairness of fast speeds leading to fewer samples.
    [main.c]
2017-01-14 fieldmill7: Change IR shunts to 470k to match reality
    [channel.sch, fieldmill7.kicad_pcb, fieldmill7.sch]
2017-01-14 ulv_power2: Match reality
    [ulv_power2.kicad_pcb, ulv_power2.sch]
2017-01-14 fieldmill7: Add some notes
    [fieldmill7.sch]
2017-01-17 Implement device enumeration, read all DS18B20s
2017-01-23 cp cpu cpu2
    [cpu2.kicad_pcb, cpu2.sch, xmem.sch]
2017-01-23 Add some notes
    [cpu2.sch]
2017-02-01 Save the code used for longterm drift test
    [main.c]
2017-02-01 Remove unused SCUBE40 footprints
2017-02-13 cp fieldmill7 fieldmill8
    [channel.sch, fieldmill8.kicad_pcb, fieldmill8.sch]
2017-02-13 fieldmill8: Begin design with AD8555
    It's not looking super-optimized for our application, but it should work well enough
    [channel.sch]
2017-02-15 fieldmill8: Add protection in various places
    A simple resistor+capacitor is often enough to protect against damage from latch-up, according to IRF
    We may need to take a couple of passes over their values to determine whether they're enough
    Finally, we may want to change to a +-5 V switched supply
    [channel.sch, fieldmill8.sch, tachs.sch]
2017-02-15 Think a bit about the poor SOT-23 having to dissipate 300 mW in vacuum
    [fieldmill8.sch]
2017-02-17 More thought. Look for wideband high-PSRR LDOs
    [fieldmill8.sch, tachs.sch]
2017-02-20 mv ulv_power2 power2
    [power2.kicad_pcb, power2.sch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]
2017-02-20 mv ulv_PowerDistributionCircuit4 power1
    [ulv_PowerDistributionCircuit4.kicad_pcb, ulv_PowerDistributionCircuit4.sch]
2017-02-20 cp power2 power3
    [power3.kicad_pcb, power3.sch]
2017-02-20 Start working on power3
    Screw holes are 65x65 mm, pin header positions not finalized
    [power3.kicad_pcb, power3.sch]
2017-02-21 Slower speed for pumpingdown4 test
2017-02-24 Add note about new switchregs
    [power3.sch]
2017-02-27 fieldmill8: Start using multiple fixed LDOs
    This should quite a bit more rugged than the previous attempt
    [channel.sch, fieldmill8.sch, tachs.sch, vreg.sch]
2017-03-05 fieldmill8: A bunch more changes
    [channel.sch, fieldmill8.sch, tachs.sch, vreg.sch]
2017-03-06 fieldmill8: More work
    [channel.sch, fieldmill8.sch, tachs.sch, vreg.sch]
2017-03-06 fieldmill8: Simplify design
    [channel.sch, fieldmill8.sch, tachs.sch, vreg.sch]
2017-03-06 fieldmill8: Start figuring out DACs
    [fieldmill8.sch]
2017-03-09 fieldmill8: Add VGND circuit
    Uses an ADG601 + pull-down resistor to ensure we can get pretty dang close to zero volts +- a few nV/sqrt(Hz)
    [fieldmill8.sch]
2017-03-11 Make it so that the +- 2.5V regulators aren't connected together
    [channel.sch, fieldmill8.sch, tachs.sch, vreg.sch]
2017-03-11 Assign some footprints
    [channel.sch, fieldmill8.sch, tachs.sch, vreg.sch]
2017-03-12 Don't need 1u caps on ADC when regs already have 2.2u caps
    [fieldmill8.sch, vreg.sch]
2017-03-14 More work
    [channel.sch, fieldmill8.sch, tachs.sch, vreg.sch]
2017-03-19 Add ADM7160, ADP7182 and footprint for 0806SQ-19N
2017-03-19 fieldmill8: Schematic done
    [channel.sch, fieldmill8.sch, tachs.sch, vreg.sch]
2017-03-19 fieldmill8: Change guard ring to VGND, use correct packages for parts
    Most of the parts have changed reference etc, so we might be better of starting this layout mostly from scratch
    [channel.sch, fieldmill8.kicad_pcb, fieldmill8.sch, vreg.sch]
2017-03-19 Switch back to 2x17 connector, can't source a 2x19 one
    [channel.sch, fieldmill8.kicad_pcb, fieldmill8.sch, vreg.sch]
2017-03-19 cpu2: Start designing, rough board layout
    [connectors.sch, cpu2.kicad_pcb, cpu2.sch, xmem.sch]
2017-03-22 fieldmill8: Add optional programmable IR bias, and optional bias to -5V
    This should give us enough customizability
    Added an ITR20001 too, since the new motor has an exposed rotor on the inside, outside the view of our pesky sun
    [fieldmill8.sch, tachs.sch]
2017-03-22 Group components like they are in the schematic
    [fieldmill8.kicad_pcb]
2017-03-23 fieldmill8: Use correct SMD header, use ITR20001 footprint
    [fieldmill8.sch, tachs.sch]
2017-03-23 Route channel 1
    [fieldmill8.kicad_pcb]
2017-03-23 Route channel 3
    [fieldmill8.kicad_pcb]
2017-03-23 Finishing routing channels
    still need to place them on the PCB
    [fieldmill8.kicad_pcb]
2017-03-23 minor readjustments
    [fieldmill8.kicad_pcb]
2017-03-23 cpu2: Match fieldmill8 pinout
    Exact contact positioning is TODO obviously
    [connectors.sch, cpu2.kicad_pcb, cpu2.sch]
2017-03-23 Channel 1 routed in place
    reg still missing
    [fieldmill8.kicad_pcb]
2017-03-23 fieldmill8: Add an LED to tachometer output
    [tachs.sch]
2017-03-25 Just keep routing o/~ - Mel. Just keep swimming
    Just keep routing,
    Just keep routing,
    Just keep routing routing routing,
    What do we do we route route route...
    Miniaturizing modules to see how we can place everything.
    Hopefully we'll be able to blow them up in size when we know how much
    room we have.
    [fieldmill8.kicad_pcb]
2017-03-25 cpu2: Try to place a pin header
    Tetrising this up is going to require some CAD fiddling
    [cpu2.kicad_pcb]
2017-03-27 cpu2: Place pin headers, start connecting things and add protection resistors
    [connectors.sch, cpu2.kicad_pcb, cpu2.sch, power.sch, xmem.sch]
2017-03-28 Add M6 mounting hole
2017-03-28 cpu2: More work
    [connectors.sch, cpu2.kicad_pcb, cpu2.sch, power.sch, xmem.sch]
2017-03-28 Add special variant of ATmega128 to help pass ERC
    This is needed because we have two ATmega128s on top of each other in order to get the TQFP and ceramic footprints to work together nicely
2017-03-28 cpu2: Mostly finished design, pases ERC
    Special ERC to allow NC to be connected to NC for /PEN
    [connectors.sch, cpu2.sch, power.sch, xmem.sch]
2017-03-28 cpu2: Spread components out
    Add note about A vs B in RS-485 failsafe termination
    [cpu2.kicad_pcb, power.sch]
2017-03-29 fieldmill8: Make center ring GND instead of VGND
    [fieldmill8.kicad_pcb]
2017-03-29 fieldmill8: placed reg4 + fixed DRC issues
    [fieldmill8.kicad_pcb]
2017-03-30 fieldmill8: More routed
    [fieldmill8.kicad_pcb]
2017-03-31 fm8: Routing some more, fixing some issues
    [fieldmill8.kicad_pcb]
2017-03-31 fm8: Adds marking on silkscreen for washers
    No bottom layer (component side) traces should be within these areas
    [fieldmill8.kicad_pcb, fieldmill8.sch]
2017-03-31 fieldmill8: Move stuff to avoid collisions with washers
    [fieldmill8.kicad_pcb]
2017-03-31 fieldmill8: Move back IR sensor
    [fieldmill8.kicad_pcb]
2017-03-31 fieldmill8: Routed air wires for placed components
    [fieldmill8.kicad_pcb]
2017-04-03 .. and incorporate it into cpu2
    [cpu2.kicad_pcb, cpu2.sch]
2017-04-03 cpu2: Start laying things out
    Connector to potential DE-9 adaptor board is still TODO
    [connectors.sch, cpu2.kicad_pcb, cpu2.sch, power.sch, xmem.sch]
2017-04-03 Only DE-9 -> pin header on power3 board
    [power3.kicad_pcb, power3.sch]
2017-04-03 power3: Add DS18B20Z
    [power3.kicad_pcb, power3.sch]
2017-04-04 Finalize motor placement
    [fieldmill8.kicad_pcb]
2017-04-04 Synchronize cpu2 and power3
    All pins that will be used in flight are doubled, some debug pins only show up once instead
    [connectors.sch, cpu2.kicad_pcb, cpu2.sch, power.sch, power3.kicad_pcb, power3.sch]
2017-04-04 Add missing holes to LPPB122NFSP-RC
    Update PCBs with the new footprint
    fieldmill8 now violates DRC
    [cpu2.kicad_pcb, fieldmill8.kicad_pcb]
2017-04-04 Match Isak's drawing
    [fieldmill8.kicad_pcb]
2017-04-09 fieldmill8: route around thermal structures on comp-side
    [fieldmill8.kicad_pcb]
2017-04-09 fieldmill8: expose copper for thermal structure
    [fieldmill8.kicad_pcb]
2017-04-09 fieldmill8: changing center layout
    [fieldmill8.kicad_pcb]
2017-04-09 fieldmill8: place and route remaining components outside
    [fieldmill8.kicad_pcb]
2017-04-09 fieldmill8: routed remaining components inlace
    No more DRC issues
    [fieldmill8.kicad_pcb]
2017-04-09 fieldmill8: fix some routing issues
    [fieldmill8.kicad_pcb]
2017-04-09 fieldmill8: fixed guarding issue
    [fieldmill8.kicad_pcb]
2017-04-09 fieldmill8: move tight components further appart
    [fieldmill8.kicad_pcb]
2017-04-09 cpu2: Remove the 3.3V header
    We just run on 24V these days
    [cpu2.kicad_pcb, power.sch]
2017-04-09 cp fieldmill_top_plate2 fieldmill_top_plate3
    [fieldmill_top_plate3.kicad_pcb, fieldmill_top_plate3.sch]
2017-04-09 fieldmill8: make room for IR2 12 o'clock
    [fieldmill8.kicad_pcb]
2017-04-09 fieldmill8: remove routing for IR2 and fix the rest
    [fieldmill8.kicad_pcb]
2017-04-09 fieldmill8: route IR2
    [fieldmill8.kicad_pcb]
2017-04-09 fieldmill8: optimize and add knit GND areas
    [fieldmill8.kicad_pcb]
2017-04-09 fieldmill_top_plate3: Remove spokes, bigger via ring, slightly larger r2
    [fieldmill_top_plate3.kicad_pcb]
2017-04-09 fieldmill8: optimise ground plane
    [fieldmill8.kicad_pcb]
2017-04-09 Change all arc_segments from 16 to 32
    [fieldmill_top_plate3.kicad_pcb]
2017-04-11 Update silkscreen around U3
    [fieldmill8.kicad_pcb]
2017-04-12 power3: Adjust to better match CAD drawings
    [power3.kicad_pcb, power3.sch]
2017-04-15 fieldmill8: fix cutout for channel 3
    [fieldmill8.kicad_pcb]
2017-04-17 fieldmill8: moves contacts according to sebastians instructions
    [fieldmill8.kicad_pcb]
2017-04-17 fieldmill8: fix ground around the center hole
    [fieldmill8.kicad_pcb]
2017-04-17 cpu2: Place components
    Could probably be somewhat improved
    [cpu2.kicad_pcb]
2017-04-18 fieldmill_top_plate3: Gerbers
    [fieldmill_top_plate3.drl, fieldmill_top_plate3.gbl, fieldmill_top_plate3.gbs, fieldmill_top_plate3.gm1, fieldmill_top_plate3.gtl, fieldmill_top_plate3.gts]
2017-04-19 power3: Import CAD dxf and re-arrange stuff
    [power3.kicad_pcb, power3.sch]
2017-04-23 Can't source 350 Ohm, switch to 360
    [power.sch]
2017-04-26 fieldmill8: move IR2
    [fieldmill8.kicad_pcb]
2017-04-26 power3: wip
    [power3.sch]
2017-04-26 power3: Change to 2x10 connector
    [power3.kicad_pcb, power3.sch]
2017-04-26 power3: Add LEDs, place parts
    [power3.kicad_pcb, power3.sch]
2017-04-26 power3: Finish routing the four pins to the lander
    [power3.kicad_pcb]
2017-04-26 power3: Almost done
    [power3.kicad_pcb]
2017-04-29 cpu2: Route a lot of stuff on cpu2
    [cpu2.kicad_pcb]
2017-04-29 cpu2: Fix some DRCs
    [cpu2.kicad_pcb]
2017-04-30 cpu2: Reduce clearance to .19, fix NCs being connected
    This fixes all remaining DRC issues.
    [cpu2.kicad_pcb]
2017-04-30 power3: Routed
    [power3.kicad_pcb]
2017-05-01 power3: Optimize routing, adding assigning netclasses
    [power3.kicad_pcb]
2017-05-02 power3: Seems I forgot LED footprints
    [power3.sch]
2017-05-02 cpu2: Match power3 connector, move one mounting hole
    Y position of P4 is not final. X position matches power3.
    [cpu2.kicad_pcb, power.sch]
2017-05-04 cpu2: Possibly correct 2x10 position, but the drawings are inconsistent
    [cpu2.kicad_pcb]
2017-05-06 cpu2: Correct Y position
    [cpu2.kicad_pcb]
2017-05-07 cpu2: Route connector
    [cpu2.kicad_pcb]
2017-05-07 cpu2: Add LEDs to PD0, PD1, configuration jumper for EN_VGND0/1
    [cpu2.kicad_pcb, cpu2.sch]
2017-05-07 Minor fix
    [cpu2.kicad_pcb]
2017-05-08 Clarify some component choices
    We want to always use industrial variants that can handle at least -40..+85°C
    Using the RS series (2W) from Recom instead of RSO (1W). Z variants take 9..36 V
    [channel.sch, cpu2.sch, power.sch, xmem.sch]
2017-05-09 fieldmill8: Use SMD pads for motor, add tach LED
    Enlarged the copper areas around the motor too.
    [channel.sch, fieldmill8.kicad_pcb, fieldmill8.sch, tachs.sch, vreg.sch]
2017-05-09 fieldmill8: Put bypass solder pads on 19n4 inductors
    It'll be 10 weeks before we get them, and they're not strictly needed
    [channel.sch, fieldmill8.kicad_pcb, fieldmill8.sch, tachs.sch, vreg.sch]
2017-05-09 cpu2: Add some more decoupling, silkscreen outlines on power modules
    [connectors.sch, cpu2.kicad_pcb, power.sch, xmem.sch]
2017-05-15 cpu2: Enthicken VLANDER, +24V and +3V3
    [cpu2.kicad_pcb]
2017-05-15 cpu2: Adjust more
    [cpu2.kicad_pcb]
2017-05-15 cpu2: Move holes and silkmask references around
    [cpu2.kicad_pcb]
2017-05-15 power3: Fix references here too
    Only had to move one hole :)
    [power3.kicad_pcb]
2017-05-15 fieldmill8: Fix position of P11
    [fieldmill8.kicad_pcb]
2017-05-15 fieldmill8: Mount ITR-20001 in LPPB032NFSP
    Pins should fit, but we can file them down a bit if not.
    Solder them in place after that.
    Another alternative is to solder the ITR-20001's pins to the LPPB032NFSP pads.
    The ITR-20001 has been placed at around 3 mm from the rotor,
    to give the light a low enough incident angle (too close = blind)
    [fieldmill8.kicad_pcb]
2017-05-15 filedmill8+cpu2: optimizing routing
    [cpu2.kicad_pcb, fieldmill8.kicad_pcb]
2017-05-16 fieldmill8: Assign motor enable pin, note tachometer experiment
    [fieldmill8.sch, tachs.sch, vreg.sch]
2017-05-16 fieldmill8: Re-fix motor pads, thicken +24V, widen some GND via drills
    [fieldmill8.kicad_pcb]
2017-05-16 fieldmill8: Start making silk plottable
    Hopefully our fab can print the smaller font required in some spots
    [fieldmill8.kicad_pcb]
2017-05-16 fieldmill8: Finish silkscreen
    Some labels ended up on the 'user drawings' layer
    [fieldmill8.kicad_pcb]
2017-05-16 Discovered cpu2 and fm8 don't have consistent connector Ys or orientation :[
    [cpu2.kicad_pcb, fieldmill8.kicad_pcb]
2017-05-16 fieldmill8: Mark dimensions, take positions as they are
    We can't really move the ADC..
    [fieldmill8.kicad_pcb]
2017-05-18 update gerber settings
    [fieldmill8.kicad_pcb]
2017-05-18 fieldmill8: Remove mask around sensor holes on top layer
    [fieldmill8.kicad_pcb]
2017-05-21 cpu2: Fix connector orientation
    Had to rip up a lot of tracks
    Moved some nearby components too
    [connectors.sch, cpu2.kicad_pcb]
2017-05-21 cpu2: Route about half
    [cpu2.kicad_pcb]
2017-05-22 fieldmill8: Let's go with 470p on C6 since that's the part we ordered
    Would only cause confusion elsewise
    [fieldmill8.kicad_pcb, tachs.sch]
2017-05-22 fieldmill8: Set appropriate attributes for pick & place
    [fieldmill8.kicad_pcb]
2017-05-23 Add paste, BOM and PnP
    Had to generate BOM by temporarily deleting components in schematic
    No paste on MOTOR_SMD
    [bom_pcb.csv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]
2017-05-23 cpu2: Finish routing
    Might do some minor touch-ups, but not much
    [cpu2.kicad_pcb]
2017-05-25 cpu2: Move 3.3V regulator a bit
    [cpu2.kicad_pcb]
2017-05-26 cpu2: Move some components to top, add more diodes, logos
    [cpu2.kicad_pcb, power.sch]
2017-05-26 Musikhjälpen 2016
    [cpu2.kicad_pcb]
2017-05-28 More logos
    [cpu2.kicad_pcb]
2017-05-29 cpu2: More fiddling
    [cpu2.kicad_pcb]
2017-05-29 cpu2: Swap pins 55 & 56 <--> 25 & 26
    This frees up two potential ADC inputs
    There's some interest in adding a piezo mic in a later revision,
    and I'd like not to have to change pin assignments to support it
    [cpu2.kicad_pcb, cpu2.sch]
2017-05-29 power3: More ground pour, label, gerbers
    [power3.kicad_pcb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]
2017-05-30 cpu2: Add layer refs
    [cpu2.kicad_pcb]
2017-05-30 Thicker outline
    [cpu2.kicad_pcb]
2017-05-30 cpu2: Make ground pours better
    [cpu2.kicad_pcb]
2017-05-30 More names, push things around
    [cpu2.kicad_pcb]
2017-05-30 Make room for 2.4 mm routing bit near the pin headers
    [cpu2.kicad_pcb]
2017-05-30 Remove IC1 from paste, move P3 ref
    [cpu2.kicad_pcb]
2017-05-30 cpu2: Paste clearance 0.075 mm, gerbers
    Clearance value taken from https://rheingoldheavy.com/design-assembly-kicad/
    [cpu2-B.Cu.gbl, cpu2-B.Mask.gbs, cpu2-B.SilkS.gbo, cpu2-Edge.Cuts.gm1, cpu2-F.Cu.gtl, cpu2-F.Mask.gts, cpu2-F.Paste.gtp, cpu2-F.SilkS.gto]
2017-06-06 Match shunt and decoupling for DS18B20Z between fm8, cpu2 and power3
    [cpu2.sch, power3.sch]
2017-06-16 cpu2: Switch to SOT-23 buffer
    [connectors.sch]
2017-06-19 Working fm8 ADC poll functionality
    This gets each ADS131A04 running and checks that the default registry contents are as expected
2017-06-20 Assert /EN_XMEM
    Would get lots of weird errors without this due to .bss being in XMEM..
    [main.c]
2017-06-20 Turn all motors on, do repeated ADC init
    The initing itself needs a bit of work since it works only every other time
2017-06-25 cp fieldmill8 fieldmill9
    [channel.sch, fieldmill9.kicad_pcb, fieldmill9.sch, tachs.sch, vreg.sch]
2017-06-25 Add current ROMs
2017-08-12 Add LPPB122NFSP-RC variants with holes and dummy pads on the bottom
    The point of the bottom pads is to be able to use cpu3 for bracing power4,
    in case we don't go with a credits board.
2017-08-12 fieldmill9: Switch to LPPB122NFSP-RC-holes
    [fieldmill9.kicad_pcb, fieldmill9.sch]
2017-08-12 fieldmill9: Round corners (R=10 mm), remove IR2
    [channel.sch, fieldmill9.kicad_pcb, fieldmill9.sch, tachs.sch, vreg.sch]
2017-08-14 fieldmill9: Fix tach low-pass
    [tachs.sch]
2017-08-14 Move some old designs into old/
    I'd delete them but they might still be useful to have handy
    [Komponentlista 3.ods, UmeaLunarVenture3.kicad_pcb, UmeaLunarVenture3.sch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]
2017-08-14 cp cpu2 cpu3
    [connectors.sch, cpu3.kicad_pcb, cpu3.sch, power.sch, xmem.sch]
2017-08-14 cpu3: Change to 2x12 to power, take Isak's design
    Re-routing and shrinking outline is TODO
    [connectors.sch, cpu3.kicad_pcb, power.sch]
2017-08-14 cpu3: Shrink outline, rip up some traces
    [cpu3.kicad_pcb]
2017-08-14 cpu3: Finish routing power corner
    [connectors.sch, cpu3.kicad_pcb, cpu3.sch, power.sch, xmem.sch]
2017-08-15 Add TSR 1
    We'll be using a TSR 1-2433 for 3.3V
2017-08-15 cpu3: Add TSR 1-2433 and TMR 6-2421WI as options
    [connectors.sch, cpu3.kicad_pcb, cpu3.sch, power.sch, xmem.sch]
2017-08-15 cpu3: Add TVS across Q1
    [connectors.sch, cpu3.kicad_pcb, cpu3.sch, power.sch, xmem.sch]
2017-08-16 cp power3 power4
    [power4.kicad_pcb, power4.sch]
2017-08-16 Add forgotten TSR 1 footprint
2017-08-16 Add combined footprint for 1206 and 2010
2017-08-16 power4: Outline and connectors
    [power4.kicad_pcb, power4.sch]
2017-08-16 Flip power connector the right way around
    [cpu3.kicad_pcb, power.sch, power4.kicad_pcb, power4.sch]
2017-08-16 power4: Route, make two of the new pins general purpose ones
    We might want to route something special to the credits board in the future,
    so it would be useful not to have to do anything more on this board.
    [power4.kicad_pcb, power4.sch]
2017-08-18 Samma manöver på övriga pinnar
    [power4.kicad_pcb, power4.sch]
2017-08-18 power4: Rounded corners everywhere, place connectors
    [power4.kicad_pcb]
2017-08-18 cpu3: Add jumpers for bypassing clock buffers
    [connectors.sch, cpu3.kicad_pcb]
2017-08-20 Change footprint from 2010 to a combined 1206 and 2010
    [fieldmill9.kicad_pcb, fieldmill9.sch, tachs.sch, vreg.sch]
2017-08-20 Route power4
    [power4.kicad_pcb]
2017-08-21 fieldmill9: Add corner plating
    [fieldmill9.kicad_pcb]
2017-08-21 cp fieldmill_top_plate3 fieldmill_top_plate4
    [fieldmill_top_plate4.kicad_pcb, fieldmill_top_plate4.sch]
2017-08-21 fieldmill_top_plate4: Pull back solder mask a bit more, for the plated corners on fieldmill9
    [fieldmill_top_plate4.kicad_pcb]
2017-08-21 fieldmill9: Route edge closer to op-amps
    Expanding the route outward is still TODO
    [fieldmill9.kicad_pcb]
2017-08-21 fieldmill9: Finish enlarging routed holes
    [fieldmill9.kicad_pcb]
2017-08-21 fieldmill9: Add Sallen-Key topology option to tachometer circuit
    [channel.sch, fieldmill9.kicad_pcb, tachs.sch, vreg.sch]
2017-08-21 Move silkscreen references around..
    [fieldmill9.kicad_pcb]
2017-08-21 Expand mask to cover low-impedance pins as much as possible
    [fieldmill9.kicad_pcb]
2017-08-21 fieldmill9: Gerbers
    [fieldmill9-B.Cu.gbl, fieldmill9-B.Mask.gbs, fieldmill9-B.SilkS.gbo, fieldmill9-Edge.Cuts.gm1, fieldmill9-F.Cu.gtl, fieldmill9-F.Mask.gts, fieldmill9-NPTH.drl, fieldmill9.drl]
2017-08-21 Add some vias to GND and VGND
    [fieldmill9.kicad_pcb]
2017-08-21 Add extra vias to GND, move logo, change to 1206-2010
    [cpu3.kicad_pcb]
2017-08-21 Change the rest of the 2010 to combined 1206-2010
    [connectors.sch, cpu3.kicad_pcb, cpu3.sch, power.sch, xmem.sch]
2017-08-22 fieldmill9: VGND capacitance stuff
    Capacitance for fieldmill8 between VGND and GND measured at 77 pF.
    This is likely decent enough. MAX504 can drive 100 pF.
    If more capacitance is needed then a series resistor must be added,
    else MAX504 output driver may become unstable. Board is layed out
    with options for this.
    [channel.sch, fieldmill9.kicad_pcb, fieldmill9.sch, tachs.sch, vreg.sch]
2017-08-22 top_plate4: Add courtyard showing where the metal overhang is
    [fieldmill_top_plate4.kicad_pcb]
2017-08-22 top_plate4: Move feed vias to patch corners, below metal
    Suggestion from Emadeldeen Hassan.
    Patch corners would have highest impedance if acting as antennas.
    Metal covering will act as 20-100 pF capacitors,
    shunting away much of any induced voltages.
    The combination of these two should make it very hard for
    X-band radiation to make it into our instrument!
    [fieldmill_top_plate4.kicad_pcb]
2017-08-23 Add combined 0806SQ-19N and 0603 footprint
2017-08-23 fieldmill9: Switch to L-14C56NJV4T coil, push copper back a bit
    Pushing copper back makes the input stage easier to solder
    [channel.sch, fieldmill9.kicad_pcb, vreg.sch]
2017-08-24 Enlarge smaller pads on combined footprints such that paste rectangles become merged
    Before they would be two separate rectangles separated by a thin line.
    Now they form a T.
2017-08-24 fieldmill9: Use new combined pads, pass DRC, update date
    [fieldmill9.kicad_pcb]
2017-08-24 cpu3: Fix combined footprints here too, and date and some text
    [cpu3.kicad_pcb]
2017-08-24 cpu3: Gerbers
    [cpu3-B.Cu.gbl, cpu3-B.Mask.gbs, cpu3-B.SilkS.gbo, cpu3-Edge.Cuts.gm1, cpu3-F.Cu.gtl, cpu3-F.Mask.gts, cpu3-F.Paste.gtp, cpu3-F.SilkS.gto]
2017-08-26 cpu3: Add ability to configure outermost pins of power connector, route I2C etc.
    [connectors.sch, cpu3.kicad_pcb, cpu3.sch, power.sch, xmem.sch]
2017-08-27 cpu3: More clearance around VIN and +24V
    [cpu3.kicad_pcb]
2017-08-28 cpu3: Gerbers (again)
    [cpu3-B.Cu.gbl, cpu3-B.Mask.gbs, cpu3-B.SilkS.gbo, cpu3-Edge.Cuts.gm1, cpu3-F.Cu.gtl, cpu3-F.Mask.gts, cpu3-F.Paste.gtp, cpu3-F.SilkS.gto]
2017-08-28 power4: Finish routing
    Increased clearance of VLANDER fill to 0.5 mm
    [power4.kicad_pcb]
2017-08-28 power4: Gerbers
    [power4-B.Cu.gbl, power4-B.Mask.gbs, power4-Edge.Cuts.gm1, power4-F.Cu.gtl, power4-F.Mask.gts, power4-NPTH.drl, power4.drl]
2017-08-28 top_plate4: Gerbers
    [fieldmill_top_plate4-B.Cu.gbl, fieldmill_top_plate4-B.Mask.gbs, fieldmill_top_plate4-Edge.Cuts.gm1, fieldmill_top_plate4-F.Cu.gtl, fieldmill_top_plate4-F.Mask.gts, fieldmill_top_plate4.drl]
2017-08-28 fieldmill9: Change 470 nH -> 56 nH and 470 Ohm -> 0 Ohm
    The coil change is mainly due to no more of that part available, plus simpler BOM
    [channel.sch, fieldmill9.sch, vreg.sch]
2017-08-29 cpu3: Differentiate different 10 µF variants
    The 50V ones are much more expensive than 25V
    [cpu3.sch, power.sch, xmem.sch]
2017-09-16 Add https://github.com/mmccoo/kicad_mmccoo/blob/master/gensvg/gensvg.py
    Apache license
2017-09-16 Make gensvg.py parse fieldmill9.kicad_pcb
    Don't do the pads, there's something wrong with SWIG std::vector something something.
2017-09-18 Configure everything except some 0 ohmers
    [channel.sch, fieldmill9.kicad_pcb, fieldmill9.sch, tachs.sch, vreg.sch]
2017-09-18 Finish configuring
    [fieldmill9.kicad_pcb]
2017-10-03 Make bootloader work
    There were three problems:
    * TXC not being cleared correctly
    * RX not disabled during TX
    * Not waiting long enough after disabling DE before enabling TX (ringing)
    [main.c, mega128.h]
2017-10-03 app: Steal more RS-485 code from bootloader, attempt soft reboot
    Idea is to enter the bootloader cleanly from the app when a start byte comes in.
    This needs more work however.
    [app.c]
2017-10-03 Switch to gnu99 for asm volatile to work, shorter sleep
    [app.c]
2017-10-09 Enable OC1C output for PWM2
2017-10-09 Add EEPROM
    The purpose here is to keep the motors running in the bootloader to reduce bearing wear.
    "make flight" initializes the EEPROM so that the motors start OFF.
    The application is responsible for writing the current motor speed to EEPROM to keep them from stopping.
2017-10-09 Add RX->TX delay in bootloader
    We had some issues when doing multidrop RS-485.
    Restarting minicom solved it, but adding extra delay here shouldn't hurt at least.
    [main.c]
2017-10-12 Start sketching manual and sample packet format
2017-10-15 Implement motor PWM, add version to sample_packet_header_s
2017-10-15 Fix and add 1-wire stuff
    [app.c]
2017-10-15 Add ability to control +24V/+-5V and command for setting motors to default speed
    It's a lot easier to type K in a terminal that copy+paste "M128 128 128"
2017-10-15 Front page, start writing assembly instructions
2017-10-15 Most of the assembly instructions done
2017-10-16 Get 1-wire rolling
2017-10-16 Paint instructions, PTFE wire details, silver paint
2017-10-16 Hook in DS18B20 stuff
    Check conversion progress by issueing read slots instead of blindly waiting 1000 ms
    [app.c]
2017-10-16 Clarify painting and reflex coupler stuff
2017-10-16 More torques, better shutter mounting
2017-10-17 Temperatures in sample packet
2017-10-17 ESC support, Timer1 stuff
2017-10-17 Add r - measure motor speeds
2017-10-17 fieldmill9: Messed up, configuring 0.8 Hz low-pass with passives-only
    [fieldmill9.kicad_pcb]
2017-10-18 Temperature sensor stuff
2017-10-18 VGND stuff
    We need to dig a bit into the analog stuff.
    For now MAX504 must be used to zero VGND.
    Possible bodge is to use the free general purpose op-amp to buffer VGND.
    [app.c]
2017-10-30 manual: Stuff about measuring resistances and regulators
    Some boards did not come out of the over quite right..
2017-10-30 manual: Add bit about checking fm9 rails
2017-10-30 app: Reduce VGND swing to +-0.5V, leave at VGND=0 when stopped
2017-11-13 Attempt to configure ADC properly
2017-11-13 Stealing code from shaker, SPI @ 57600 bps
2017-11-14 Make it work. PD6 was being used elsewhere
    Add missing RESET delay too
    [app.c]
2017-11-20 Invent a framing format
    BEGIN
    *FRAMENAME
    ...
    END
    Added some checks on setting motor PWMs while I was at it
2017-11-20 I use cat to interface /dev/ttyUSB0 now, so we can require newline for all commands
    This also allows aborting with ESC even for commands that don't take arguments
2017-11-20 Update manual, shorten some response types
    [app.c]
2017-11-26 Remove alternative ADC code
2017-11-27 Stabilize adc_wakeup(), report temperatures
    [app.c]
2017-11-27 Replace BEGIN/END with BUSY/READY
    READY is only output when the instrument accepts new commands.
    Generate new PDF. Keep images out of them for now so our .git dir doesn't grow huge.
    [app.c]
2017-12-08 SAMPLES format 2
2017-12-11 Add some prints in WAKEUP, sei() earlier
2017-12-11 Set ADC_ENA=0 to fully disable ADC, don't bother with LOCK
2017-12-11 Send SAMPLES in background, up sample_data to 2x16383 bytes
2017-12-11 Add sample compression (sample_fmt = 1)
    Manual is going to need a bit of a restructuring soon
2017-12-12 Blank credits
    [credits.kicad_pcb, credits.sch]
2017-12-12 Oops, don't put an enum in sample_packet_header_s
    Fix Makefile while we're at it
    [sample_packet_s.h]
2017-12-18 Better E printing
2017-12-18 Fix WAKEUP issues, optimize INT7_vect
    [app.c]
2017-12-18 Fix 24->8-bit conversion
    Got some weird issues with local variables not working..
    [app.c]
2017-12-18 It seems sign extension was the problem
    Shouldn't be necessary when shifting uint8_t up sixteen bit into __int24 but whatever.
    This seems to work fine.
    [app.c]
2018-01-15 Move measuring first_frame to main thread
    This prevents the ISRs from fighting eachother
    [app.c]
2018-01-15 Run Timer3 at same speed as Timer1
2018-01-15 Sync up Timer1 and Timer3
2018-01-15 Fix a whole bunch of stuff
    Most notably we were running the ADC @ 56 kbaud 😅
    [app.c, sample_packet_s.h]
2018-01-15 Inline/rearrange SPDR stuff in INT7 ISR
    This gets us up to 19.2 kHz sampling rate for single-channel operation,
    no more than 14.4 kHz if we allow TIMER1 OVF to occur inside.
    With four channels we can do up to 9.6 kHz
    Some timings:
    1 channel 24-bit SPI transfer
    minimum: 13.0 µs
    measured: 19.2 µs
    4 channel 24-bit SPI transfer
    minimum: 32.5 µs
    measured: 45.6 µs
    This means around 336 cycles just for the SPI transfer in the worst case.
    We could increase the transfer speed by using a faster XTAL.
2018-01-16 Fix how ADC_ENA interacts with wreg()
    [app.c]
2018-01-16 Separate packet/sample sizes, do compression during bsend
2018-01-16 cp fieldmill9 fieldmill10
    [channel.sch, fieldmill10.kicad_pcb, fieldmill10.sch, tachs.sch, vreg.sch]
2018-01-16 fieldmill10: Add F.Mask squares in corners matching fieldmill_top_plate4
    This demonstrates the source of those pesky short circuits.
    Obviously this version of the board must have them clear of any traces
    [fieldmill10.kicad_pcb]
2018-01-16 Add o/O commands for setting MAX504 voltages + manual entries
2018-01-23 fieldmill10: Fix Sallen-Key topology
    [tachs.sch]
2018-01-23 fieldmill10: Remove second MAX504, C17 <- 10µ
    [channel.sch, fieldmill10.sch, tachs.sch, vreg.sch]
2018-01-23 fieldmill10: Set M0..M2, NANOSMD -> 1206 0 Ohm, 56 nH -> 0603
    [channel.sch, fieldmill10.sch, tachs.sch, vreg.sch]
2018-01-23 fieldmill10: U7 -> Housings_SOIC:SOIC-14, C6 -> 1nF
    SMD_Packages:SOIC-14_N seems to have the wrong dimensions.. >:(
    [tachs.sch]
2018-01-23 fieldmill10: Make ERC pass
    [channel.sch, fieldmill10.sch]
2018-01-28 fieldmill10: Add option for fixed TACH threshold
    [tachs.sch]
2018-02-01 fieldmill10: Scope out some better 100M resistors
    [channel.sch]
2018-02-01 fieldmill10: Add note about new LDOs
    We want to move toward having only a single pair of regs.
    Having multiple small ones was a bad idea.
    [fieldmill10.sch]
2018-02-06 fieldmill10: Switch from lots of SOT-23 +-2.5V regs to a single pair of SOT-223:s
    LM1117 and LM337 specifically.
    [channel.sch, fieldmill10.sch, tachs.sch, vreg.sch]
2018-02-06 Add Würth 36903205S footprint
2018-02-06 Make use of the shields..
    [channel.sch, fieldmill10.sch, tachs.sch]
2018-02-12 fm10: Remove everything on top layer, switch to 4 layers
    Made the top layer behave like 'only parts on bottom layer' except we allow F.Mask
    [fieldmill10.kicad_pcb]
2018-02-12 fm10: Clear top layer of most holes
    [channel.sch, fieldmill10.kicad_pcb, fieldmill10.sch]
2018-02-13 fm10: Re-add ADG601
    Best to leave the footprint and make it a virtual component,
    bypassing it with 0 ohm by default.
    [channel.sch, fieldmill10.sch, tachs.sch]
2018-02-19 fm10: Add manual redmine, adjust some caps and resistors
    Brought back R14 to 1M and R3 to 10k to match fm9. We need to test that these are OK before making such changes.
    [channel.sch, fieldmill10.sch, tachs.sch]
2018-02-19 fm10: Put in part numbers for elfa, farnell, mouser and digikey
    [channel.sch, fieldmill10.sch, tachs.sch]
2018-02-19 fm10: Switch to CRHV1206AF100MFK
    [channel.sch, fieldmill10.sch, tachs.sch]
2018-02-27 Add footprint + 3D for Murata KCM55L series
2018-03-06 rm old
    [Komponentlista 3.ods, UmeaLunarVenture3.kicad_pcb, UmeaLunarVenture3.sch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]
2018-03-12 fm9: Show actual filter config due to bork S-K, show note about U17 not populated
    [tachs.sch]
2018-03-12 fm9: R20 is 10k now, update some text too
    [tachs.sch]
2018-03-12 Add Würth 7687709332 footprint + 3D
2018-03-12 fm10: Add motor supply filter
    [fieldmill10.sch, motor_filter.sch]
2018-03-12 fm10: LPPB032NFSP-RC part numbers for IR2
    [tachs.sch]
2018-03-12 fm10: Assign footprints to motor filter components
    [motor_filter.sch]
2018-03-12 fm10: Silver mica and film caps in analog frontend
    [channel.sch, fieldmill10.sch, motor_filter.sch, tachs.sch]
2018-03-13 fm10: Switch 100n to film caps
    These are 1210 size. There are 0805 size film caps, but they can only be sources from digikey
    Added some 100n film caps around ADC, and across DAC ref cap
    [channel.sch, fieldmill10.sch, motor_filter.sch, tachs.sch]
2018-03-13 fm10: Switch 10n to film caps
    Same brand as the other film caps (Panasonic)
    [fieldmill10.sch, tachs.sch]
2018-03-13 fm10: Switch all ceramics to soft termination, automotive grade
    Add fab instructions too, in case substitutions have to be made
    [channel.sch, fieldmill10.sch, motor_filter.sch, tachs.sch]
2018-03-13 Add document used for surveying large SMD inductors
    [inductors.ods]
2018-03-13 fm10: Sensor vias -> blind
    [fieldmill10.kicad_pcb]
2018-03-14 fm10: Six layers, trying to work out how to route the high impedance traces to the right places
    Rhyme semi-intended
    [fieldmill10.kicad_pcb]
2018-03-19 fm10: Layout high impedance traces
    [fieldmill10.kicad_pcb]
2018-03-19 fm10: Rough placement of largest parts
    [fieldmill10.kicad_pcb]
2018-03-19 fm10: Fix central GND circle vias net being ""
    [fieldmill10.kicad_pcb]
2018-03-19 fm10: Start setting up internal high impedance traces..
    [fieldmill10.kicad_pcb]
2018-03-19 fm10: Fix blind via nets going to sensors
    [fieldmill10.kicad_pcb]
2018-03-19 fm10: Replace IR2 NPTHs with hackish Z-drill
    These are copper-less blind vias that extend from B.Cu to In2.Cu.
    They should not break In1.Cu. This is very important.
    [fieldmill10.kicad_pcb]
2018-03-19 fm10: Same treatment for LPPB122NFSP-RC holes
    [fieldmill10.kicad_pcb]
2018-03-19 fm10: Repour copper
    [fieldmill10.kicad_pcb]
2018-03-20 WIP credits
    [credits.kicad_pcb]
2018-03-20 credits: Rescue, add mirrored 2x12 footprint
    [credits.kicad_pcb, credits.sch]
2018-03-20 Lägg till uggla
    [credits.kicad_pcb]
2018-03-20 fm10: Shrink outline to 83x83 mm
    Can't make it smaller unless we also modify the top aluminium plate
    [fieldmill10.kicad_pcb]
2018-03-20 fm10: Position +2v5 reg, add note about via aspect ratio
    [fieldmill10.kicad_pcb]
2018-03-20 fm10: Up existing vias to 0.6/0.9 mm
    [fieldmill10.kicad_pcb]
2018-03-20 fm10: Moar work
    [fieldmill10.kicad_pcb]
2018-03-20 fm10: VGND under cans, position parts around ADC
    [fieldmill10.kicad_pcb]
2018-04-05 fm10: ch2 stitched
    Might want to improve the stitching around L6/L8
    [fieldmill10.kicad_pcb]
2018-04-05 fm10: ch3..
    [fieldmill10.kicad_pcb]
2018-04-05 fm10: Shrink polys, motor depth is 3.6~3.7 mm
    [fieldmill10.kicad_pcb]
2018-04-05 fm10: NCAB wants 0.2 mm annular ring for general class
    This breaks DRC obviously. Time to reroute!
    [fieldmill10.kicad_pcb]
2018-04-05 0.6 mm vias -> 0.7 mm
    [fieldmill10.kicad_pcb]
2018-04-05 Remove all blind vias except those connecting the sensors
    [fieldmill10.kicad_pcb]
2018-04-05 Remove all inner segments on In1, In3 and In4
    [fieldmill10.kicad_pcb]
2018-04-05 Up remaining blind vias to 0.7 pad
    [fieldmill10.kicad_pcb]
2018-04-05 Make DRC pass again
    [fieldmill10.kicad_pcb]
2018-04-05 Make deeper blind vias 0.7 mm, clean up
    [fieldmill10.kicad_pcb]
2018-04-05 Up clearance to 0.2 mm
    [fieldmill10.kicad_pcb]
2018-04-05 Reroute ch2 guard
    [fieldmill10.kicad_pcb]
2018-04-06 Improve ch2 a bit
    [fieldmill10.kicad_pcb]
2018-04-06 Do the same thing with ch3
    [fieldmill10.kicad_pcb]
2018-04-06 aand ch1
    [fieldmill10.kicad_pcb]
2018-04-06 Extend some blind vias from In3 down to In4 and/or B
    [fieldmill10.kicad_pcb]
2018-04-06 Merge blind vias
    python3 merge_blind_vias.py fieldmill10.kicad_pcb > temp.sed && \
    sed -i -f temp.sed fieldmill10.kicad_pcb
    [fieldmill10.kicad_pcb]
2018-04-06 Missed one via due to tolerances
    [fieldmill10.kicad_pcb]
2018-04-06 Via fence inside ch3
    [fieldmill10.kicad_pcb]
2018-04-06 Via fence one more channel
    [fieldmill10.kicad_pcb]
2018-04-06 Last one \o/
    [fieldmill10.kicad_pcb]
2018-04-07 Shrink copper fill around cans
    [fieldmill10.kicad_pcb]
2018-04-07 Move silk labels under cans to on top of solder mask
    [fieldmill10.kicad_pcb]
2018-04-09 Finish placing components, add thermal copper fill for +-2.5V regs
    [fieldmill10.kicad_pcb]
2018-04-16 Update LPPB122 footprints on cpu3 and credits
    [cpu3.kicad_pcb, credits.kicad_pcb]
2018-04-17 [WIP] Try to route all signals
    clean it up later
    [fieldmill10.kicad_pcb]
2018-04-18 fm10: Add fit_field for KiBoM
    [channel.sch, fieldmill10.sch, motor_filter.sch, tachs.sch]
2018-04-18 fm10: Fix various part numbers, generate pretty BOM
    More than likely not the final version
    [channel.sch, fieldmill10.sch, tachs.sch]
2018-04-20 More BOM stuff
    [channel.sch, fieldmill10.sch, motor_filter.sch]
2018-04-20 Unfuck inner guard vias
    Drills had gotten pushed into eachother somehow
    [fieldmill10.kicad_pcb]
2018-04-23 Restrict Z drill to below In2.Cu
    This way we can have vias down to In2.Cu to connect either side of the SMD headers
    [fieldmill10.kicad_pcb]
2018-04-23 Update date, repour
    [fieldmill10.kicad_pcb]
2018-04-24 Make virtual parts smd, let BOM/PnP filter take care of this
    [fieldmill10.kicad_pcb]
2018-04-24 PnP filter script
2018-04-24 CSV fab BOM
    [fieldmill10_.csv]
2018-04-24 Screw it, let's grind the pin headers down if they're too long
    We can do the fitting in Fusion360
    [fieldmill10.kicad_pcb]
2018-04-24 rm power3 fieldmill_top_plate3 fieldmill8 cpu2
    [bom_pcb.csv, channel.sch, connectors.sch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]
2018-04-24 Route horizontals @ headers, thicken some power traces
    [fieldmill10.kicad_pcb]
2018-04-24 Make all power traces thicker, fewer and shallower vias
    [fieldmill10.kicad_pcb]
2018-04-24 Everything connected
    [fieldmill10.kicad_pcb]
2018-04-25 Make all In3.Cu-B.Cu vias 0.5 mm
    [fieldmill10.kicad_pcb]
2018-04-25 Same thing for In2.Cu-B.Cu
    [fieldmill10.kicad_pcb]
2018-04-25 Fix DRC
    [fieldmill10.kicad_pcb]
2018-04-25 Get 3D model into LPPB122NFSP
    [fieldmill10.kicad_pcb]
2018-04-25 Simplify BOM: 1k2 -> 1k
    [fieldmill10.kicad_pcb, fieldmill10_.csv, tachs.sch]
2018-04-25 Design rules for new stackup
    [fieldmill10.kicad_pcb]
2018-04-26 Prepare for moving buried vias
    [fieldmill10.kicad_pcb]
2018-04-26 Seems to work fine
    [fieldmill10.kicad_pcb]
2018-04-26 layers In1.Cu B.Cu too
    [fieldmill10.kicad_pcb]
2018-04-26 Ground vias will need to go do In3.Cu by stacked microvias
    [fieldmill10.kicad_pcb]
2018-04-26 Hook up VGNDs, repour GND plane on In3
    [fieldmill10.kicad_pcb]
2018-04-26 Clean up In1.Cu
    [fieldmill10.kicad_pcb]
2018-04-26 Enlarge, connect In1 guard to In2 guards
    [fieldmill10.kicad_pcb]
2018-04-26 Connect to VGND driver, multiple staggered microvias
    [fieldmill10.kicad_pcb]
2018-04-26 Staggered microvias bring down sensor signals
    [fieldmill10.kicad_pcb]
2018-04-26 Reconnect guard fences inside cans
    [fieldmill10.kicad_pcb]
2018-04-26 All In4-B vias -> microvias
    [fieldmill10.kicad_pcb]
2018-04-26 Stagger feeds to ops
    [fieldmill10.kicad_pcb]
2018-04-26 Stagger most InIn3-B
    [fieldmill10.kicad_pcb]
2018-04-26 Missed some
    [fieldmill10.kicad_pcb]
2018-04-26 More stitching
    [fieldmill10.kicad_pcb]
2018-04-26 More stitching around U4
    [fieldmill10.kicad_pcb]
2018-04-26 Smaller thermals on exposed copper areas
    [fieldmill10.kicad_pcb]
2018-04-26 Moar stitching
    [fieldmill10.kicad_pcb]
2018-04-26 Finish stitching under cans
    [fieldmill10.kicad_pcb]
2018-04-26 Clean up in In3 and In4
    [fieldmill10.kicad_pcb]
2018-04-26 Stitch In3-In4
    [fieldmill10.kicad_pcb]
2018-04-26 Stich In1-In2
    Some finger slips -> vias instead of inner vias. Fixing that soon
    [fieldmill10.kicad_pcb]
2018-04-26 Fix the via issue
    [fieldmill10.kicad_pcb]
2018-04-27 Fix B.SilkS
    [fieldmill10.kicad_pcb]
2018-04-27 Make In3.Cu GND pour better
    [fieldmill10.kicad_pcb]
2018-04-27 Pour most of In4.Cu
    Better copper balance
    [fieldmill10.kicad_pcb]
2018-04-27 Pour more copper on B.Cu
    [fieldmill10.kicad_pcb]
2018-05-02 Fyrdubbla vior på signalgenomföringar
    [fieldmill10.kicad_pcb]
2018-05-02 Extra mikrovior In3-In4-B också
    [fieldmill10.kicad_pcb]
2018-05-02 Thicken som traces to 0.3 mm
    [fieldmill10.kicad_pcb]
2018-05-02 Some more
    [fieldmill10.kicad_pcb]
2018-05-02 Shorten SCLK
    [fieldmill10.kicad_pcb]
2018-05-02 Fix some things on In1.Cu/In2.Cu
    [fieldmill10.kicad_pcb]
2018-05-02 B.Cu cleanup
    [fieldmill10.kicad_pcb]
2018-05-02 Make In4.Cu pour a bit better, add missing GND in bottom right
    [fieldmill10.kicad_pcb]
2018-05-02 Do not fit LED
    [tachs.sch]
2018-05-03 Double up on some more microvias
    [fieldmill10.kicad_pcb]
2018-05-03 Fiddle fiddle
    Keeping traces and vias further away from motor
    All microvias should now be doubled
    [fieldmill10.kicad_pcb]
2018-05-03 Enlarge VGND fills on In4.Cu
    [fieldmill10.kicad_pcb]
2018-05-03 More VGND vias. Lots more
    [fieldmill10.kicad_pcb]
2018-05-03 Conform pcb module attributes (virtual vs insert) to BOM
    Also newly generated BOMs
    [fieldmill10.kicad_pcb, fieldmill10_.csv]
2018-05-03 Remove paste for virtual components, generate gerbers
    Probably not final fab output, will have to go through a few feedback cycles
    [fieldmill10-B.Cu.gbl, fieldmill10-B.Mask.gbs, fieldmill10-B.Paste.gbp, fieldmill10-B.SilkS.gbo, fieldmill10-Edge.Cuts.gm1, fieldmill10-F.Cu.gtl, fieldmill10-F.Mask.gts, fieldmill10-front-inner1.drl]
2018-05-04 Try to organize things in revisions
    [fieldmill10-B.Cu.gbl, fieldmill10-B.Mask.gbs, fieldmill10-B.Paste.gbp, fieldmill10-B.SilkS.gbo, fieldmill10-Edge.Cuts.gm1, fieldmill10-F.Cu.gtl, fieldmill10-F.Mask.gts, fieldmill10-front-inner1.drl]
2018-05-04 Some old regulator survey documents
    [LDOs.ods]
2018-05-04 Switch to LTC6241HS8#TRPBF
    All parts should now tolerate up to +125°C
    [channel.sch]
2018-05-04 Conform pcb and BOM files to .sch
    [fieldmill10.kicad_pcb, fieldmill10_.csv]
2018-05-04 BOM in fab preferred format
    [BOM-lista.xlsx]
2018-05-04 Avoid space in IR2 component value
    [fieldmill10-B.Cu.gbl, fieldmill10-B.Mask.gbs, fieldmill10-B.Paste.gbp, fieldmill10-B.SilkS.gbo, fieldmill10-Edge.Cuts.gm1, fieldmill10-F.Cu.gtl, fieldmill10-F.Mask.gts, fieldmill10-front-inner1.drl]
2018-05-04 Rename so zipfile becomes fieldmill10-rev1.zip
    [BOM-lista.xlsx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]
2018-05-04 Update date
    [fieldmill10.kicad_pcb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]
2018-05-07 cp cpu3 cpu4
    [connectors.sch, cpu4.kicad_pcb, cpu4.sch, power.sch, xmem.sch]
2018-05-07 Add to footprint
2018-05-07 cpu4: Use the 3x12 variant
    [connectors.sch]
2018-05-07 cpu4: Move pin headers out 0.25 mm
    Adjust Edge.Cuts around the pin headers to match the next footprint
    Move lower right mounting hole up to the same level as the left mounting hole
    Change to LPPB122NFSP-RC footprint without all the extra holes, since the pins can't reach that far in
    [connectors.sch, cpu4.kicad_pcb, cpu4.sch, power.sch, xmem.sch]
2018-05-07 cpu4: rm U8
    [power.sch]
2018-05-08 fieldmill10: Rev2, matte black solder mask
    [BOM-lista.xlsx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]
2018-05-08 cpu4: Switch D2 and D8 to same SMA diode used in fm10
    [cpu4.kicad_pcb, power.sch]
2018-05-08 cpu4: Set fit_field to reflect soldered cpu3
    Makes it easier to decide what to nix in this revision
    [connectors.sch, cpu4.sch, power.sch, xmem.sch]
2018-05-08 cpu4: Update U10 to use 3D model, remove U8
    [cpu4.kicad_pcb]
2018-05-09 fm10: Add fiducials
    [fieldmill10.kicad_pcb]
2018-05-09 fm10: Generate rev3, with fiducials
    [BOM-lista.xlsx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]
2018-05-14 XMEM current draw results
    We can leave it on at all times, freeing PG3 for other tasks
2018-05-14 cpu4: Remove C9, C10, C36, change C34 to 100n
    There's more than enough bulk capacitance
    [cpu4.kicad_pcb, cpu4.sch, xmem.sch]
2018-05-14 cpu4: Change SCUBE:Resistor_1206_2010_combined to Resistors_SMD:R_1206
    We'll use NANOSMD's if we need any kind of polyfuses
    [connectors.sch, cpu4.kicad_pcb, cpu4.sch, xmem.sch]
2018-05-17 cpu4: Remove superfluous 0 Ohmers
    [cpu4.sch, xmem.sch]
2018-05-17 fm10-rev4: Fix BOM having extra sheets, derp
    Regenerate gerbers while we're at it, with updated date in bottom copper
    [BOM-lista.xlsx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]
2018-05-17 cpu4: Make PG3 configurable between EN_XMEM and A16
    A16 (bankswitching) is what we'll want now
    [connectors.sch, cpu4.sch, power.sch, xmem.sch]
2018-05-17 cpu4: Simplify
    Removed all unused configuration resistors
    Removed 100 nF caps on optional clock buffers
    EXTRA1..4 is no more
    Connected PD0..1 to TACH0..1
    Tied all EN_VGND together
    Made PF5..7 only do /CS_ADC0..2
    R41..43 -> 1206
    [connectors.sch, cpu4.sch, power.sch, xmem.sch]
2018-05-17 cpu4: Remove SD_IRQ, wire TACH0..1 to PE5..6
    [connectors.sch, cpu4.sch, power.sch]
2018-05-17 cpu4: Lock graphics
    [cpu4.kicad_pcb]
2018-05-17 cpu4: Move things away, delete traces, make DRC happy
    [cpu4.kicad_pcb, cpu4.sch]
2018-05-18 fm10: Fix STTH102A Elfa PN
    [fieldmill10.sch]
2018-05-18 fm10-rev5: Make BOM-lista.xlsx match .sch
    Color the changed cell green
    [BOM-lista.xlsx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]
2018-05-18 rm the older revisions
    rev4 is what was sent to the fab
    rev5 is what is actually being produced
    [BOM-lista.xlsx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]
2018-05-18 fm10-rev5: Match current part numbers
    [BOM-lista.xlsx]
2018-05-18 cpu4: Fit everything on the board
    Next up, try to move everything from the bottom side to the top
    [cpu4.kicad_pcb]
2018-05-21 Move credits from cpu4 to credits
    [cpu4.kicad_pcb, credits.kicad_pcb]
2018-05-21 cpu4: Nix ATmegaS128
    [cpu4.kicad_pcb, cpu4.sch]
2018-05-21 cpu4: Put everything except µSD on top layer
    Ripped up everything
    Removed some 0 Ohm and 100 nF parts
    [connectors.sch, cpu4.kicad_pcb, cpu4.sch, power.sch, xmem.sch]
2018-05-21 cpu4: Move silks around, don't fit µSD by default
    [connectors.sch, cpu4.kicad_pcb, cpu4.sch, power.sch, xmem.sch]
2018-05-21 cpu4: Set up easier-to-manufacture clearances
    [cpu4.kicad_pcb]
2018-05-21 cpu4: Start routing
    [cpu4.kicad_pcb]
2018-05-22 app: Implement 'v' command
    This required disabling pull-ups on ADC0..4.
    Accuracy is decent enough:
    *INFO
    +3.3V: +3.15 V (631)
    +24V: +23.36 V (584)
    VIN: +30.32 V (758)
    +5V: +4.83 V (690)
    -5V: -4.82 V (265)
    READY
    A few % off. VIN = 31.38.
    Should be better with resistors with known tolerance < 1%.
    [app.c, main.c]
2018-05-22 cpu4: Use 0.25 mm traces
    0.3 mm caused DRC issues somehow
    [cpu4.kicad_pcb]
2018-05-22 cpu4: Route more
    [cpu4.kicad_pcb, cpu4.sch]
2018-05-23 cpu4: Routed everything
    Might still tweak some things, like copper pour
    [cpu4.kicad_pcb]
2018-05-23 cpu4: Adjust pours
    [cpu4.kicad_pcb]
2018-05-23 Add 3D model for TMR 6-2421WI, add it to the footprint
    Footprint is still called RSO-2412D which is a bit ugly but eh
2018-05-23 cpu4: Make use of new 3D models
    [cpu4.kicad_pcb]
2018-06-01 Speed is actually pretty close to max, was just using 7 MHz for computing sample rates
    We're not going to do much better than 5 Mbps @ 14 MHz without hand optimized asm,
    if we *really* need the extra 40% speed.
2018-06-01 Clear ICn early, poll PE7 in square_demod_analog()
    At maximum sample rate we're cutting it quite close.
    /DRDY is high only for 1.2 µs with one ADC active @ 38.4 kHz,
    meaning roughly 16 cycles to check stat1_data, dec+check num_frames_left and start polling PE7.
    Replacing the SPIF loops in read_samples_fast() with hard-coded NOPs might now be appropriate..
2018-06-04 cpu4: Adjust silk, update TODOs
    [cpu4.kicad_pcb]
2018-06-08 Add support for 16-bit samples
    Kind of messy, but seems to work fine
2018-06-08 Use set_74153() when measuring motor speeds
2018-06-08 Binary option when using 16-bit samples
2018-06-15 fm10: Do not fit R8 -> 16-bit samples
    [fieldmill10.kicad_pcb, fieldmill10.sch]
2018-06-15 fm10: Reannotate
    [channel.sch, fieldmill10.sch, motor_filter.sch, tachs.sch]
2018-06-15 fm10: Remove R8 from fab files
    [BOM-lista.xlsx]
2018-06-15 mv rev5 -> rev4.1
    [BOM-lista.xlsx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]
2018-06-15 cpu4: Push some tracks around, repour
    [cpu4.kicad_pcb]
2018-06-15 cpu4: BOM 100n
    [cpu4.sch]
2018-06-15 cpu4: BOM 10u50V
    [power.sch]
2018-06-15 cpu4: BOM 10u25, revalue to 10u10V
    [cpu4.kicad_pcb, power.sch]
2018-06-15 cpu4: BOM 22p
    [cpu4.sch]
2018-06-15 cpu4: BOM TVSes
    [power.sch]
2018-06-15 cpu4: BOM diodes and polyfuse
    [power.sch]
2018-06-18 fm10: Rev 4.2
    [BOM-lista.xlsx]
2018-06-29 cpu4: Make top copper pour more connected
    [cpu4.kicad_pcb]
2018-07-02 cpu4: BOM ATmega128L-8AN
    [cpu4.sch]
2018-07-02 cpu4: Fix ERC
    [cpu4.sch]
2018-07-02 Add 1008 footprint used by Würth 74479887310A
2018-07-02 cpu4: BOM inductors, use L_1008 footprint, update PCB
    [connectors.sch, cpu4.kicad_pcb, cpu4.sch, power.sch, xmem.sch]
2018-07-02 cpu4: BOM FTSH-112-04-L-D-RA
    [connectors.sch]
2018-07-02 cpu4: BOM LPPB122NFSP-RC
    [power.sch]
2018-07-02 cpu4: BOM IRLL024NPBF, un-BOM screw holes
    [cpu4.sch, power.sch]
2018-07-02 cpu4: BOM PMBF170
    [connectors.sch]
2018-07-02 cpu4: BOM 71V124SA12YGI
    [xmem.sch]
2018-07-02 cpu4: BOM CD74AC153M96
    [cpu4.sch]
2018-07-02 cpu4: BOM DS18B20Z+ (replaces DS18B20Z)
    [cpu4.sch]
2018-07-02 cpu4: MAX485 uses some specific variant, we need to check what has been ordered before
    [power.sch]
2018-07-02 cpu4: BOM SN74AHC573DW
    [xmem.sch]
2018-07-02 cpu4: BOM THN 30-2415WI
    [power.sch]
2018-07-02 cpu4: BOM TMR 6-2421WI
    [power.sch]
2018-07-02 cpu4: BOM TSR 1-2433
    [power.sch]
2018-07-02 cpu4: We also need to check what make of crystal we're using
    [cpu4.sch]
2018-07-02 cpu4: bom.ini
2018-07-02 cpu4: Do inventory on expensive parts
    [cpu4.sch, power.sch]
2018-07-02 cpu4: BOM MAX3485CSA+
    [power.sch]
2018-07-02 cpu4: BOM crystal
    Made sure to use industrial grade rather than the current Auris part.
    [cpu4.sch]
2018-07-02 cpu4: Add temp ranges to parts
    [connectors.sch, cpu4.sch, power.sch, xmem.sch]
2018-07-02 cpu4: Replace MAX3485CSA+ with MAX3483ESA+, the industrial variant
    [power.sch]
2018-07-02 cpu4: Sync .sch and .kicad_pcb
    [cpu4.kicad_pcb]
2018-07-11 cp RSO-2412D_v2.kicad_mod TMR_6-2421WI.kicad_mod
    Else we get RSO* in the BOM which is probably confusing
2018-07-16 Getting close do done with cpu4-rev1.0
    [connectors.sch, cpu4.kicad_pcb, cpu4.sch, power.sch, xmem.sch]
2018-07-16 Update TODOs, fiddle with silk, fit_field 'lab' should be '+lab'
    [cpu4.kicad_pcb, power.sch]
2018-07-16 Sync virtuals and PnP to BOM, generated gerbers + PnP file
    [cpu4-B.Cu.gbl, cpu4-B.Mask.gbs, cpu4-B.SilkS.gbo, cpu4-Edge.Cuts.gm1, cpu4-F.Cu.gtl, cpu4-F.Mask.gts, cpu4-F.Paste.gtp, cpu4-F.SilkS.gto]
2018-07-16 Done with the PCB it seems
2018-07-16 Update schematic date, write assembly instructions, add note about TSR 0.5-2433
    [cpu4-lab_1.0.csv, cpu4.sch, cpu4_1.0.csv]
2018-07-16 Fixed a minor blemish
    [cpu4-B.Cu.gbl, cpu4-B.Mask.gbs, cpu4-B.SilkS.gbo, cpu4-Edge.Cuts.gm1, cpu4-F.Cu.gtl, cpu4-F.Mask.gts, cpu4-F.Paste.gtp, cpu4-F.SilkS.gto]
2018-07-16 BOM, 1% resistors
    [cpu4-lab_1.0.csv, cpu4_1.0.csv, cpu4_1.0.ods]
2018-07-16 mv 1.0 cpu4-1.0
    [cpu4-B.Cu.gbl, cpu4-B.Mask.gbs, cpu4-B.SilkS.gbo, cpu4-Edge.Cuts.gm1, cpu4-F.Cu.gtl, cpu4-F.Mask.gts, cpu4-F.Paste.gtp, cpu4-F.SilkS.gto]
2018-08-10 fieldmill10-rev4.3: Add fiducials to paste and PnP
    [fieldmill10.kicad_pcb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]
2018-08-10 cpu4-1.1: New top copper, add fiducials to paste and PnP
    [cpu4.kicad_pcb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]
2018-09-13 Tighten upp analog margins
    30..70% should give differential signals that always fit in int16_t
    [app.c]
2018-09-13 Wire version 3, more stats
    We have min, max, mean and mean absolute value.
2018-09-14 Change IQ computation, keeping result in int16_t range
    If we have 128k RAM we can cram 65535x 16-bit samples in there and still be in range.
2018-09-14 Upgrade fieldmill10 and cpu4 to KiCAD 5.0.0
    [channel.sch, connectors.sch, cpu4.sch, fieldmill10.sch, motor_filter.sch, power.sch, tachs.sch, xmem.sch]
2018-09-23 Add reel specs
    They're in Swedish, sorry
    [cpu4_reel_specs.ods, fieldmill10_reel_specs.ods]
2018-10-11 Wiggle VGND, providing some calibration
    This gives some shakiness in figure 6,
    likely due to VGND not settling soon enough.
2018-10-20 Switch back to 7.3728 MHz crystal
2018-10-31 manual: Fix pin assignment, add fm10 voltage ranges
2018-10-31 Print details of ROM, fixed RAM and stack use
    [app.c]
2018-11-07 Switch to WGM 14, Fast PWM
    This gives TIMER1_OVF at the same rate as WGM 7 with prescaler 8,
    but higher TCNT1 accuracy.
2018-11-07 Add FatFs AVR sample
    All unnecessary files removed, no changes yet.
2018-11-07 Patch in missing cast in ff.c, adapt to our needs
    [diskio.h, ff.c, ffconf.h, mmc_avr_spi.c]
2018-11-15 Fix another fm_map[] bug
    [app.c]
2018-11-19 Reuse r19 and r22, using sample_data addr to set up Z
2018-11-21 Read STAT_1PNS before capture(), print STAT_PN
    This fixes some issue when using more than one FM.
    It might just be that the new FM is a bit picky.
    Either way, we're only interested in errors during capture().
    [app.c]
2018-11-30 Add a thing about the resistance from AINP4 to GND
    One bad fm10 card had issues there
2018-11-30 Frama-C-ify capture()
    We'll be able to prove parts of the code correct this way
    [app.c, frama-c-stub.h]
2018-12-06 Set cb.num_frames and OCR1n[1..2] correctly
    [app.c]
2018-12-18 Update cpu4 and fieldmill10 with new 3d models
    [cpu4.kicad_pcb, fieldmill10.kicad_pcb]
2019-01-10 Make sample_data int16_t
2019-01-15 Picture of painted motors
2019-01-15 Add PnP files
    Not sure which revisions these belong to,
    most likely the latest
    [cpu4-pnp.csv, fieldmill10-pnp.csv]
2019-01-15 Add complete cpu4-1.1 instructions
    These should just be cpu4-1.0 with cpu4-1.1 copied on top
    [cpu4-B.Cu.gbl, cpu4-B.Mask.gbs, cpu4-B.SilkS.gbo, cpu4-Edge.Cuts.gm1, cpu4-F.Cu.gtl, cpu4-F.Mask.gts, cpu4-F.Paste.gtp, cpu4-F.SilkS.gto]
2019-01-16 Refactor capture_and_demod(), use tach mean as trigger level, output ratio between longest and shortest tach period
    [app.c, wire_structs.h]
2019-01-18 Change VGND slowly, print max_tach_ratio and max_max_tach_ratio
2019-01-21 Fix bug that caused weekend test to have no calibration (gah!)
    [feature_block.c]
2019-02-12 Mirrored LPPB122NFSP-RC without useless extra holes
2019-02-12 Mess around with credits
    [credits.kicad_pcb]
2019-02-14 Updates for latest test
    Delay between spinning each motor up, only print RPMs every 16 BLOCK
2019-02-14 Halve samplerate for 14:43 test
    We miss tachometer impulses if we don't
2019-02-15 Add temperatures, voltages and markers to capture_block_s
    Plus some other minor changes like allowing more than 255 entries̈́
2019-02-20 Add proven ADC code to voltages conversion code
    This is mostly to have markup that says how big the ADC code and voltage arrays should be
2019-02-20 feature_blocks: Fix reading temps, print temps and volts
    [app.c, feature_block.c, wire_structs.h]
2019-02-20 Add P1 .pbm to .kicad_mod converter
    Could use some optimizing, tends to mostly produce horizontal/vertical strips
2019-03-04 Alternate motor speeds, do calibration at end of blocks, add ability to output raw sample block
    Fixed a bug where the logic for first_round was flipped
    [app.c, feature_block.c, wire_structs.h]
2019-03-13 Remove debug pin stuff that interferes with TACH0 (PD0) and /DRDY0 (PE5)
    [app.c, feature_block.c]
2019-03-13 Fix PE5 state in bootloader too
    [main.c]
2019-03-13 Make main program use same pin settings as bootloader
    They're current out of sync until I reflash the bootloader.
    Had to remove -pedantic from the main program's CFLAGS, but given -std=gnu99 that's OK
2019-04-17 Remove the emojis
    They crash codelite
    [app.c]
2019-04-18 Forgot to compute NQ, compute nsum* instead
    For some reason WP isn't able to prove the behavior of NQ,
    and having an array for nsum* didn't work either.
    [verified.c, verified.h]
2019-04-23 Fix overflow issues, 16/32-bit mismatch
    [verified.c]
2019-04-25 Wait 3 seconds after changing motor speed before collecting data
    Either this or the previous commit is used for the raw31 test, I forget
2019-04-25 Longer capture blocks, less calibration
2019-04-25 Send raw block too
    Should take around 4 seconds, so no need for extra motor spin-up delay
2019-04-25 Recompute max_frames etc every round
    This needs to be done for the same RPM to be printed and other things
2019-04-27 Verify compute_max_frames() and rework some Frama-C things
    [app.c, feature_block.c, frama-c-stub.h, verified.c, verified.h]
2019-04-27 Verify parse64() and print64()
2019-05-02 Set motor speed *after* reading registers and printing stats
    This fixes a lock-up in capture()
    raw32.dat is this test
    [feature_block.c]
2019-06-20 Add horizontal 2x5 L-Tek connector w/ strain relief
2019-08-12 Add motor jam detection code
    This disables a jammed motor for a few minutes before attempting to unjam it
    A fancier solution would reverse the motor, but we don't have hardware support for that yet
    [feature_block.c]
2020-01-02 Fix rest of verification
    [frama-c-stub.h, verified.h]
2020-01-04 Verify init_cb_cbc()
    memcpy() doesn't work for some reason, SET_MARKER replaces it.
    [feature_block.c, verified.c, verified.h]
2020-01-05 Verify popcount, SPI communication stuff
2020-01-07 Switch to rreg_not_ena()
2020-01-07 Re-prove compute_sum_abs() with new machdep and switch back to unsigned because -warn-unsigned-overflow
2020-01-10 Fix build
    app.c has lots of code which is yet to be verified
    [app.c, verified.h]
2020-01-12 New proofs
    Seems switching model changes the name of the file, perhaps renaming the old ones is enough to port them.
2020-01-12 Change definition of valid_adc_configuration_part2() to something more sensible, prove more things
    accumulate_square_interval_2() needs some attention.
    set_block_motor_speed() now deals with wreg() failing.
    [typed_nocast_set_block_motor_speed_call_wreg_2_requires_4.json, typed_nocast_set_block_motor_speed_call_wreg_3_requires_4.json, typed_nocast_set_block_motor_speed_call_wreg_requires_4.json, typed_nocast_set_block_motor_speed_ensures_2.json]
2020-01-28 Scripts simplified via TIP, broken scripts removed
    [typed_nocast_set_block_motor_speed_call_wreg_2_requires_4.json, typed_nocast_set_block_motor_speed_call_wreg_3_requires_4.json, typed_nocast_set_block_motor_speed_call_wreg_requires_4.json, typed_nocast_set_block_motor_speed_ensures_2.json]
2020-01-29 Fix Frama-C warning about 2.56
    [verified.c]
2020-01-29 Re-verify setup_inner()
    Assigns in behaviors doesn't work so well
    [verified.c, verified.h]
2020-01-29 Re-run TIP
    [typed_nocast_set_block_motor_speed_call_wreg_2_requires_4.json, typed_nocast_set_block_motor_speed_call_wreg_3_requires_4.json, typed_nocast_set_block_motor_speed_call_wreg_requires_4.json]
